Asaadkaadan/MOWE/Documentation/Images/proj_speed_test_2.png

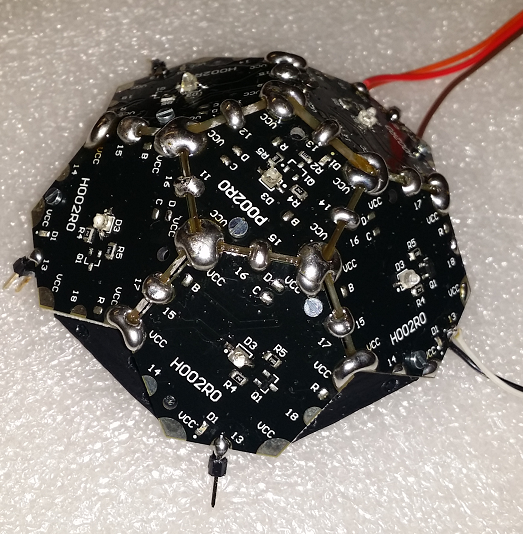
Documentation/Images/proj_speed_test_2.png
