Asaadkaadan/MOWE/Documentation/Images/proj_speed_test_1.png

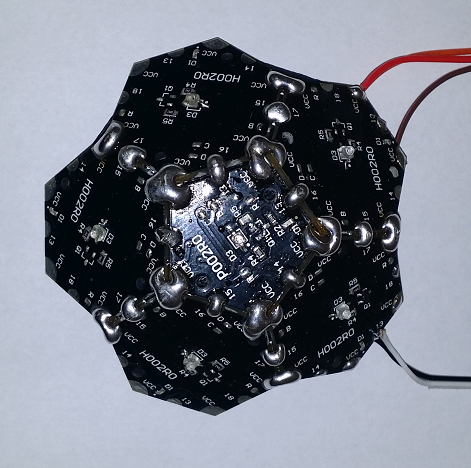
Documentation/Images/proj_speed_test_1.png
