Asaadkaadan/MOWE/Documentation/Images/bsubrun.gif

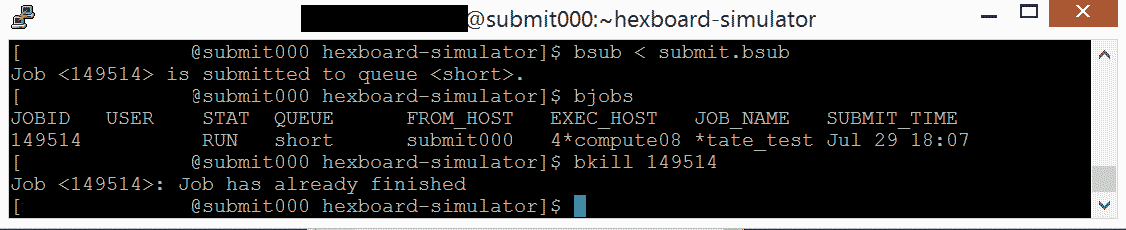
Documentation/Images/bsubrun.gif
