Asaadkaadan/MOWE/Documentation/Images/conn1.png

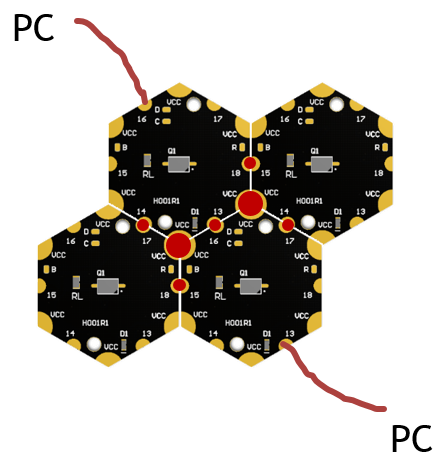
Documentation/Images/conn1.png
