Asaadkaadan/MOWE/Documentation/Images/conn2.png

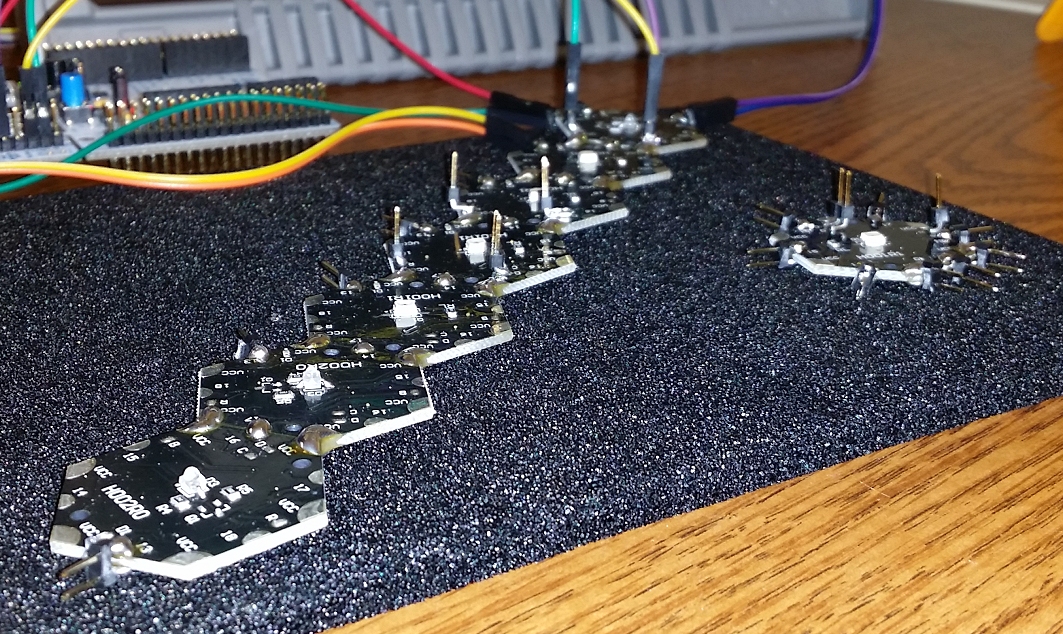
Documentation/Images/conn2.png
