Asaadkaadan/MOWE/Documentation/Images/conn3.png

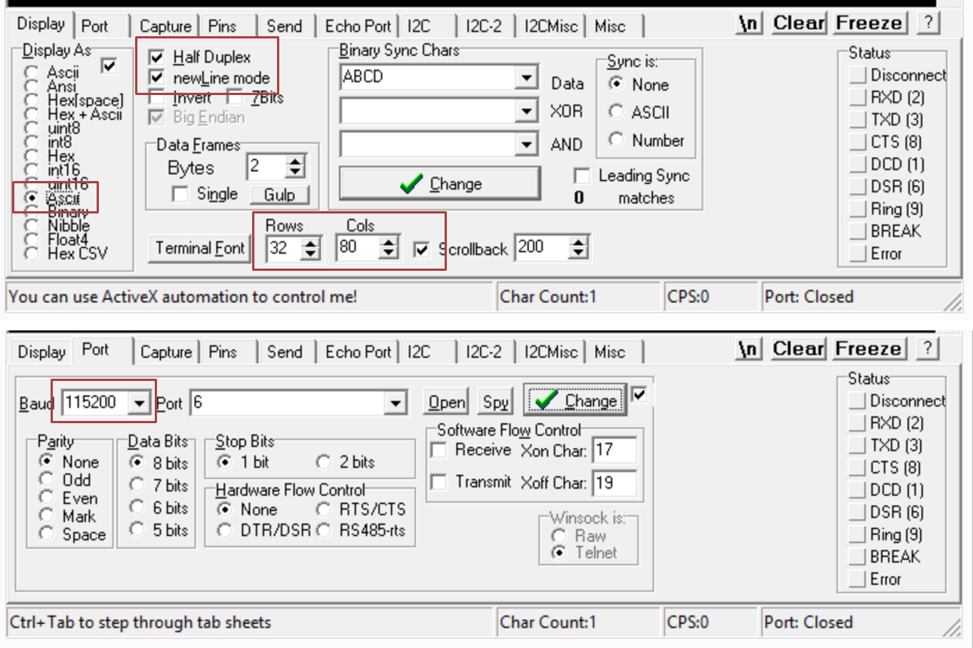
Documentation/Images/conn3.png
