Asaadkaadan/MOWE/Documentation/Images/conn4.png

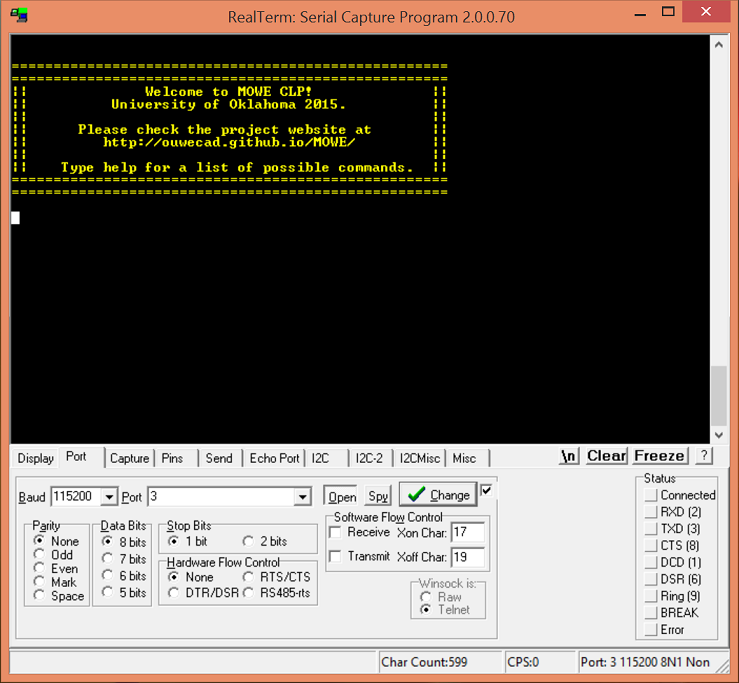
Documentation/Images/conn4.png
