Asaadkaadan/MOWE/Documentation/Images/Cygcheck.gif

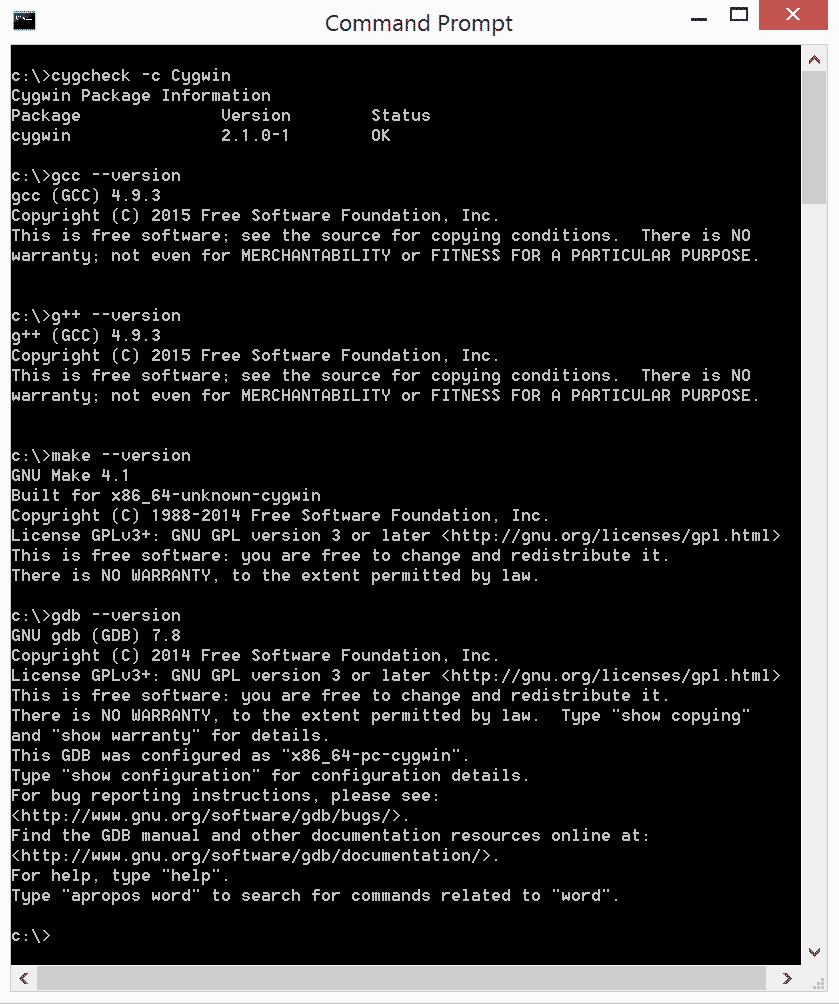
Documentation/Images/Cygcheck.gif
