Asaadkaadan/MOWE/Documentation/Images/CygwinOpenMPI.gif

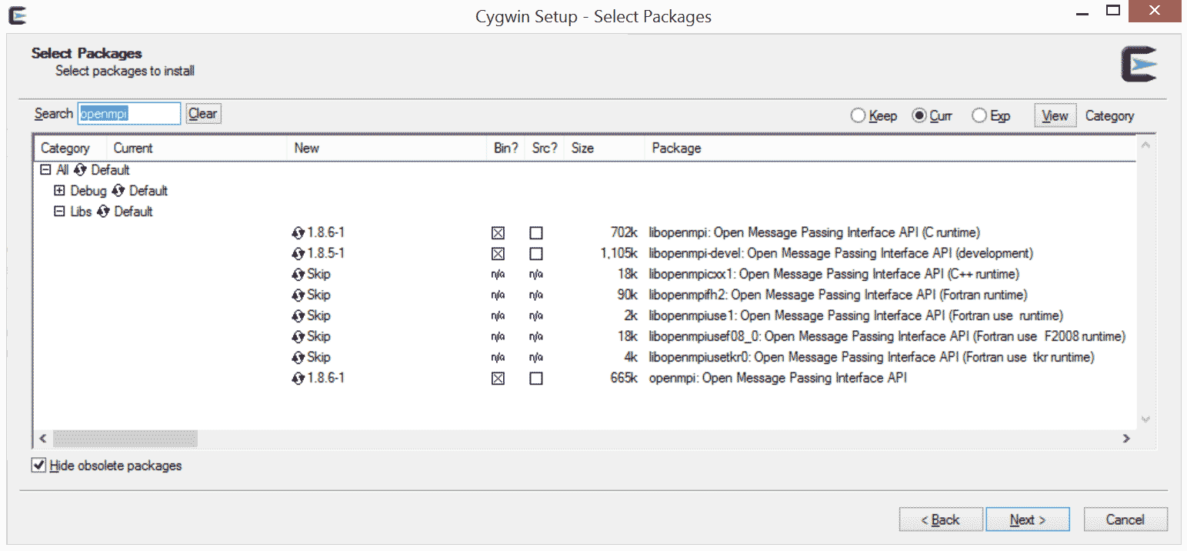
Documentation/Images/CygwinOpenMPI.gif
