Asaadkaadan/MOWE/Documentation/Images/Distance-VEMT3700-620Ohm-D25.png

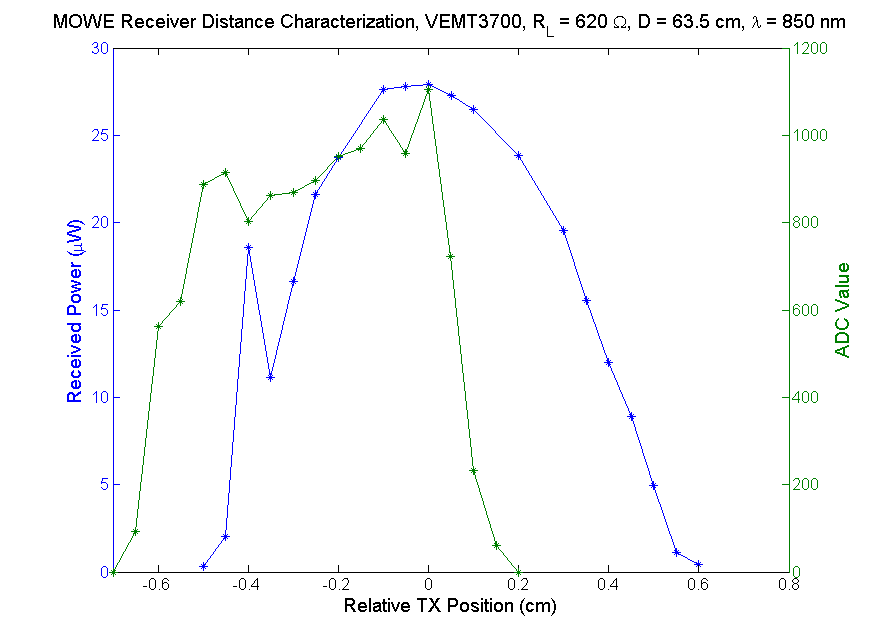
Documentation/Images/Distance-VEMT3700-620Ohm-D25.png
