Asaadkaadan/MOWE/Documentation/Images/Distance-VEMT3700-620Ohm-D43.png

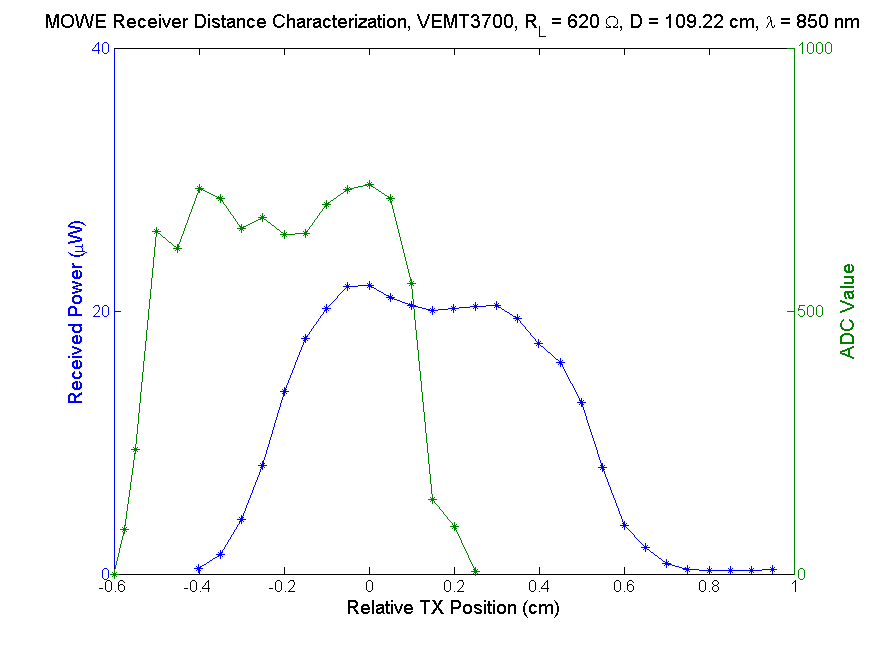
Documentation/Images/Distance-VEMT3700-620Ohm-D43.png
