Asaadkaadan/MOWE/Documentation/Images/Distance-VEMT3700-620Ohm-D64.png

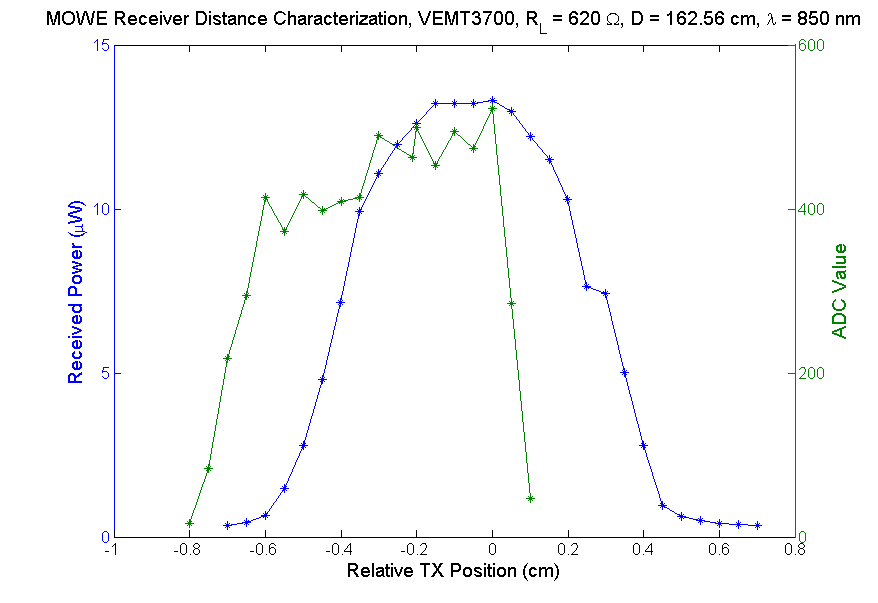
Documentation/Images/Distance-VEMT3700-620Ohm-D64.png
