Asaadkaadan/MOWE/Documentation/Images/Distance-VEMT3700F-620Ohm-D7.5.png

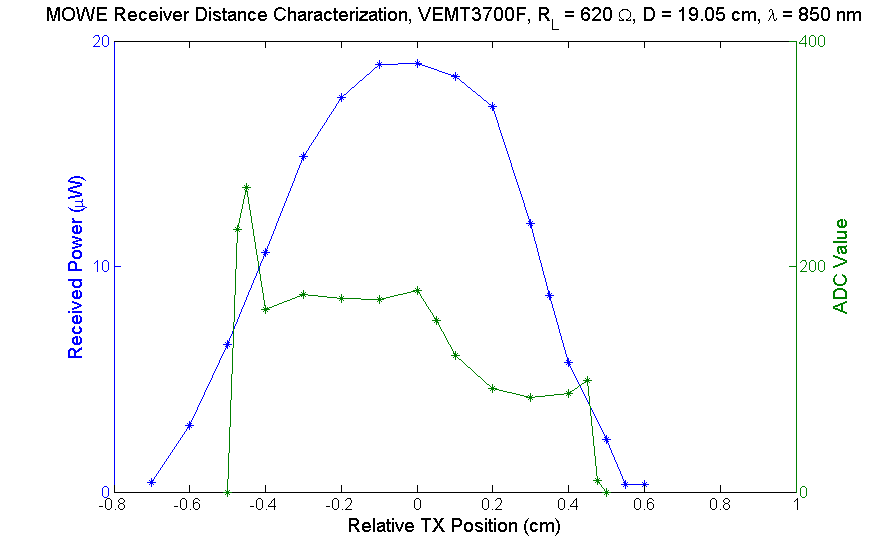
Documentation/Images/Distance-VEMT3700F-620Ohm-D7.5.png
