Asaadkaadan/MOWE/Documentation/Images/Distance-VEMT3700F-620Ohm-D64.png

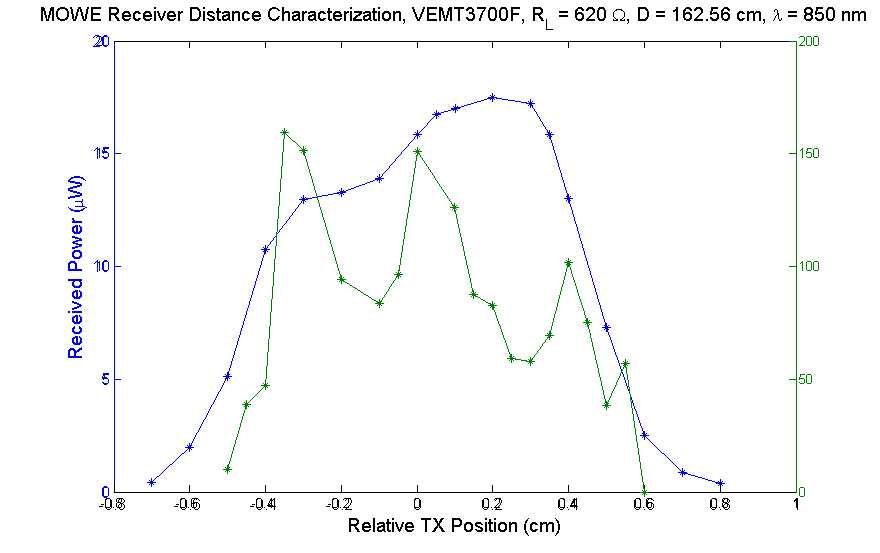
Documentation/Images/Distance-VEMT3700F-620Ohm-D64.png
