Asaadkaadan/MOWE/Documentation/Images/firm_boot.png

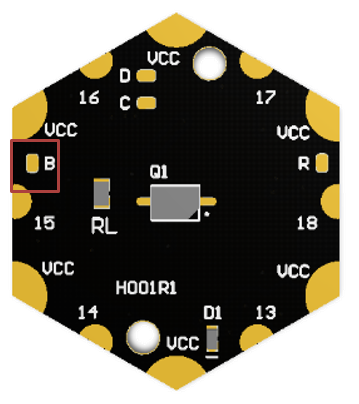
Documentation/Images/firm_boot.png
