Asaadkaadan/MOWE/Documentation/Images/Forge.gif

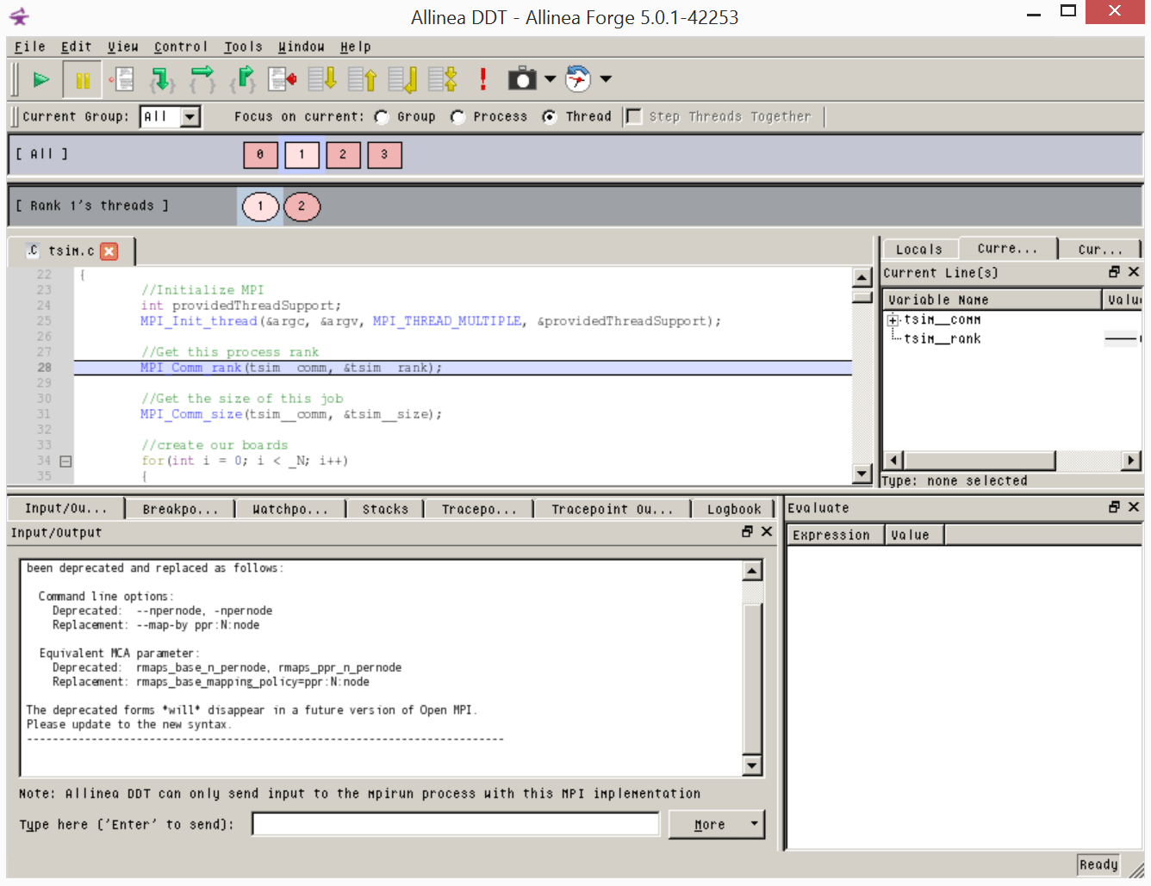
Documentation/Images/Forge.gif
