Asaadkaadan/MOWE/Documentation/Images/localrun1.gif

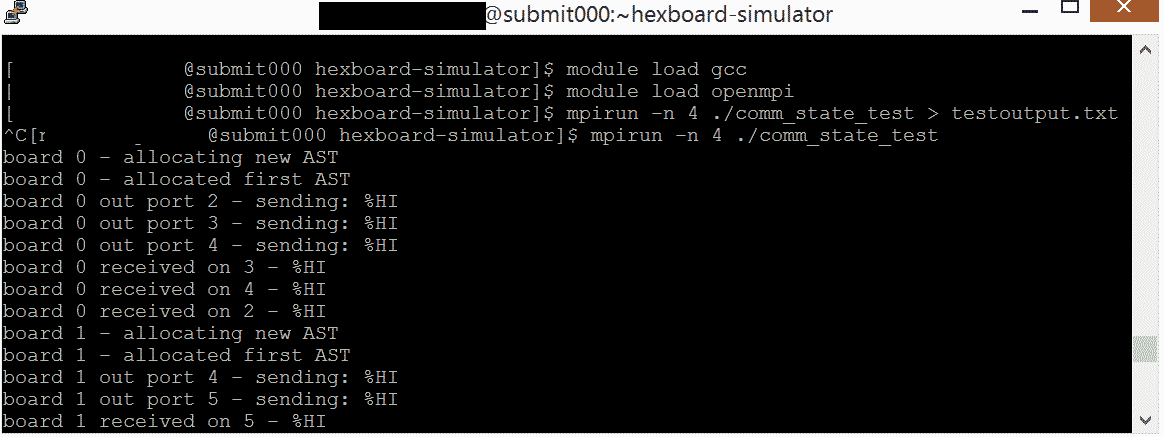
Documentation/Images/localrun1.gif
