Asaadkaadan/MOWE/Documentation/Images/localrun2.gif

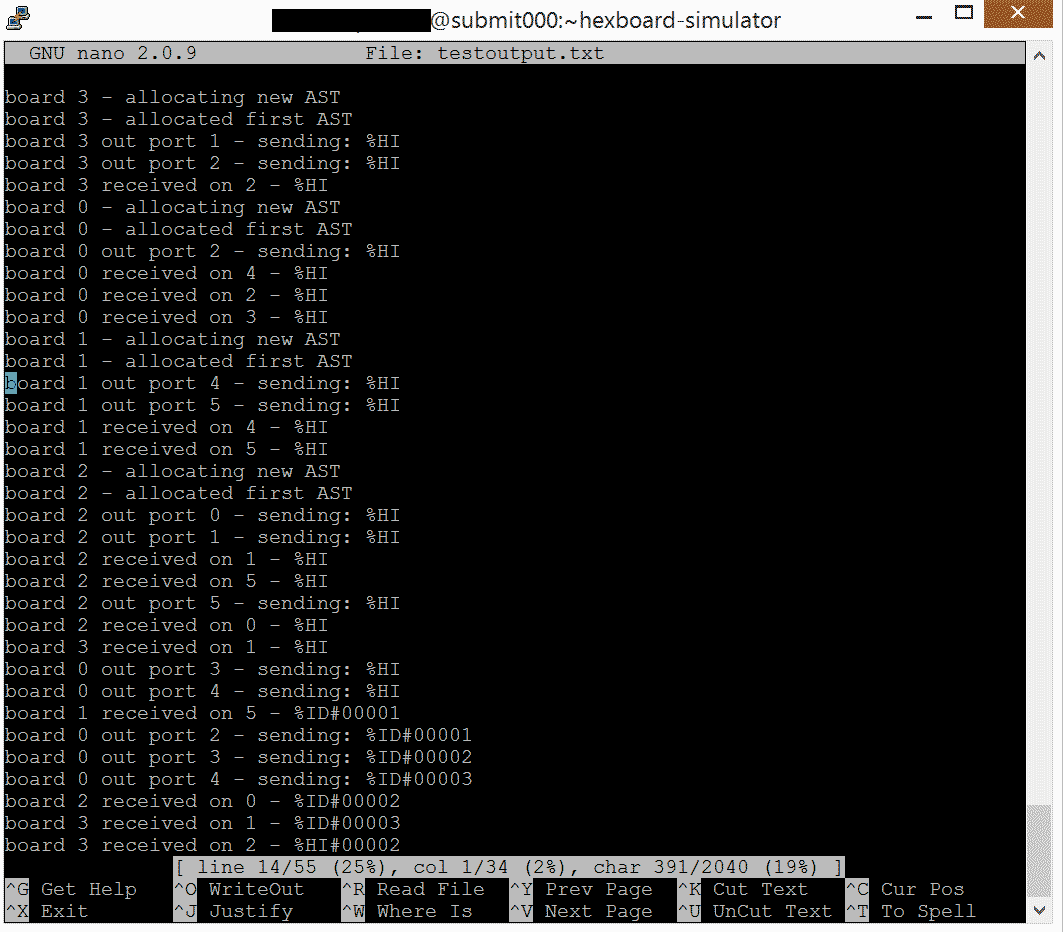
Documentation/Images/localrun2.gif
