Asaadkaadan/MOWE/Documentation/Images/Netbeans1.gif

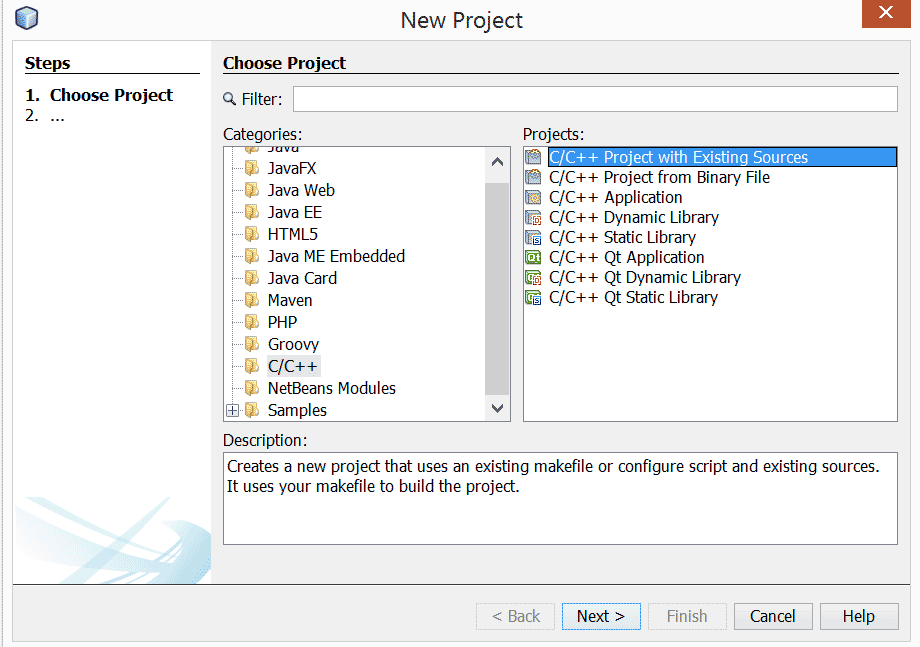
Documentation/Images/Netbeans1.gif
