Asaadkaadan/MOWE/Documentation/Images/Netbeans2.gif

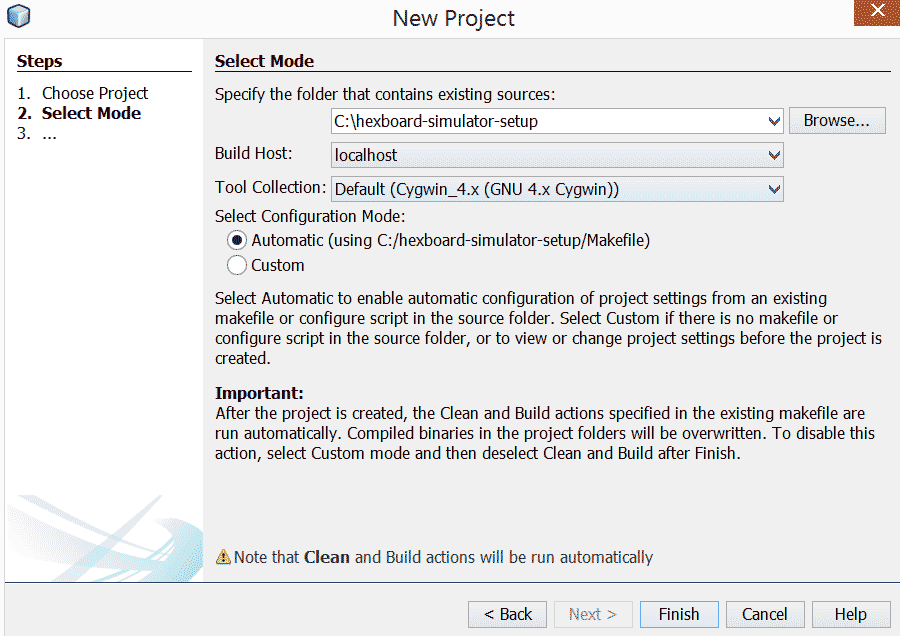
Documentation/Images/Netbeans2.gif
