Asaadkaadan/MOWE/Documentation/Images/Netbeans3.gif

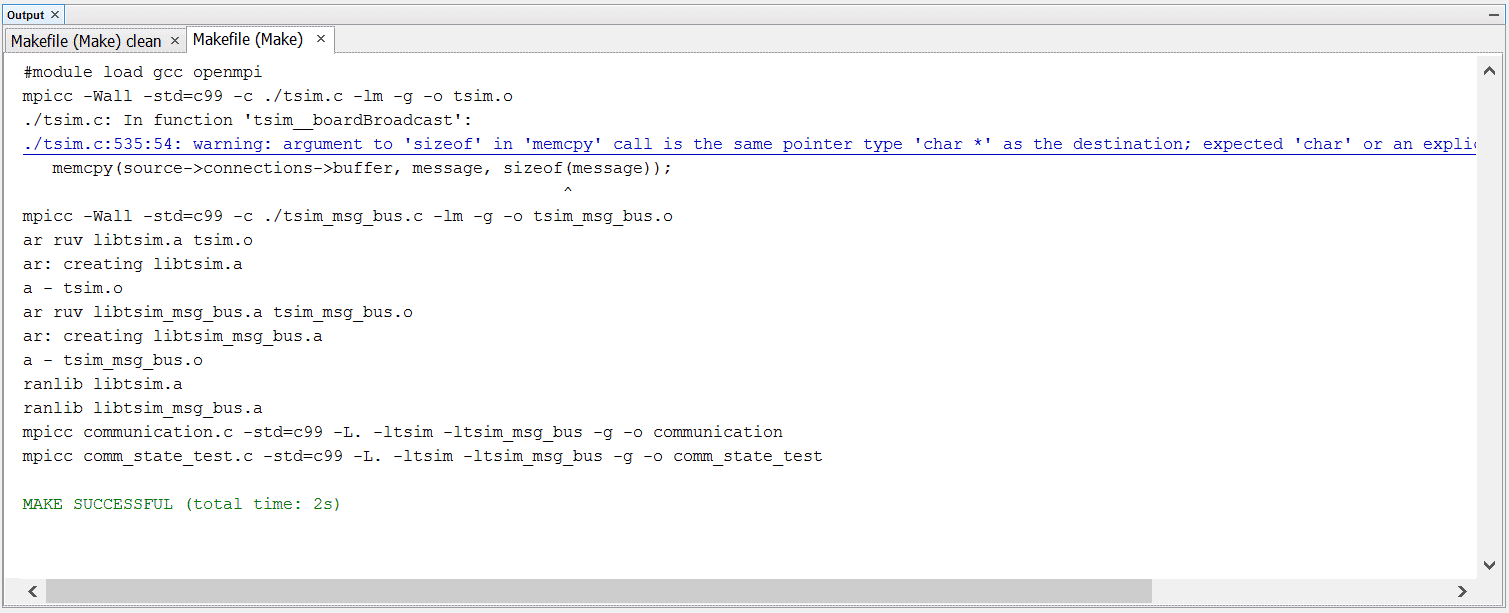
Documentation/Images/Netbeans3.gif
