Asaadkaadan/MOWE/Documentation/Images/NetbeansInterface.gif

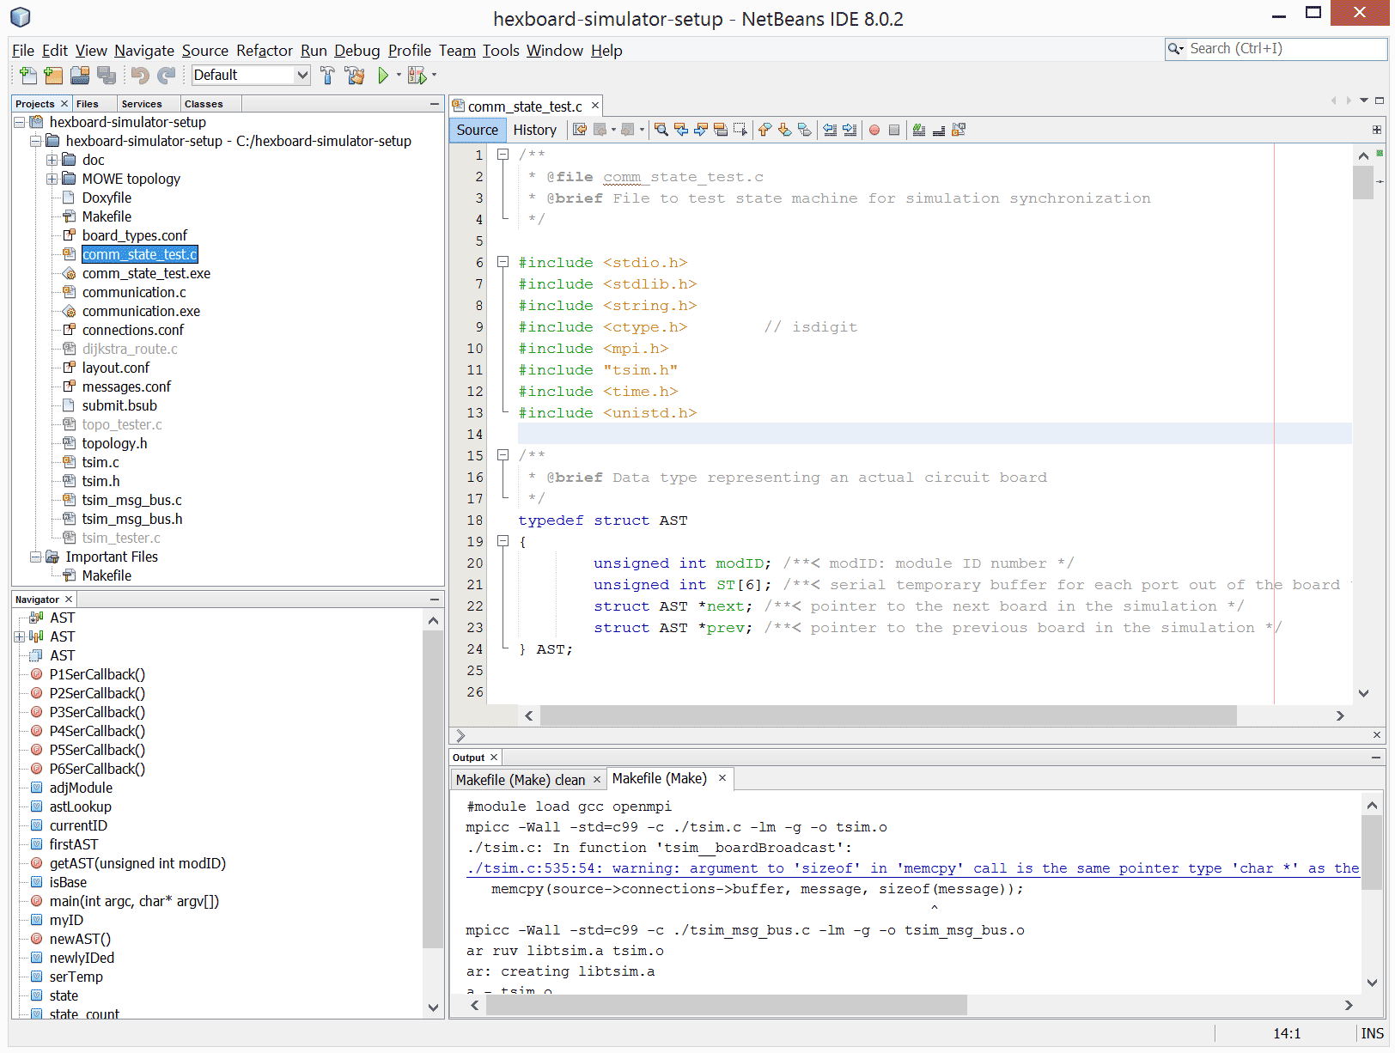
Documentation/Images/NetbeansInterface.gif
