Asaadkaadan/MOWE/Documentation/Images/overview.png

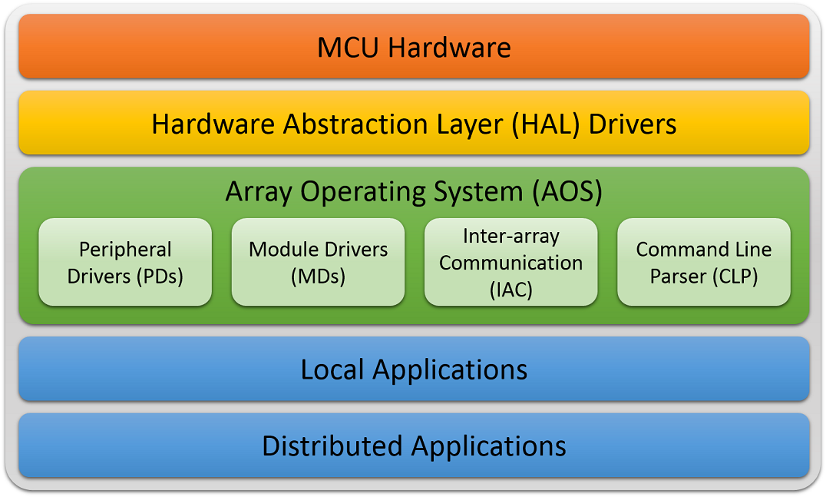
Documentation/Images/overview.png
