Asaadkaadan/MOWE/Documentation/Images/Path.gif

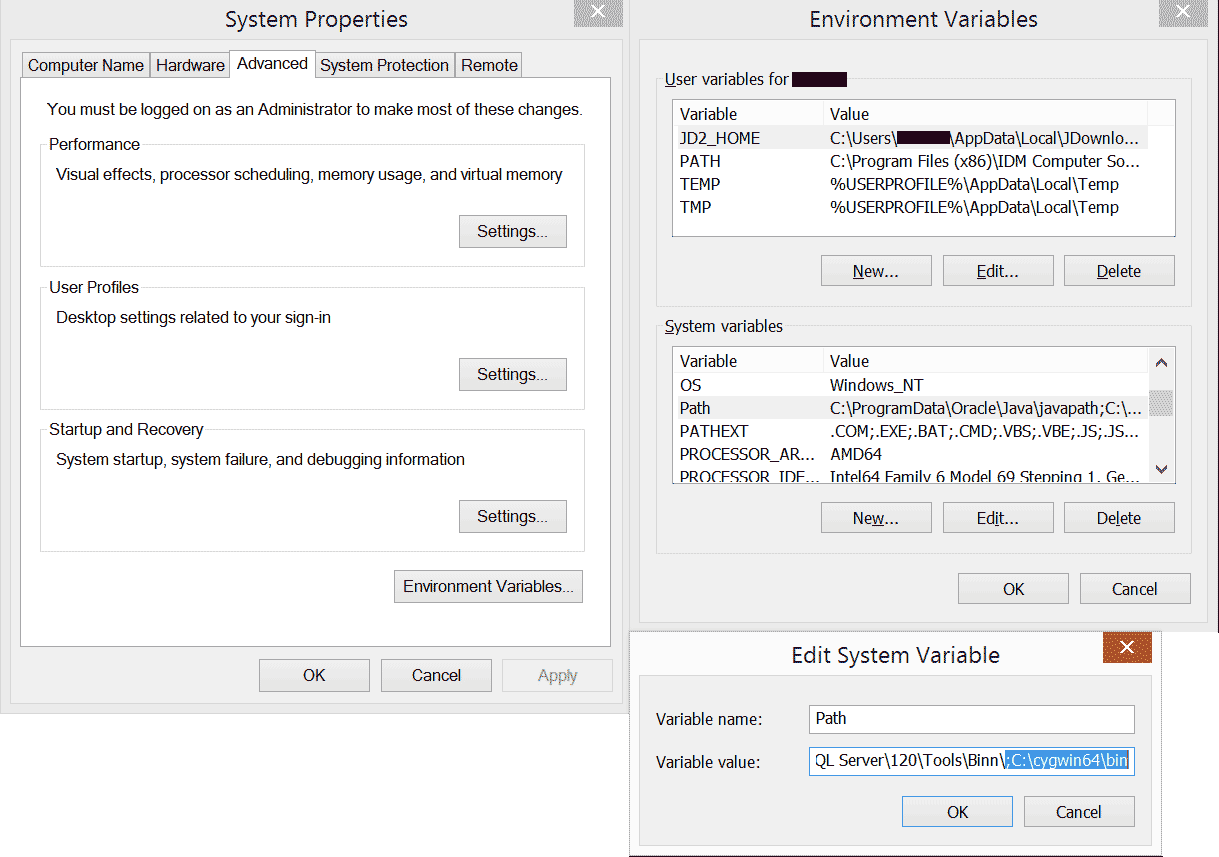
Documentation/Images/Path.gif
