Asaadkaadan/MOWE/Documentation/Images/Putty1.gif

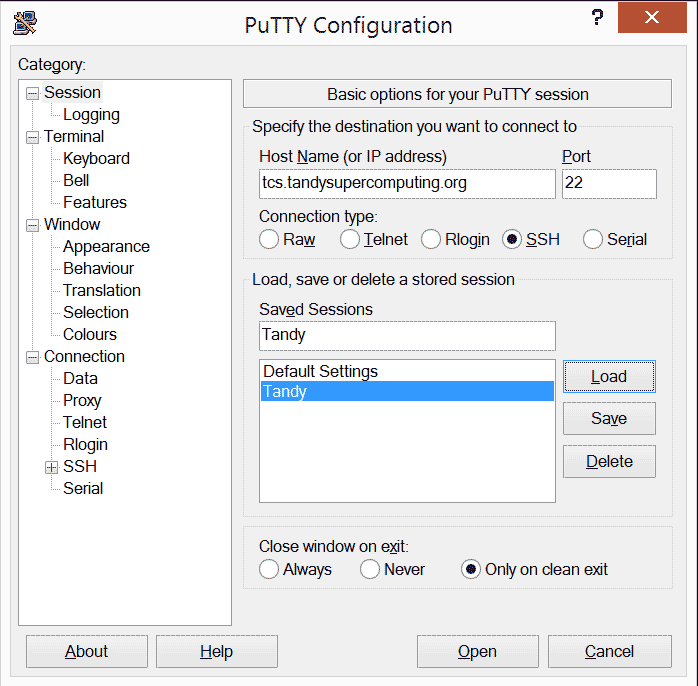
Documentation/Images/Putty1.gif
