Asaadkaadan/MOWE/Documentation/Images/Putty2.gif

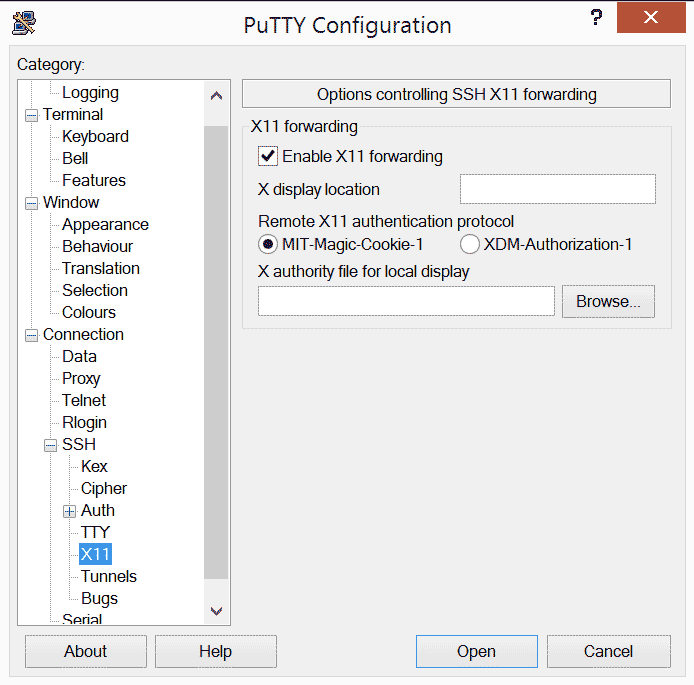
Documentation/Images/Putty2.gif
