Asaadkaadan/MOWE/Documentation/Images/Putty3.gif

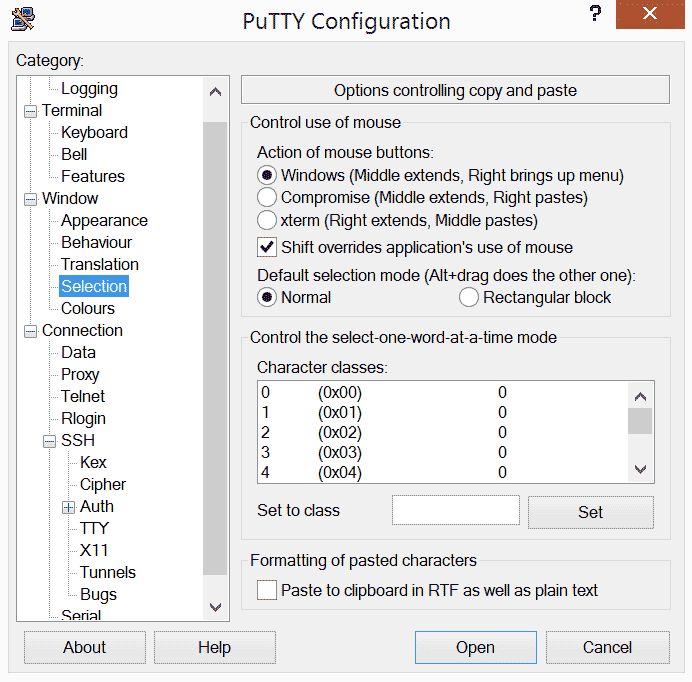
Documentation/Images/Putty3.gif
