Asaadkaadan/MOWE/Documentation/Images/submit.bsub.gif

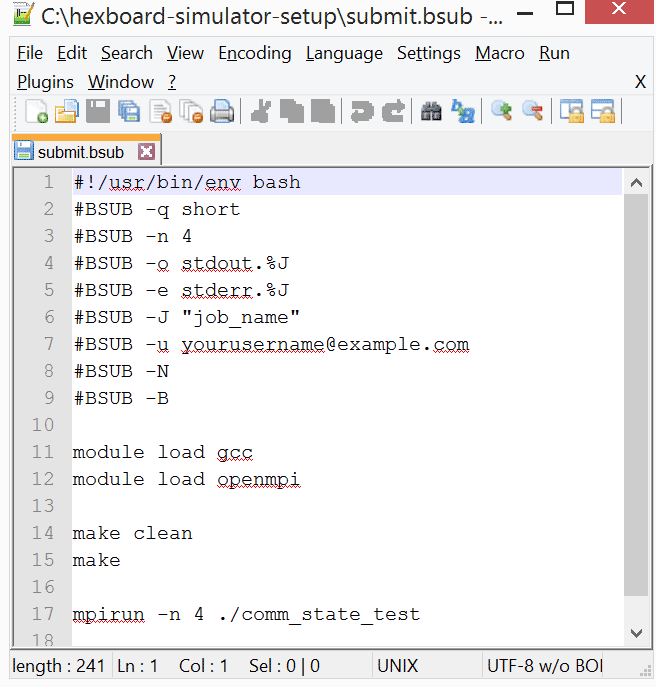
Documentation/Images/submit.bsub.gif
