Asaadkaadan/MOWE/Documentation/Images/Valgrind.gif

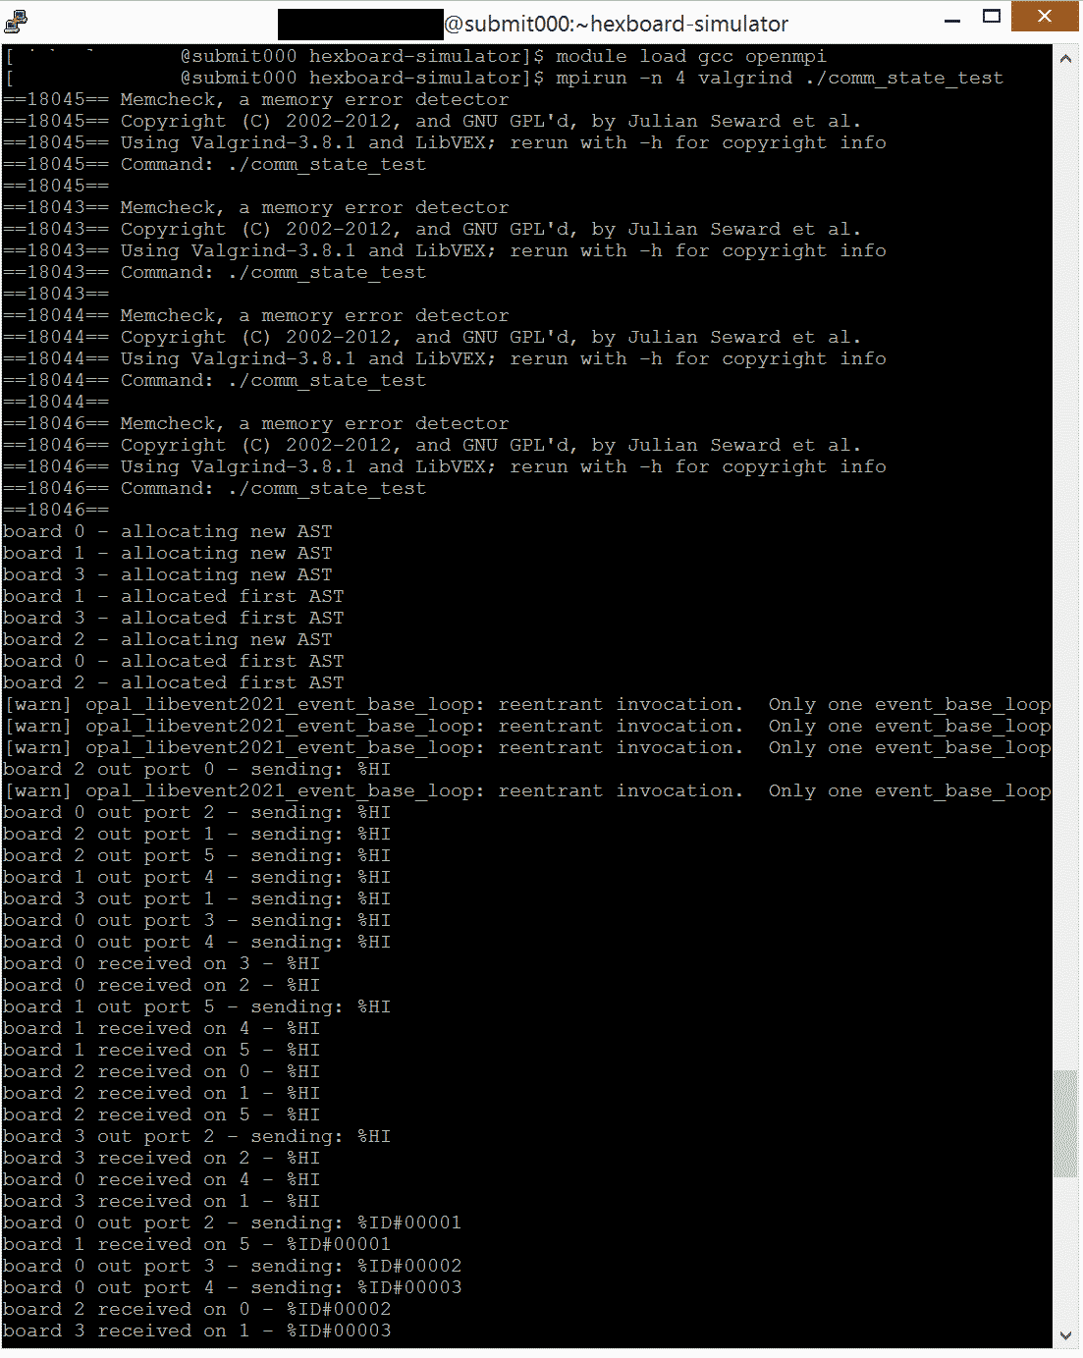
Documentation/Images/Valgrind.gif
