Asaadkaadan/MOWE/Documentation/Images/WinSCP.gif

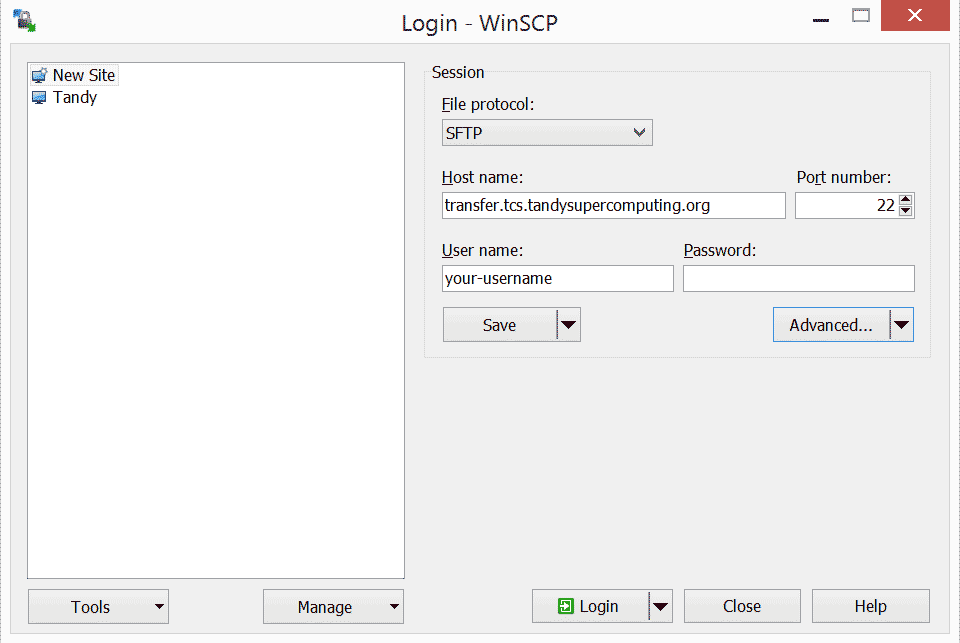
Documentation/Images/WinSCP.gif
