Asaadkaadan/MOWE/Documentation/Images/WinSCPXfer.gif

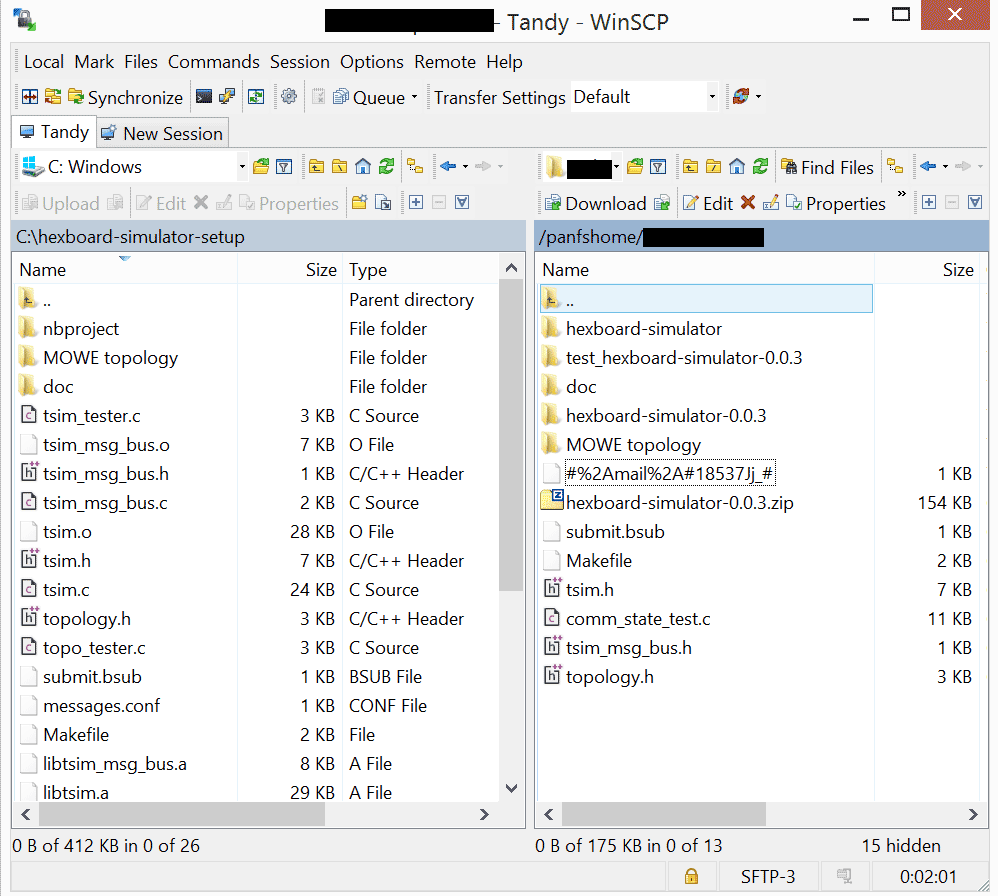
Documentation/Images/WinSCPXfer.gif
