Asaadkaadan/MOWE/Documentation/MOWE GC2015.jpg

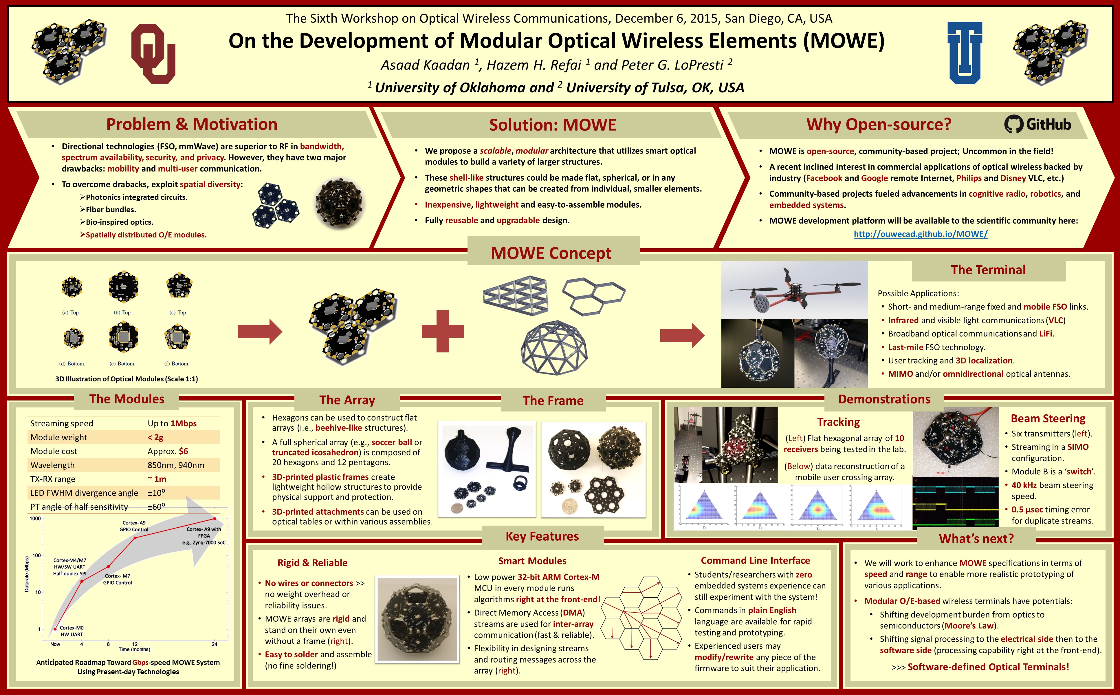
Documentation/MOWE GC2015.jpg
