Asaadkaadan/MOWE/Projects/12 Inhomogeneous Array/Pictures/1.jpg

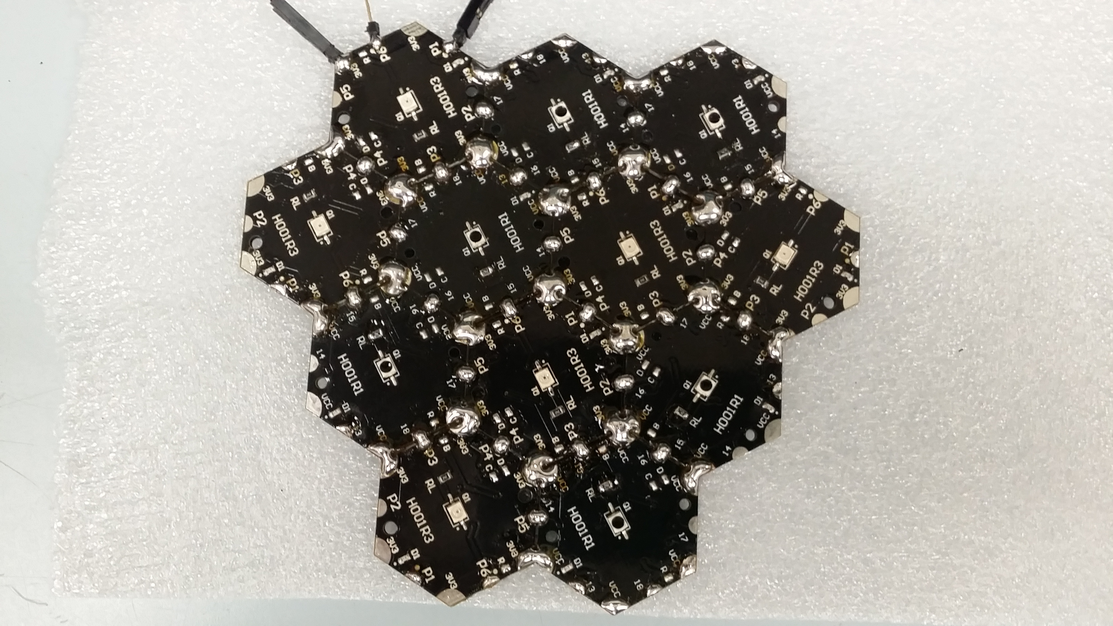
Projects/12 Inhomogeneous Array/Pictures/1.jpg
