Asaadkaadan/MOWE/Projects/12 Inhomogeneous Array/Pictures/2.jpg

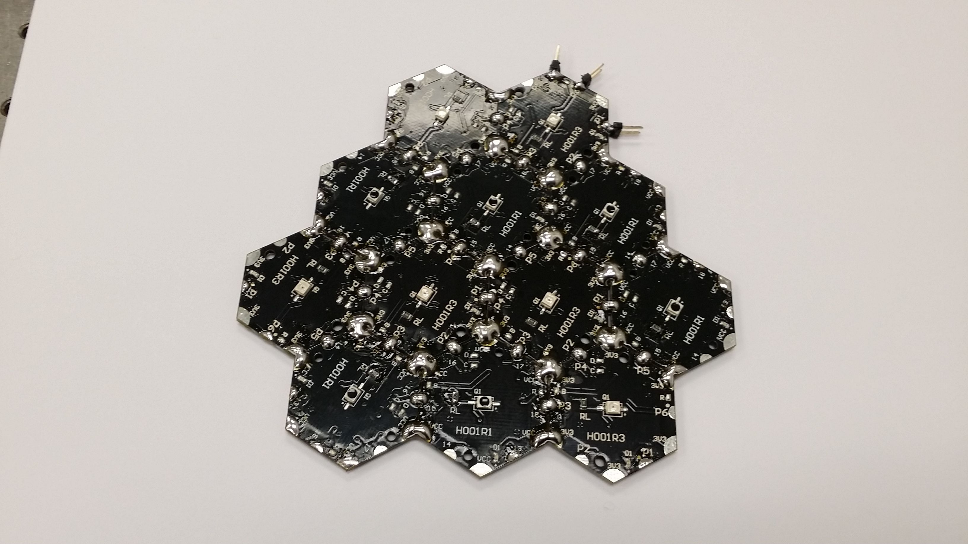
Projects/12 Inhomogeneous Array/Pictures/2.jpg
