Asaadkaadan/MOWE/Projects/12 Inhomogeneous Array/Pictures/3.jpg

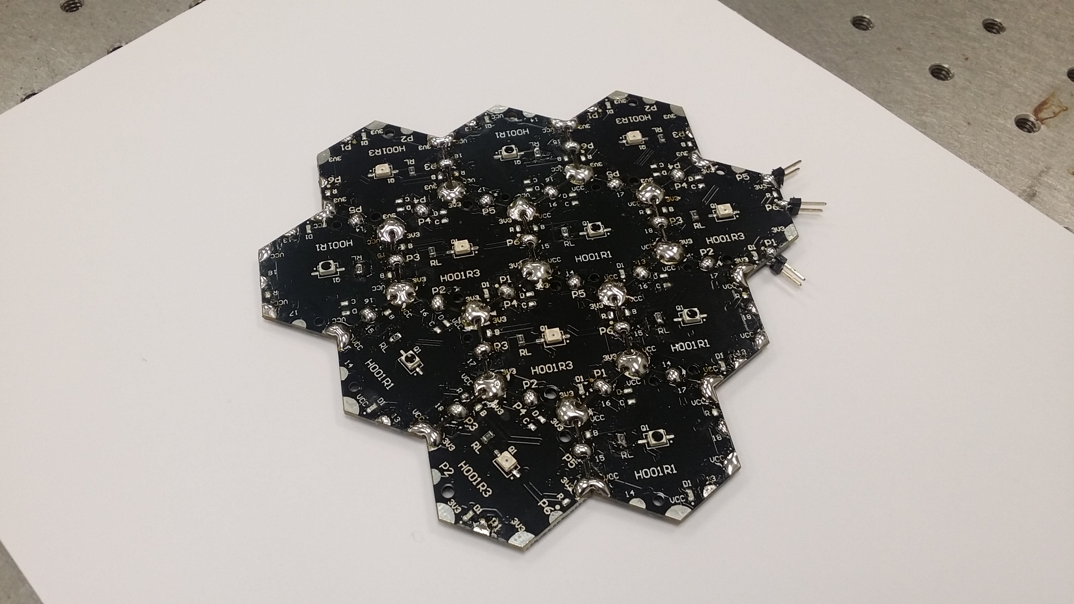
Projects/12 Inhomogeneous Array/Pictures/3.jpg
