Asaadkaadan/MOWE/Projects/12 Inhomogeneous Array/Pictures/4.png

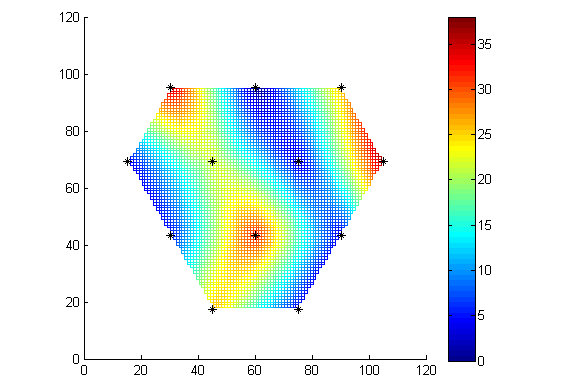
Projects/12 Inhomogeneous Array/Pictures/4.png
