Asaadkaadan/MOWE/Projects/12 Inhomogeneous Array/Pictures/5.png

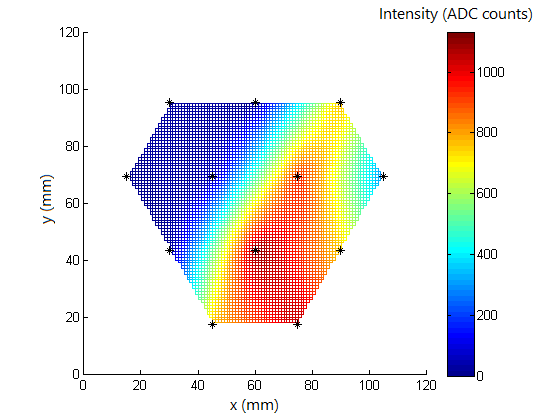
Projects/12 Inhomogeneous Array/Pictures/5.png
