Asaadkaadan/MOWE/Projects/12 Inhomogeneous Array/Pictures/6.jpg

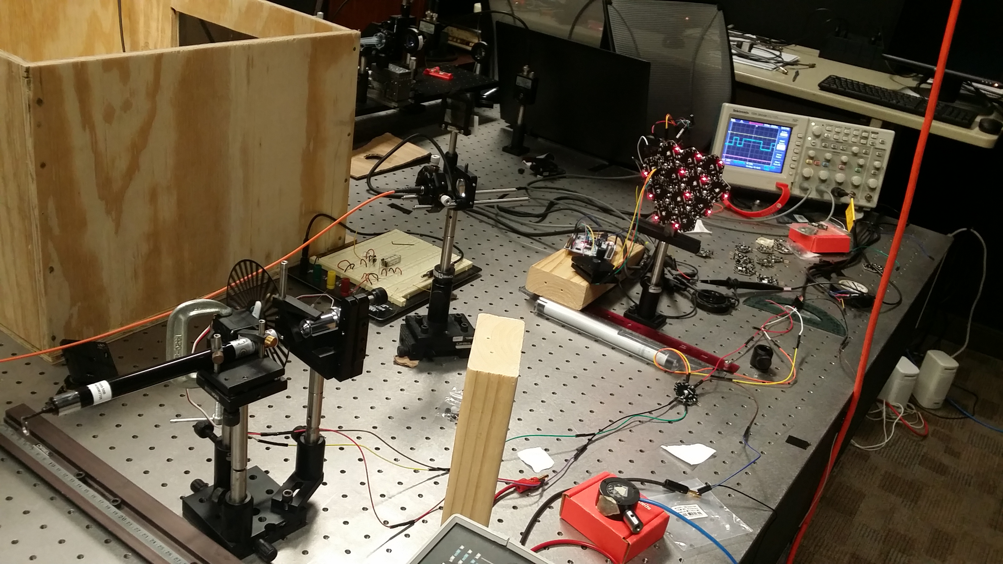
Projects/12 Inhomogeneous Array/Pictures/6.jpg
