Asaadkaadan/MOWE/Projects/12 Inhomogeneous Array/Pictures/F0000TEK.JPG

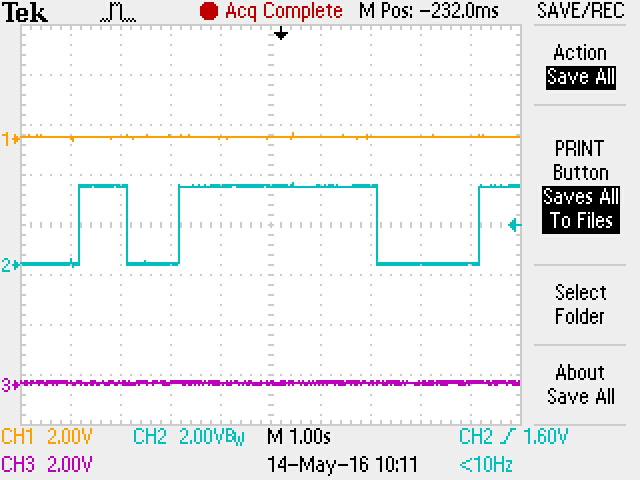
Projects/12 Inhomogeneous Array/Pictures/F0000TEK.JPG
