Asaadkaadan/MOWE/Projects/12 Inhomogeneous Array/Pictures/F0001TEK.JPG

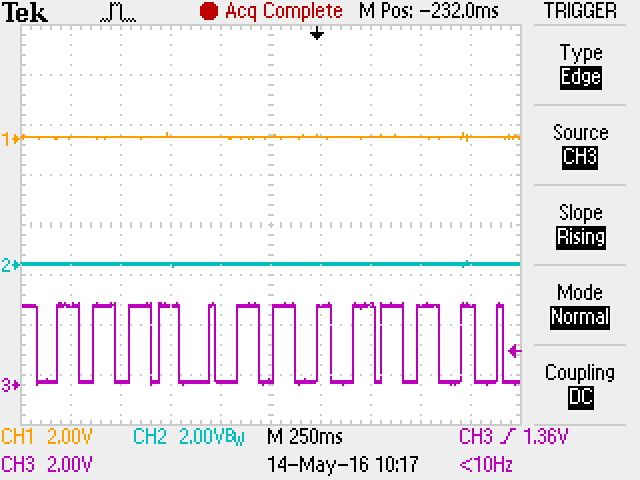
Projects/12 Inhomogeneous Array/Pictures/F0001TEK.JPG
