Asaadkaadan/MOWE/Projects/12 Inhomogeneous Array/Pictures/F0002TEK.JPG

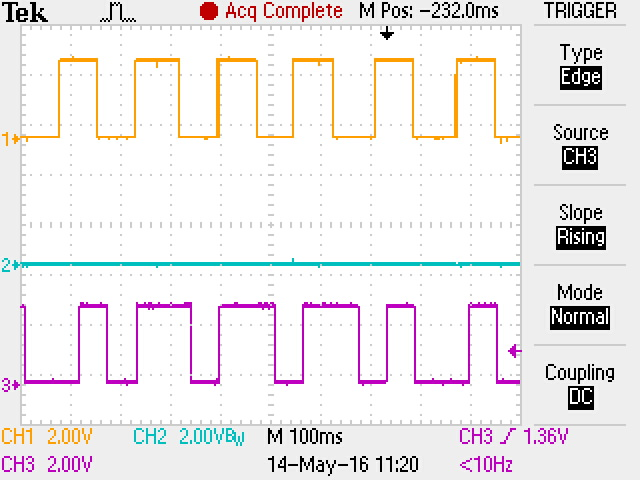
Projects/12 Inhomogeneous Array/Pictures/F0002TEK.JPG
