Asaadkaadan/MOWE/Projects/12 Inhomogeneous Array/Pictures/F0003TEK.JPG

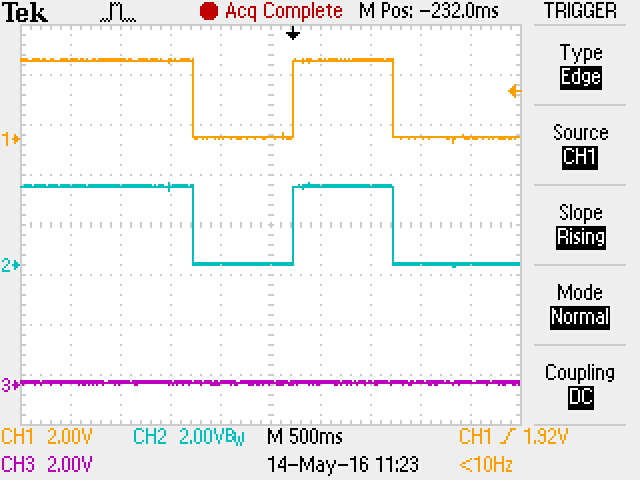
Projects/12 Inhomogeneous Array/Pictures/F0003TEK.JPG
