Asaadkaadan/MOWE/Projects/12 Inhomogeneous Array/Pictures/F0004TEK.JPG

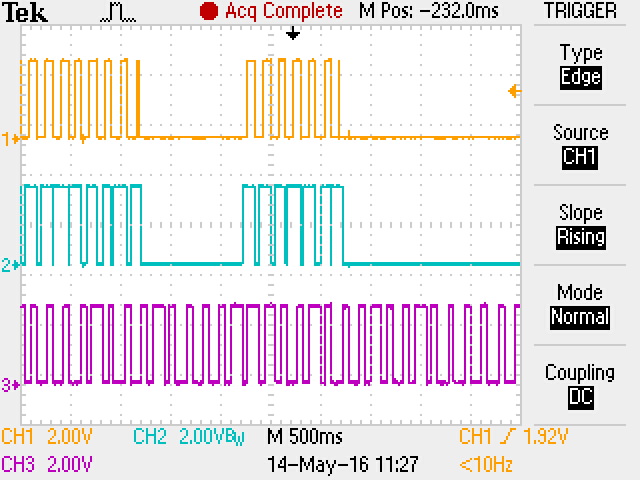
Projects/12 Inhomogeneous Array/Pictures/F0004TEK.JPG
