Asaadkaadan/MOWE/Projects/12 Inhomogeneous Array/Pictures/F0005TEK.JPG

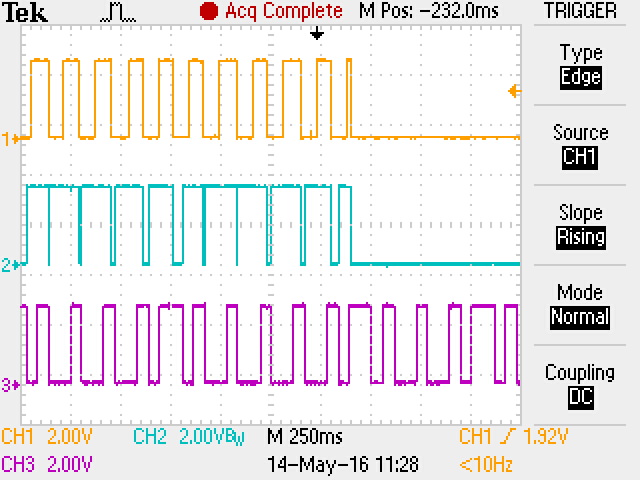
Projects/12 Inhomogeneous Array/Pictures/F0005TEK.JPG
