Asaadkaadan/MOWE/Projects/12 Inhomogeneous Array/Pictures/F0007TEK.JPG

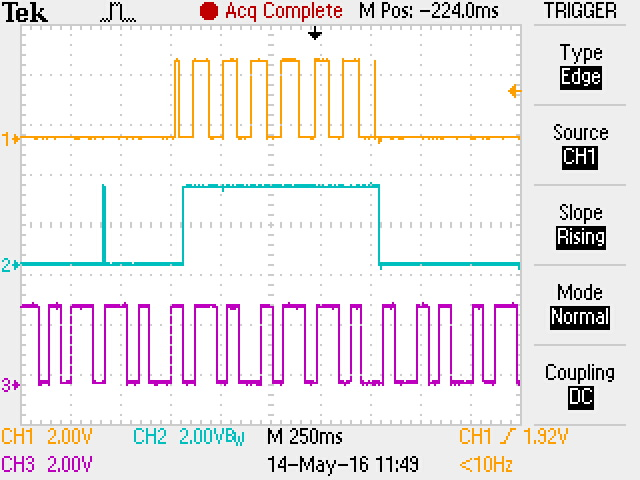
Projects/12 Inhomogeneous Array/Pictures/F0007TEK.JPG
