Asaadkaadan/MOWE/Projects/12 Inhomogeneous Array/Pictures/F0008TEK.JPG

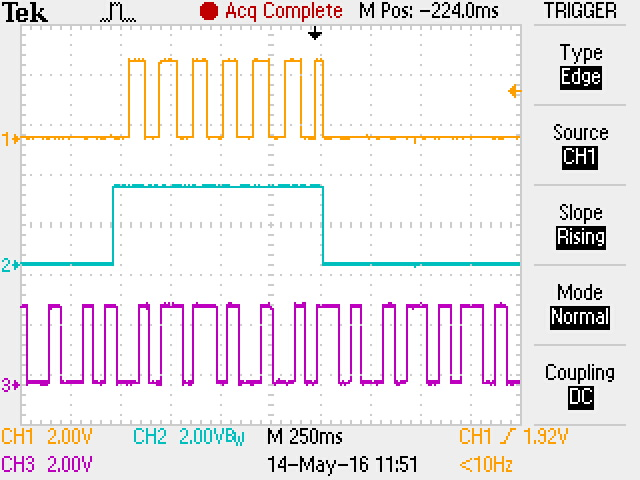
Projects/12 Inhomogeneous Array/Pictures/F0008TEK.JPG
