Asaadkaadan/MOWE/Projects/12 Inhomogeneous Array/Pictures/F0009TEK.JPG

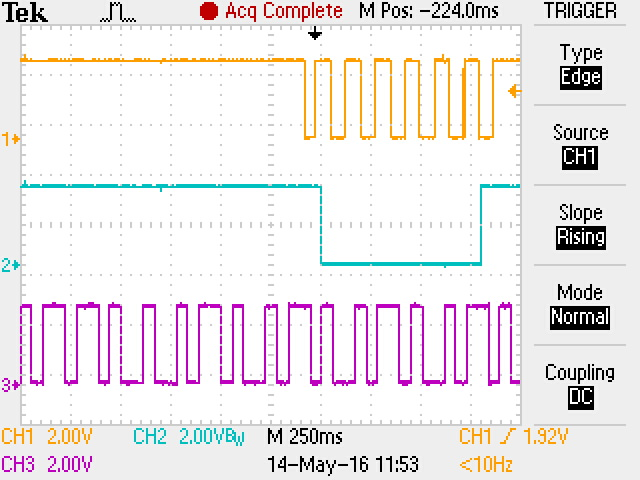
Projects/12 Inhomogeneous Array/Pictures/F0009TEK.JPG
