Asaadkaadan/MOWE/Projects/12 Inhomogeneous Array/Pictures/F0010TEK.JPG

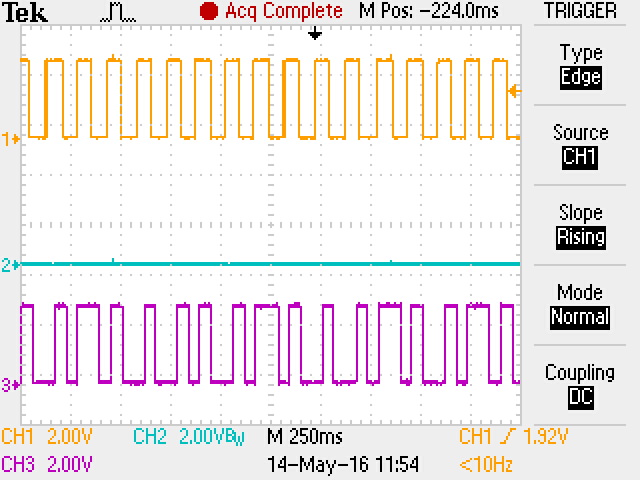
Projects/12 Inhomogeneous Array/Pictures/F0010TEK.JPG
