Asaadkaadan/MOWE/Projects/12 Inhomogeneous Array/Pictures/F0011TEK.JPG

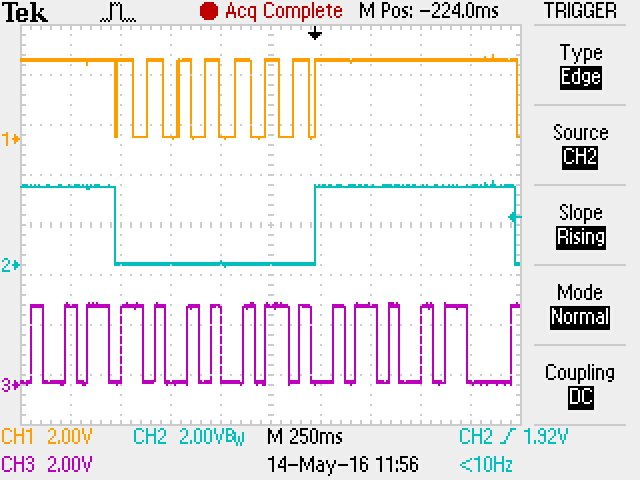
Projects/12 Inhomogeneous Array/Pictures/F0011TEK.JPG
