Asaadkaadan/MOWE/Projects/12 Inhomogeneous Array/Pictures/F0012TEK.JPG

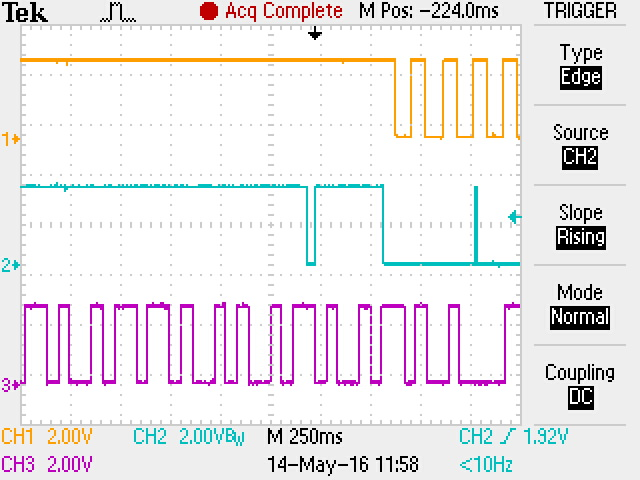
Projects/12 Inhomogeneous Array/Pictures/F0012TEK.JPG
