Asaadkaadan/MOWE/Projects/12 Inhomogeneous Array/Pictures/F0013TEK.JPG

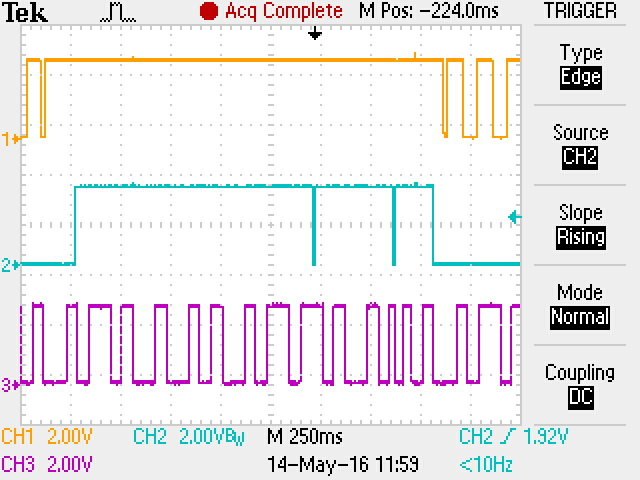
Projects/12 Inhomogeneous Array/Pictures/F0013TEK.JPG
