Asaadkaadan/MOWE/Projects/12 Inhomogeneous Array/Pictures/F0014TEK.JPG

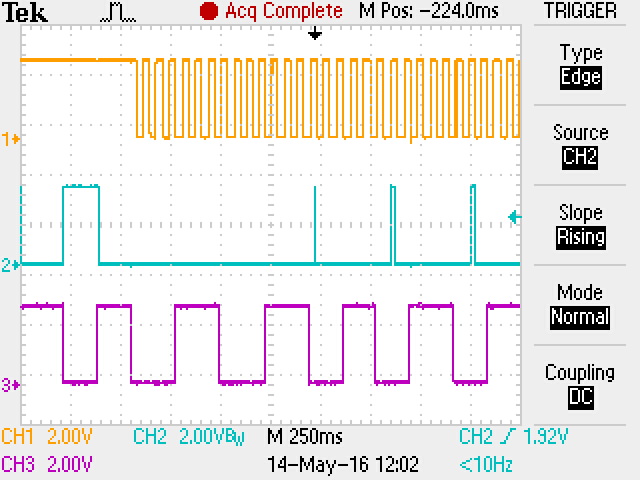
Projects/12 Inhomogeneous Array/Pictures/F0014TEK.JPG
