Asaadkaadan/MOWE/Projects/12 Inhomogeneous Array/Pictures/F0015TEK.JPG

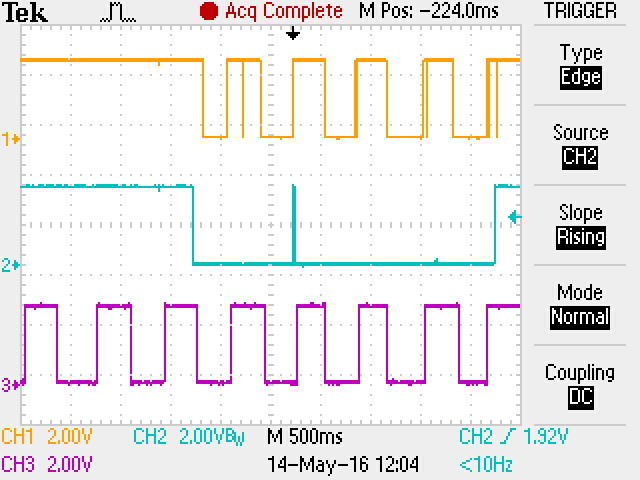
Projects/12 Inhomogeneous Array/Pictures/F0015TEK.JPG
