Asaadkaadan/MOWE/Projects/12 Inhomogeneous Array/Pictures/F0016TEK.JPG

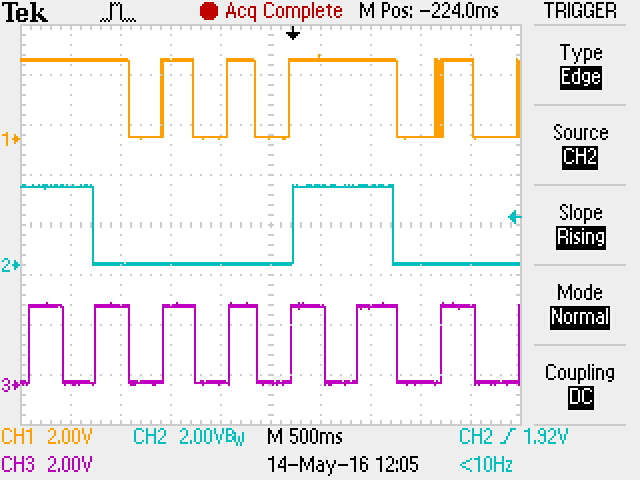
Projects/12 Inhomogeneous Array/Pictures/F0016TEK.JPG
