Asaadkaadan/MOWE/Projects/20 Spherical Detector Array/Mechanical/HO01R1.JPG

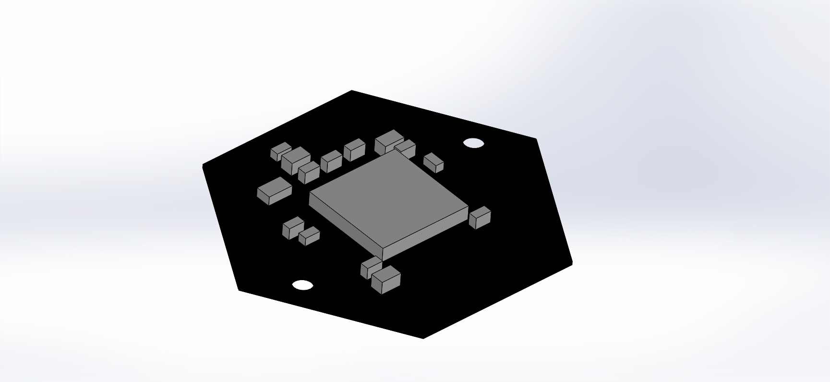
Projects/20 Spherical Detector Array/Mechanical/HO01R1.JPG
