Asaadkaadan/MOWE/Projects/20 Spherical Detector Array/Mechanical/optical_table_holder_100m.JPG

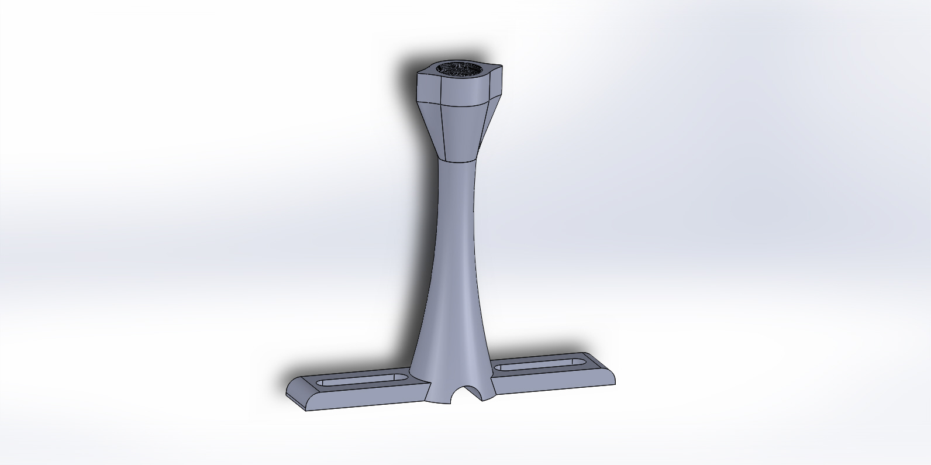
Projects/20 Spherical Detector Array/Mechanical/optical_table_holder_100m.JPG
