Asaadkaadan/MOWE/Projects/20 Spherical Detector Array/Mechanical/optical_table_holder_150m_quad.JPG

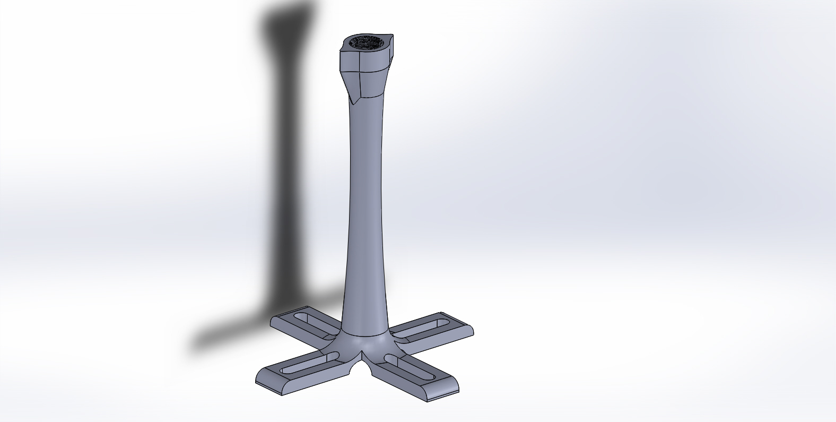
Projects/20 Spherical Detector Array/Mechanical/optical_table_holder_150m_quad.JPG
