Asaadkaadan/MOWE/Projects/20 Spherical Detector Array/Mechanical/PO02R0.JPG

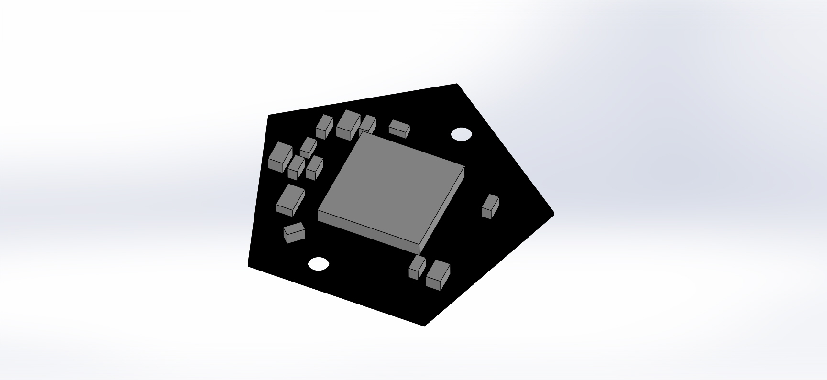
Projects/20 Spherical Detector Array/Mechanical/PO02R0.JPG
