Asaadkaadan/MOWE/Projects/20 Spherical Detector Array/Mechanical/Sphere Frame.JPG

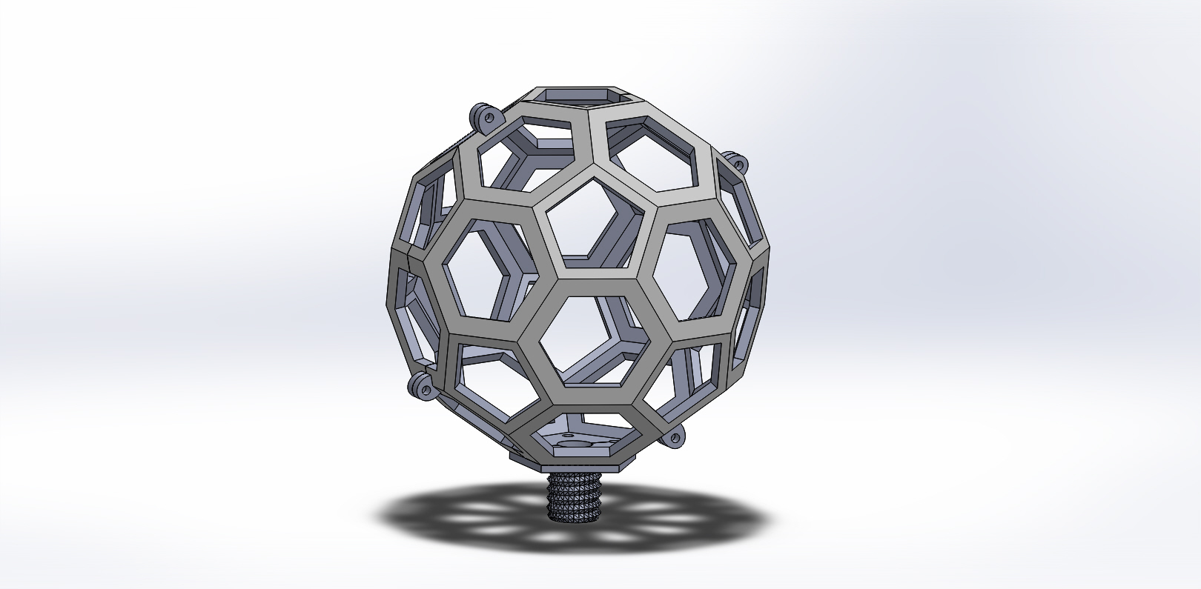
Projects/20 Spherical Detector Array/Mechanical/Sphere Frame.JPG
