Asaadkaadan/MOWE/Projects/20 Spherical Detector Array/Mechanical/sphere_30mm.JPG

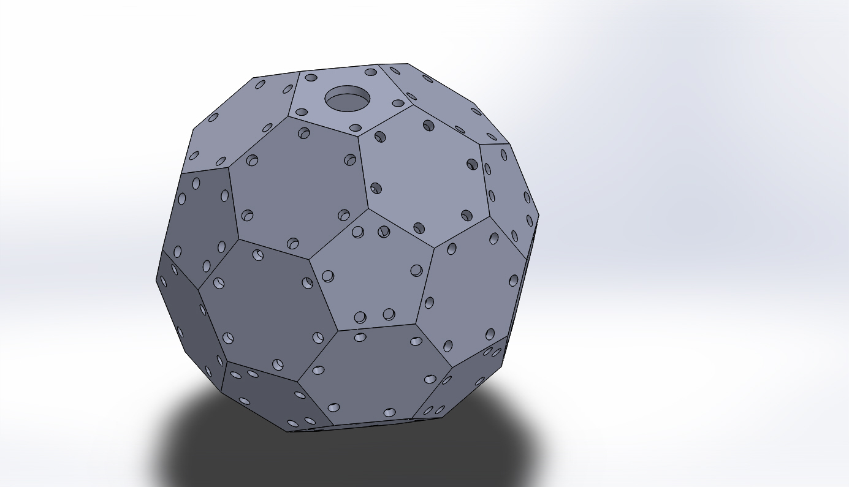
Projects/20 Spherical Detector Array/Mechanical/sphere_30mm.JPG
