Asaadkaadan/MOWE/Projects/20 Spherical Detector Array/Mechanical/Truncated icosahedron shell.JPG

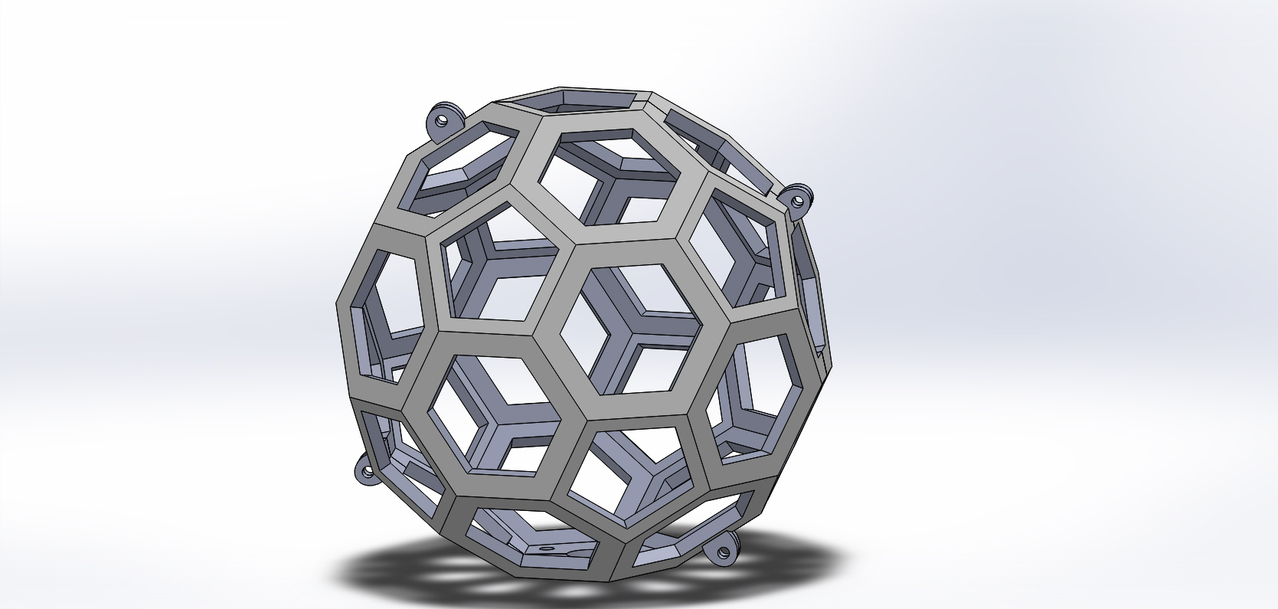
Projects/20 Spherical Detector Array/Mechanical/Truncated icosahedron shell.JPG
