Asaadkaadan/MOWE/Projects/20 Spherical Detector Array/Mechanical/Truncated icosahedron.JPG

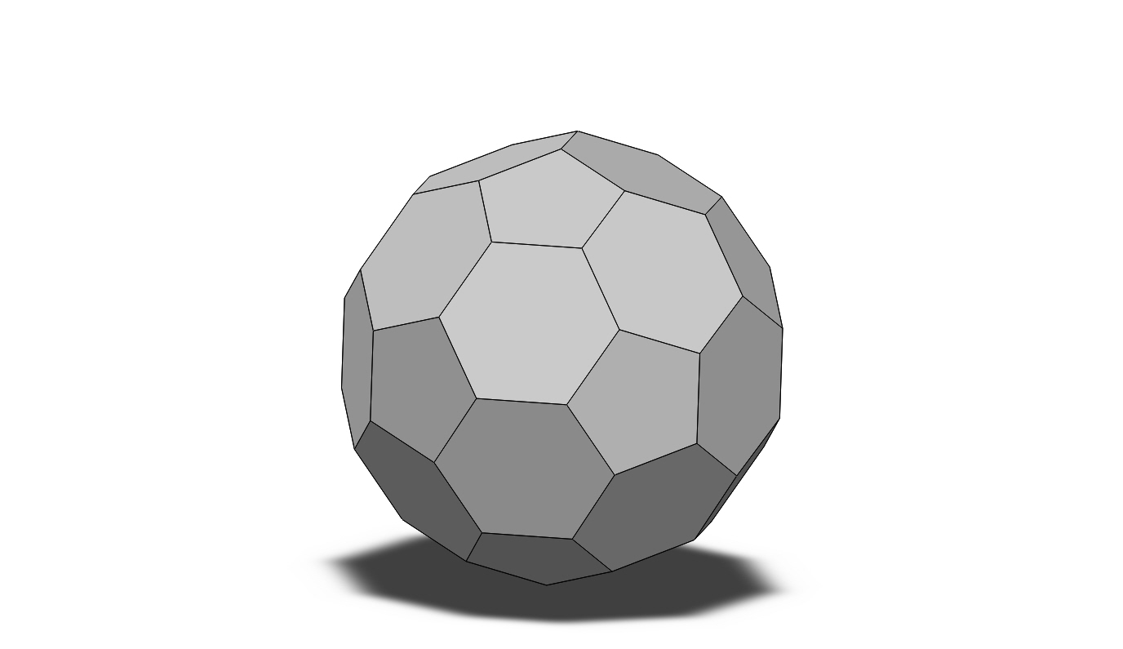
Projects/20 Spherical Detector Array/Mechanical/Truncated icosahedron.JPG
