Asaadkaadan/MOWE/Projects/20 Spherical Detector Array/Pictures/1.jpg

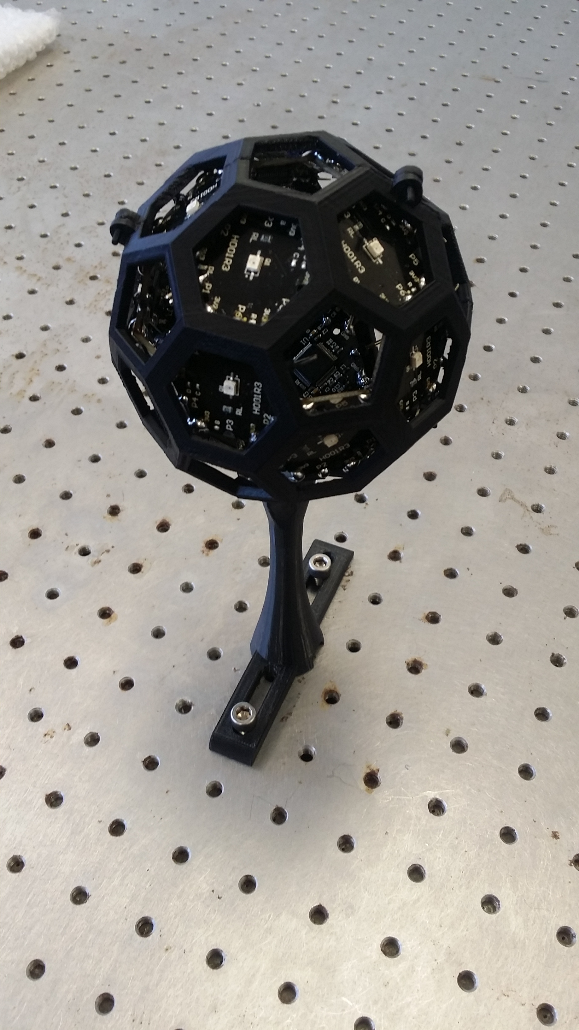
Projects/20 Spherical Detector Array/Pictures/1.jpg
