Asaadkaadan/MOWE/Projects/20 Spherical Detector Array/Pictures/2.jpg

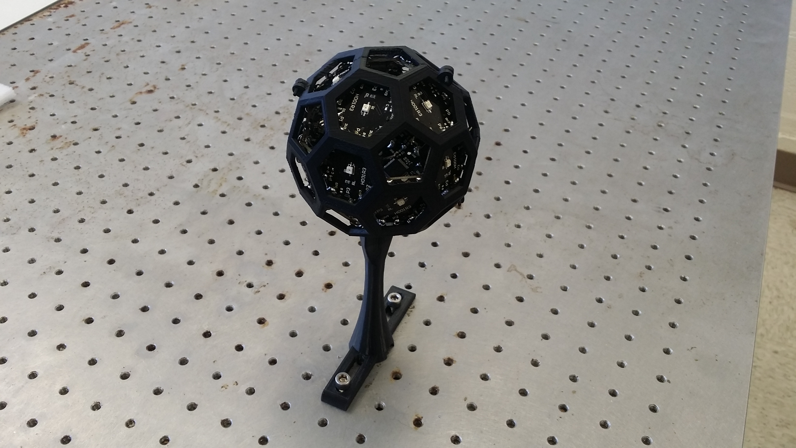
Projects/20 Spherical Detector Array/Pictures/2.jpg
