Asaadkaadan/MOWE/Projects/20 Spherical Detector Array/Pictures/3.jpg

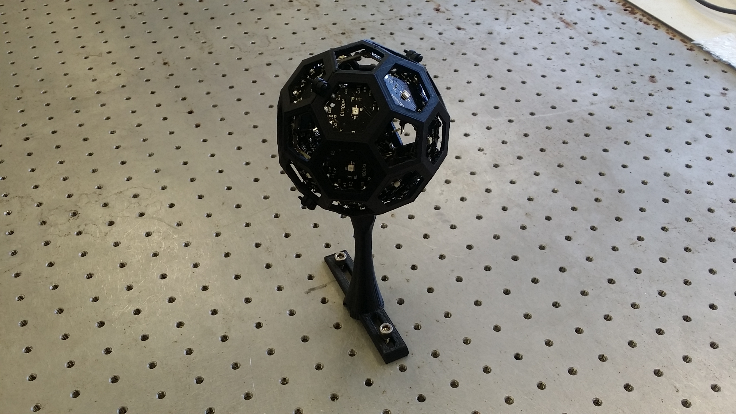
Projects/20 Spherical Detector Array/Pictures/3.jpg
