Asaadkaadan/MOWE/Projects/20 Spherical Detector Array/Pictures/4.jpg

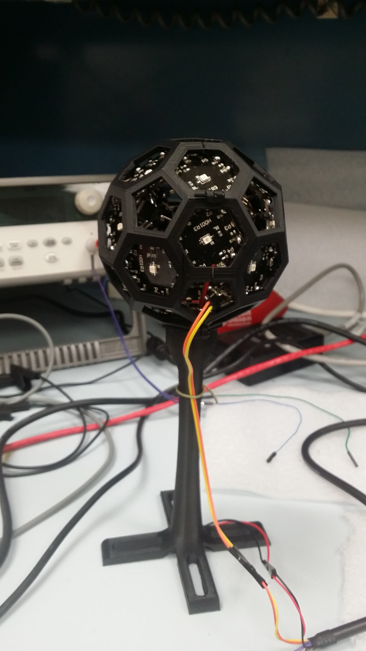
Projects/20 Spherical Detector Array/Pictures/4.jpg
