Asaadkaadan/MOWE/Projects/20 Spherical Detector Array/Pictures/5.jpg

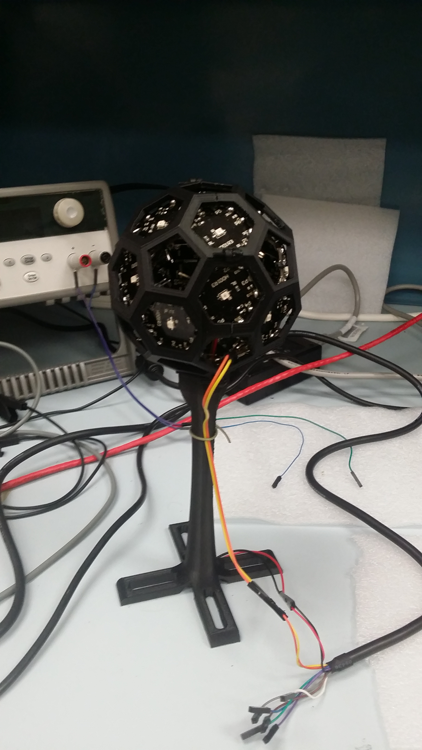
Projects/20 Spherical Detector Array/Pictures/5.jpg
