Asaadkaadan/MOWE/Projects/20 Spherical Detector Array/Pictures/6.jpg

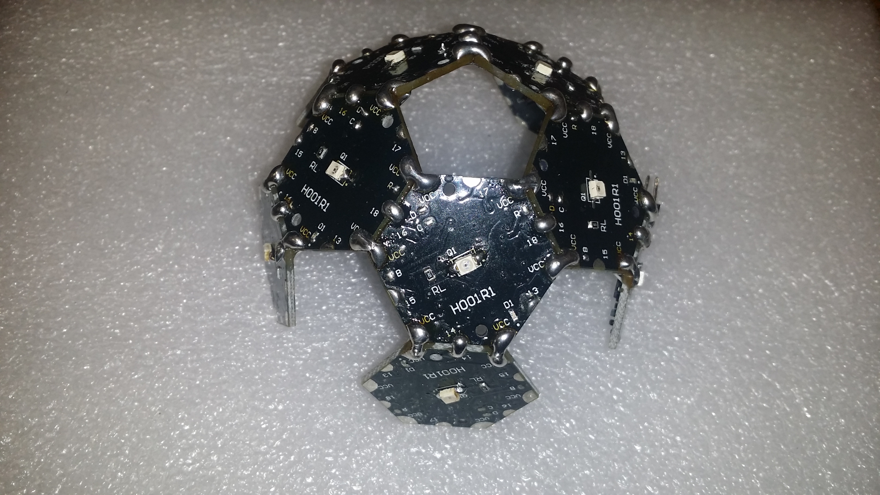
Projects/20 Spherical Detector Array/Pictures/6.jpg
