Asaadkaadan/MOWE/Projects/20 Spherical Detector Array/Pictures/7.jpg

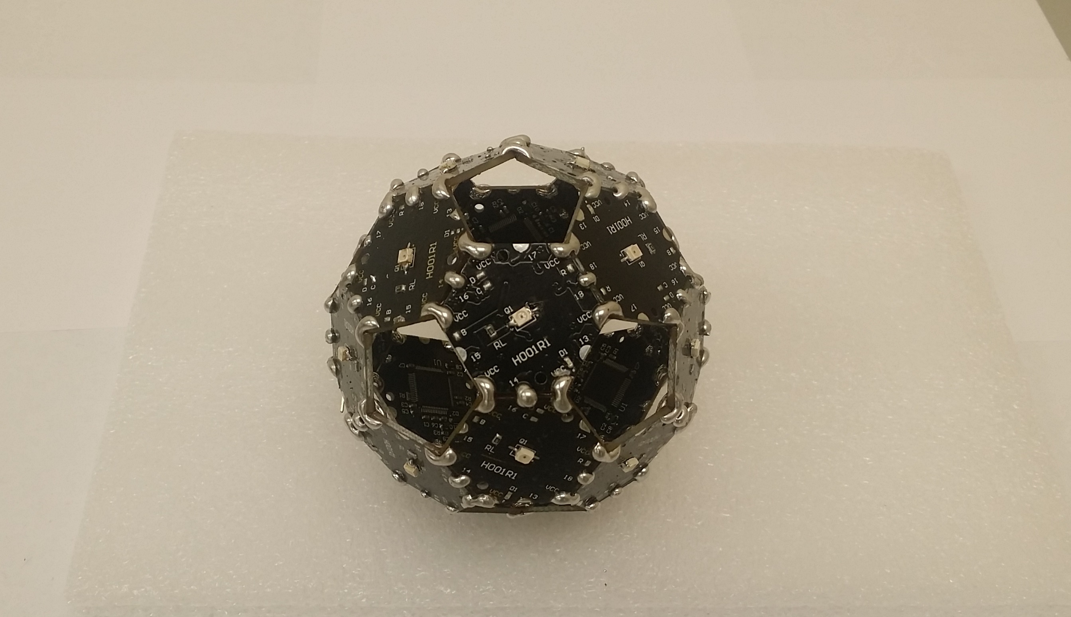
Projects/20 Spherical Detector Array/Pictures/7.jpg
