Asaadkaadan/MOWE/Projects/37 Flat Detector Array/Pictures/1.jpg

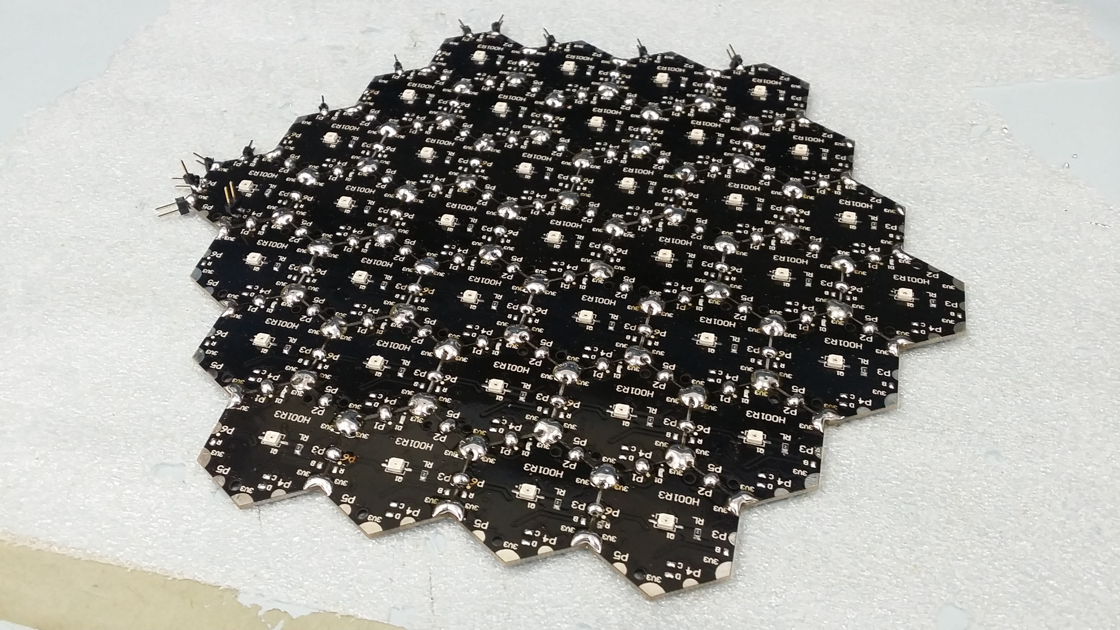
Projects/37 Flat Detector Array/Pictures/1.jpg
