Asaadkaadan/MOWE/Projects/37 Flat Detector Array/Pictures/2.jpg

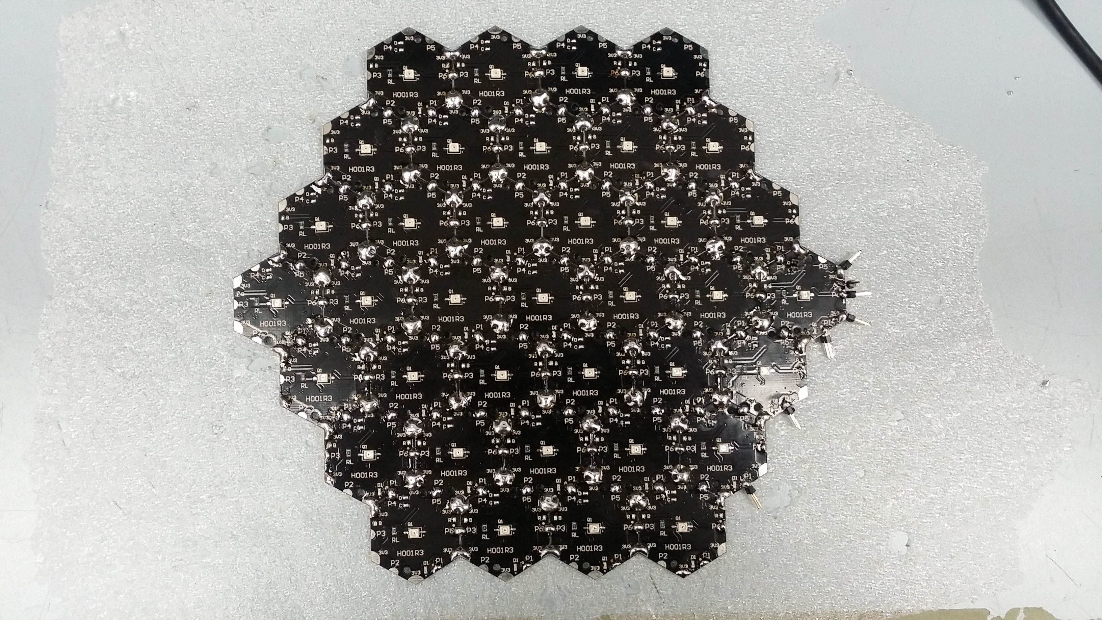
Projects/37 Flat Detector Array/Pictures/2.jpg
