Asaadkaadan/MOWE/Projects/37 Flat Detector Array/Pictures/3.jpg

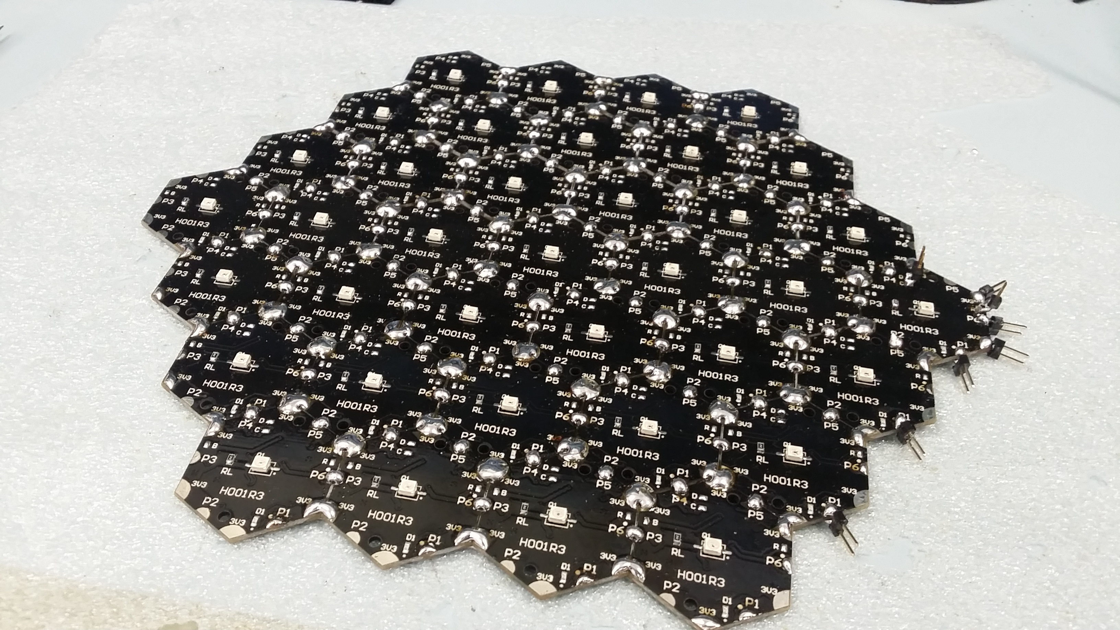
Projects/37 Flat Detector Array/Pictures/3.jpg
