Asaadkaadan/MOWE/Projects/37 Flat Detector Array/Pictures/4.jpg

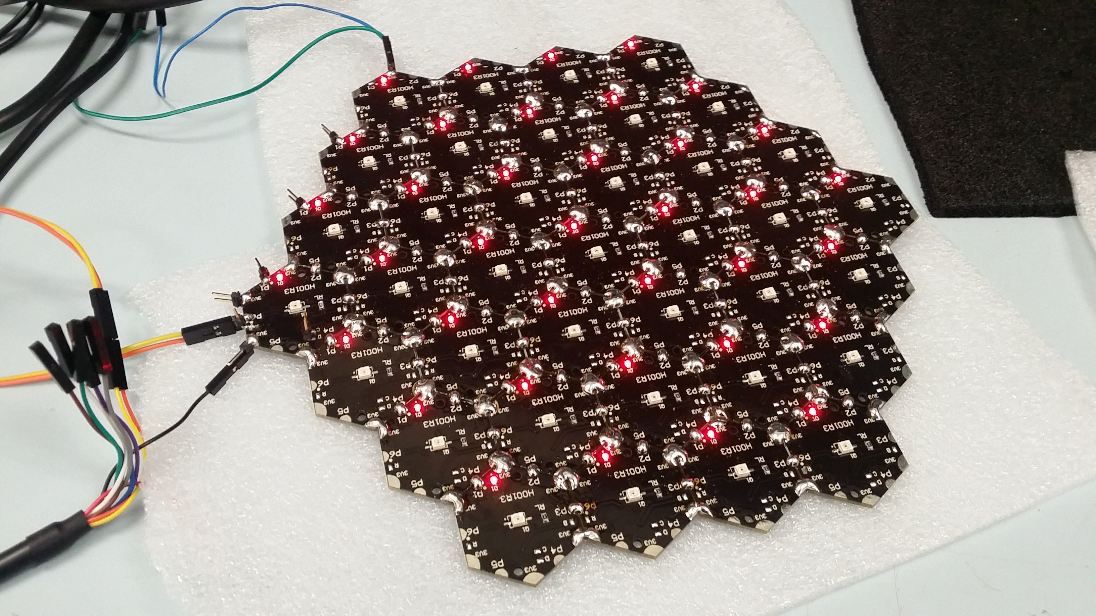
Projects/37 Flat Detector Array/Pictures/4.jpg
