Asaadkaadan/MOWE/Projects/37 Flat Detector Array/Pictures/5.jpg

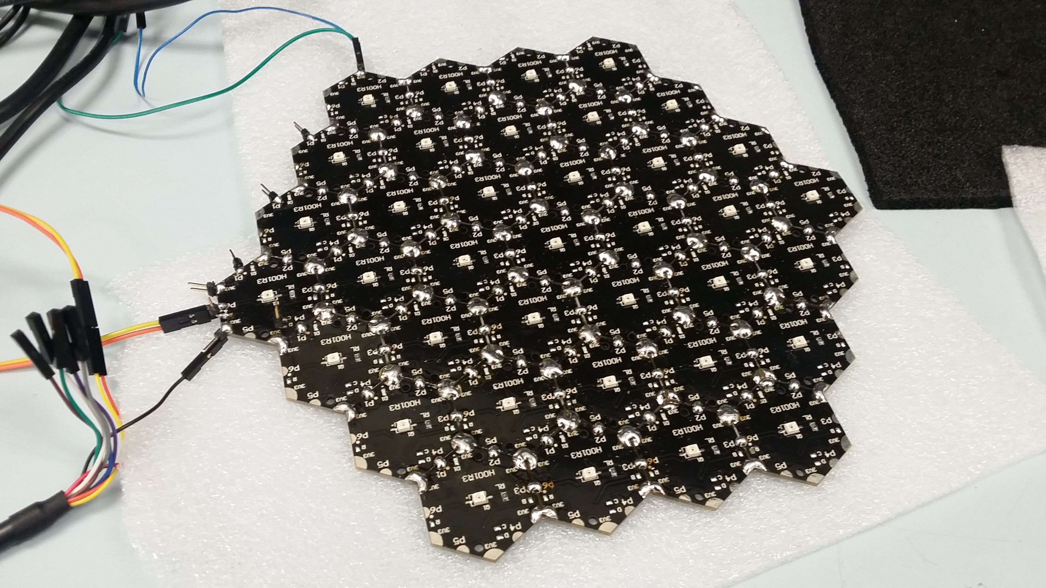
Projects/37 Flat Detector Array/Pictures/5.jpg
