Asaadkaadan/MOWE/Projects/37 Flat Detector Array/Pictures/routes_37_flat.PNG

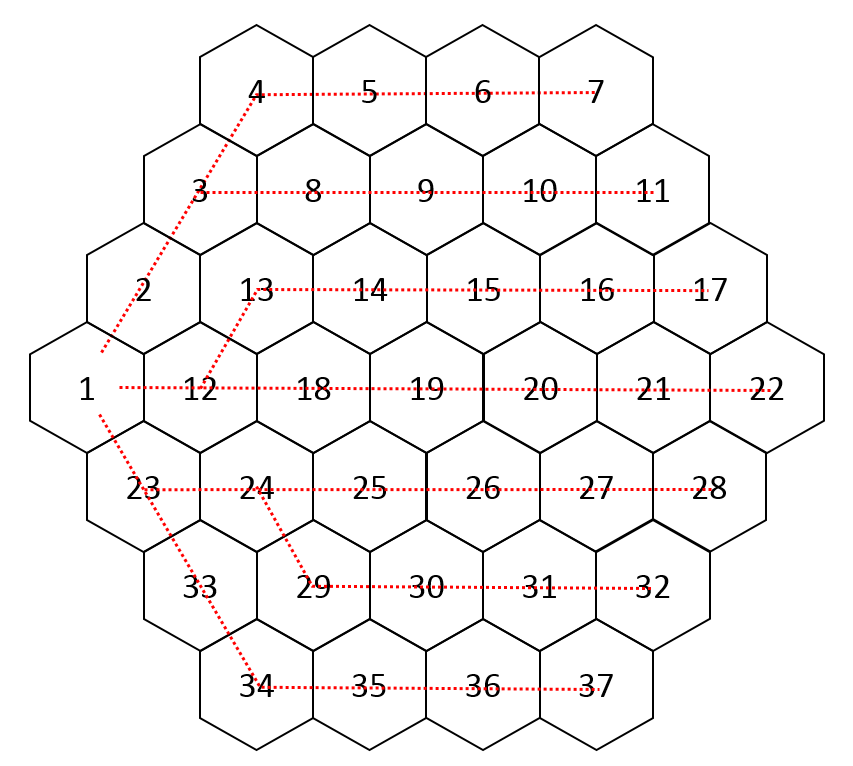
Projects/37 Flat Detector Array/Pictures/routes_37_flat.PNG
