Asaadkaadan/MOWE/Projects/All RX Terminal+Gimbal/Mechanical/optical_table_holder_100m_quad.JPG

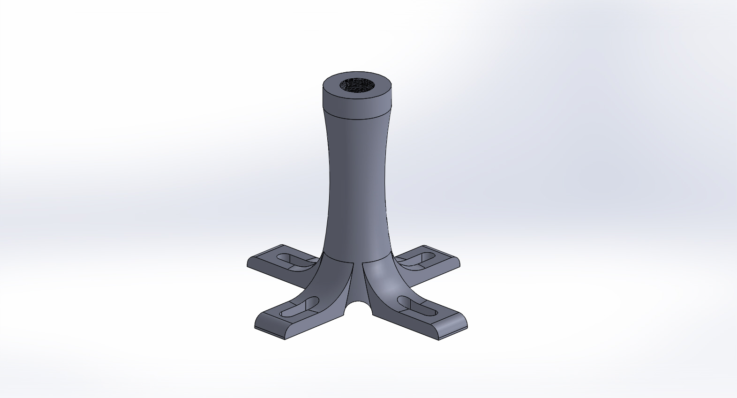
Projects/All RX Terminal+Gimbal/Mechanical/optical_table_holder_100m_quad.JPG
