Asaadkaadan/MOWE/Projects/All RX Terminal+Gimbal/Mechanical/Support Frame 2.JPG

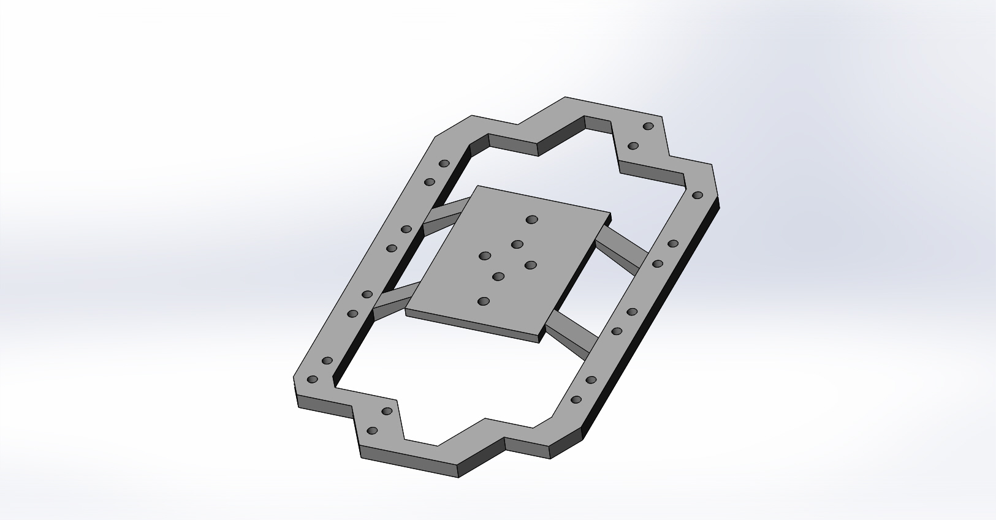
Projects/All RX Terminal+Gimbal/Mechanical/Support Frame 2.JPG
