Asaadkaadan/MOWE/Projects/All RX Terminal+Gimbal/Pictures/1.jpg

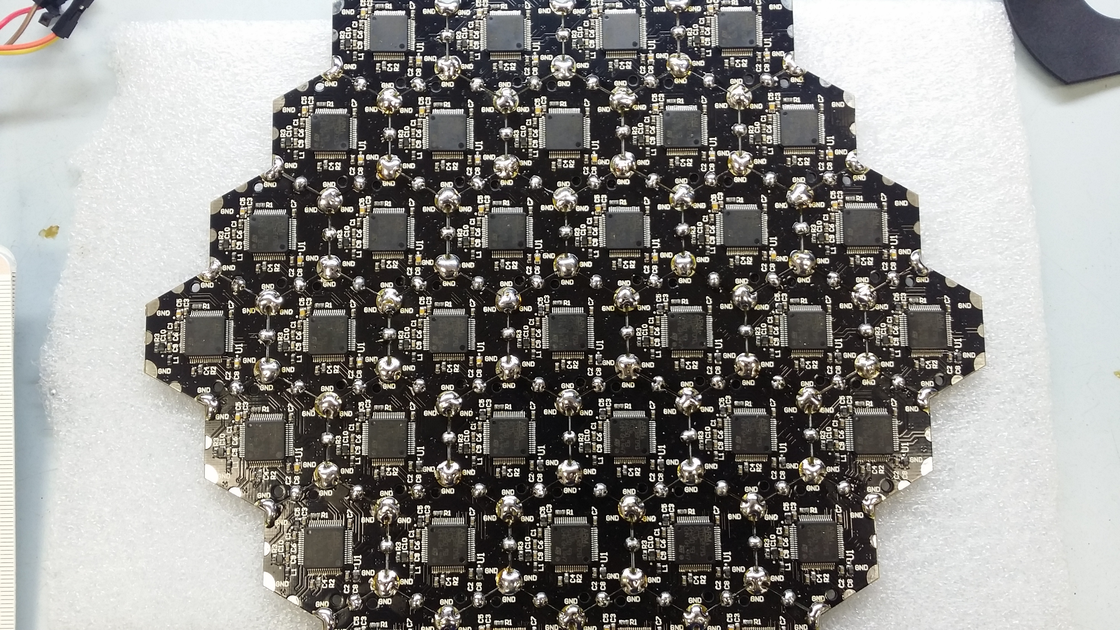
Projects/All RX Terminal+Gimbal/Pictures/1.jpg
