Asaadkaadan/MOWE/Projects/All RX Terminal+Gimbal/Pictures/2.jpg

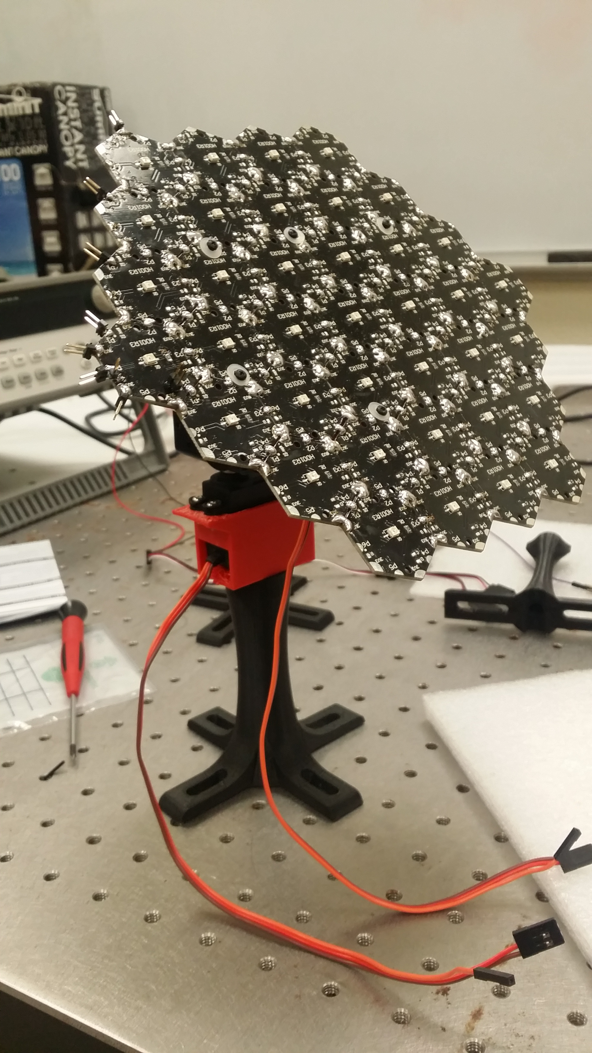
Projects/All RX Terminal+Gimbal/Pictures/2.jpg
