Asaadkaadan/MOWE/Projects/All RX Terminal+Gimbal/Pictures/3.jpg

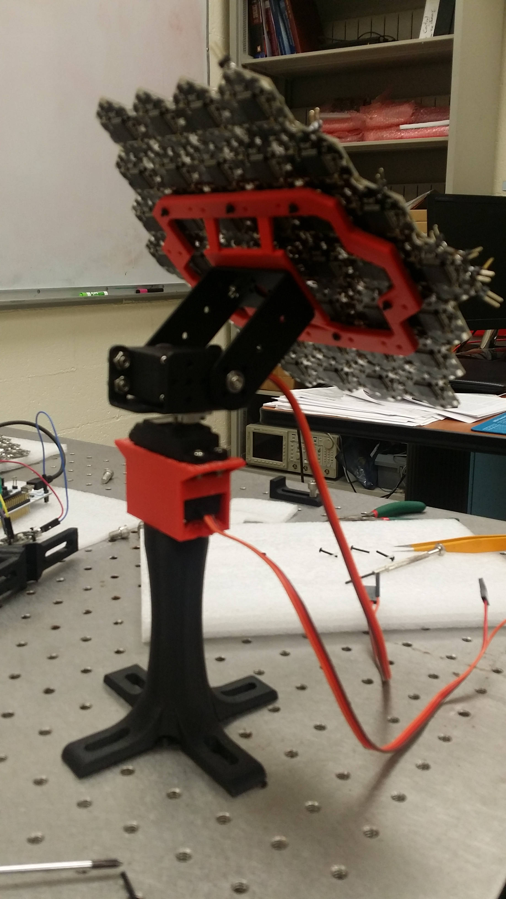
Projects/All RX Terminal+Gimbal/Pictures/3.jpg
