Asaadkaadan/MOWE/Projects/TR Terminal+Gimbal+IMU/Pictures/1.jpg

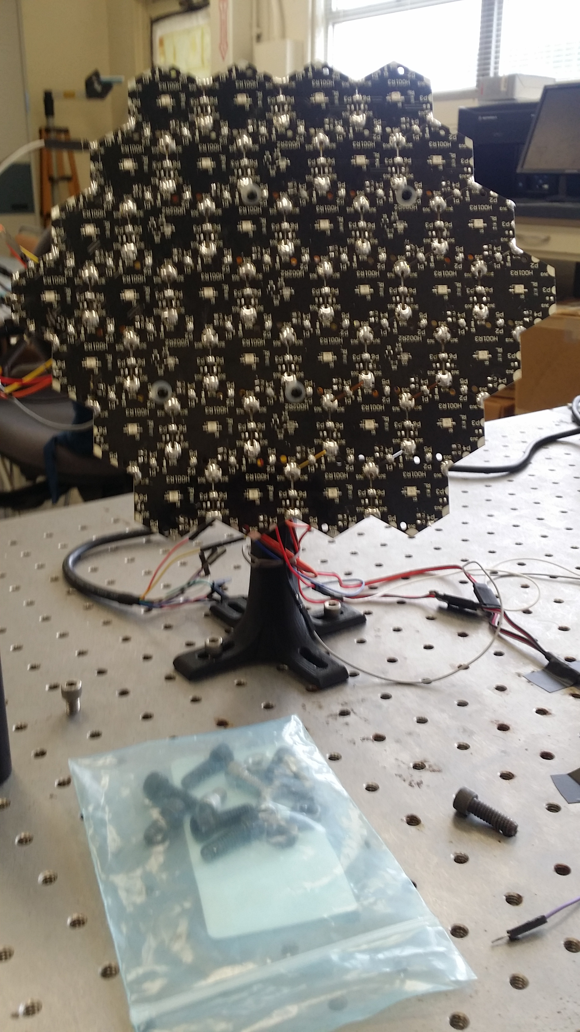
Projects/TR Terminal+Gimbal+IMU/Pictures/1.jpg
