Asaadkaadan/MOWE/Projects/TR Terminal+Gimbal+IMU/Pictures/2.jpg

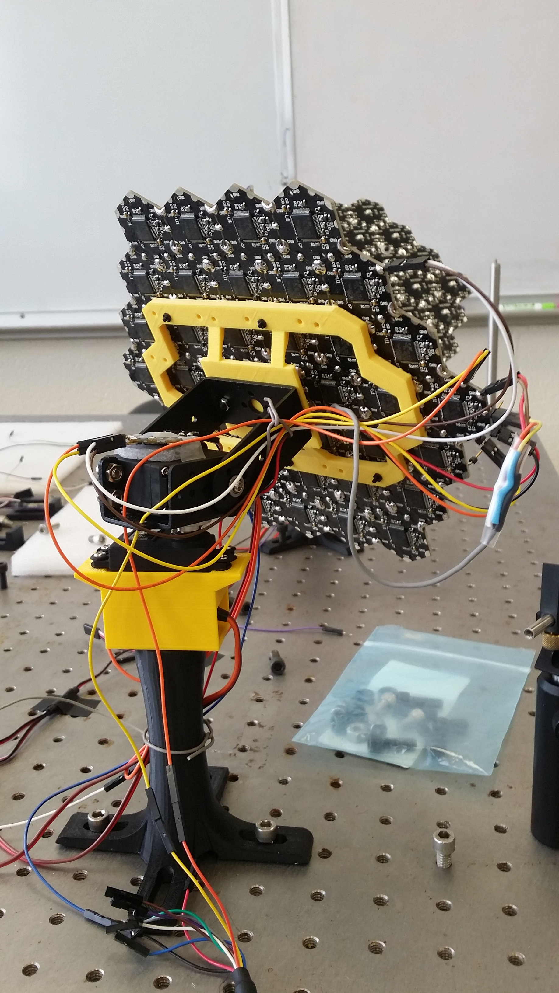
Projects/TR Terminal+Gimbal+IMU/Pictures/2.jpg
