Asaadkaadan/MOWE/Projects/TR Terminal+Gimbal+IMU/Pictures/3.jpg

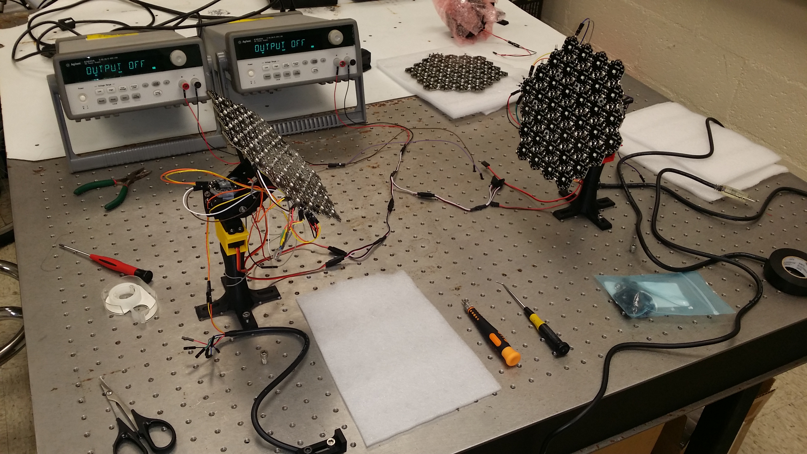
Projects/TR Terminal+Gimbal+IMU/Pictures/3.jpg
