Asaadkaadan/MOWE/Projects/TR Terminal+Gimbal+IMU/Pictures/4.jpg

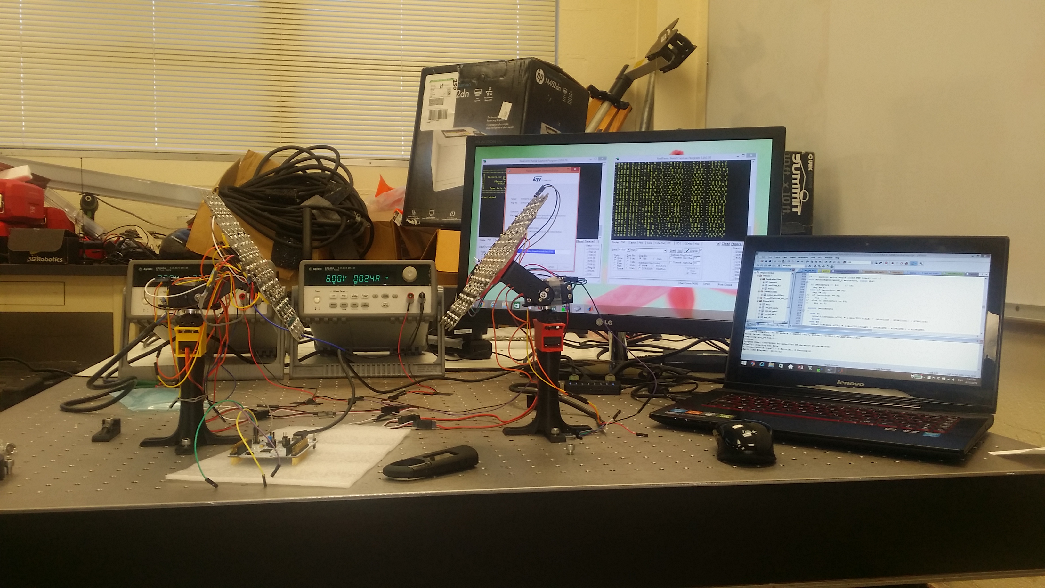
Projects/TR Terminal+Gimbal+IMU/Pictures/4.jpg
