Asaadkaadan/MOWE/Projects/TU Relay Spring 2016/Pictures/topology.png

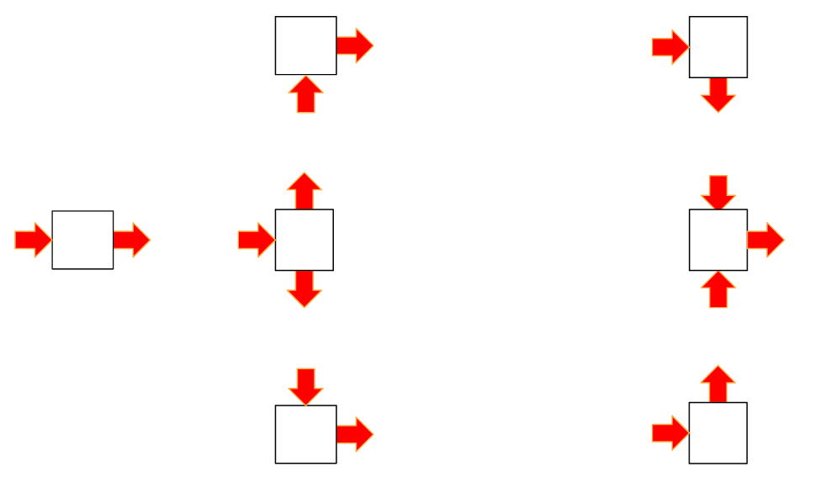
Projects/TU Relay Spring 2016/Pictures/topology.png
