Asaadkaadan/MOWE/Projects/Tube Detector Array-3 rings/Pictures/1.jpg

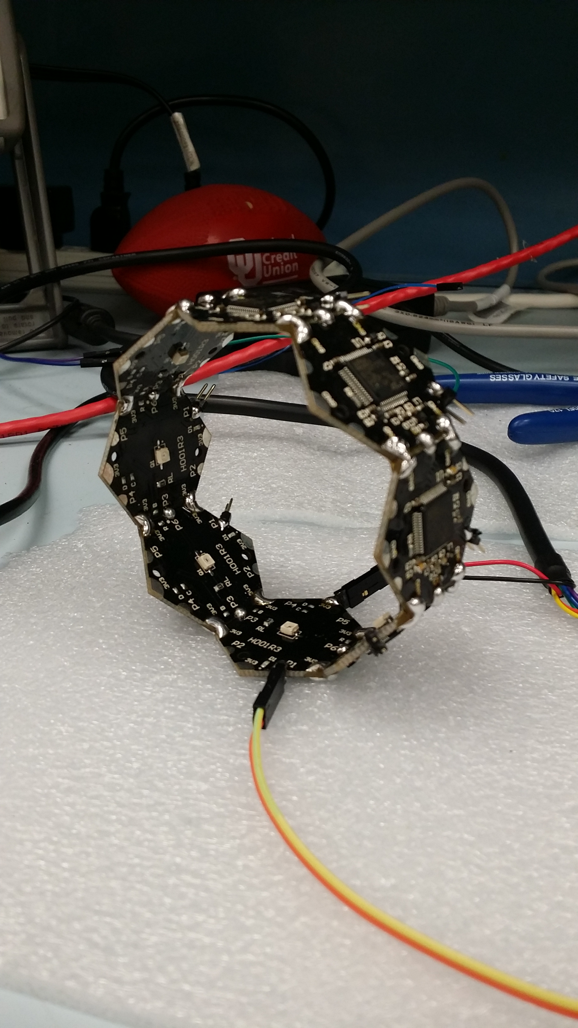
Projects/Tube Detector Array-3 rings/Pictures/1.jpg
