Asaadkaadan/MOWE/Projects/Tube Detector Array-3 rings/Pictures/2.jpg

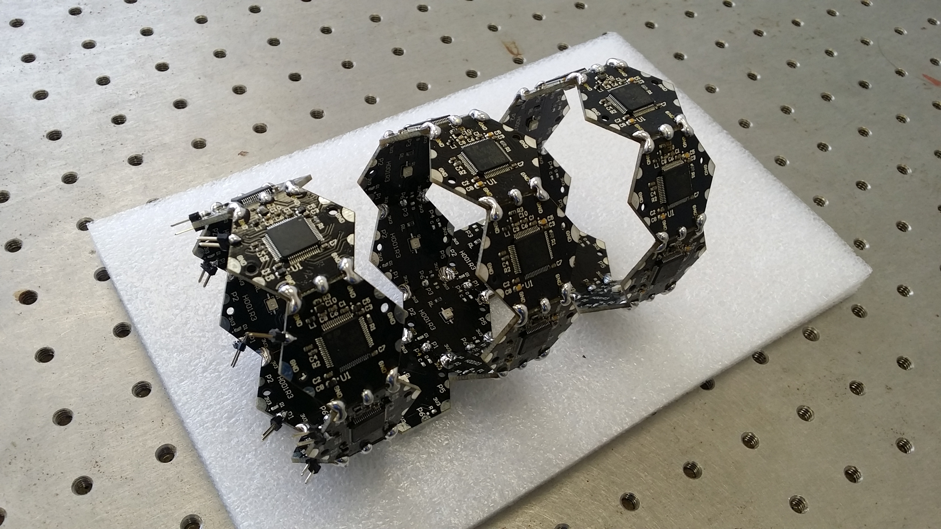
Projects/Tube Detector Array-3 rings/Pictures/2.jpg
