Asaadkaadan/MOWE/Projects/Tube Detector Array-3 rings/Pictures/3.jpg

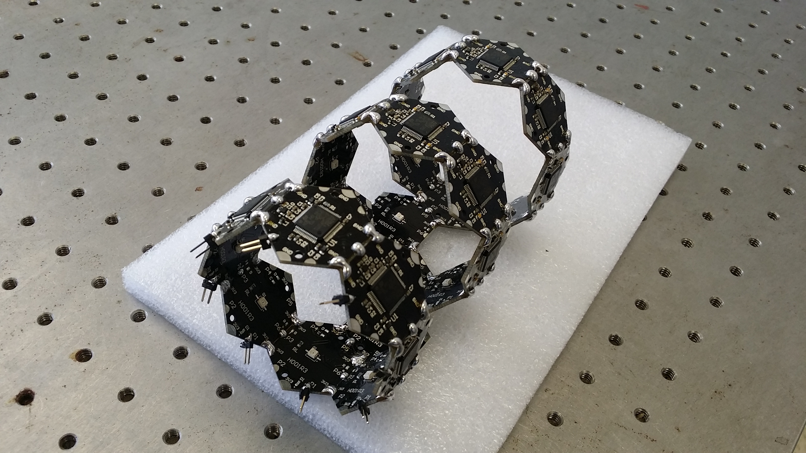
Projects/Tube Detector Array-3 rings/Pictures/3.jpg
