Asaadkaadan/MOWE/Projects/Tube Detector Array-3 rings/Pictures/4.jpg

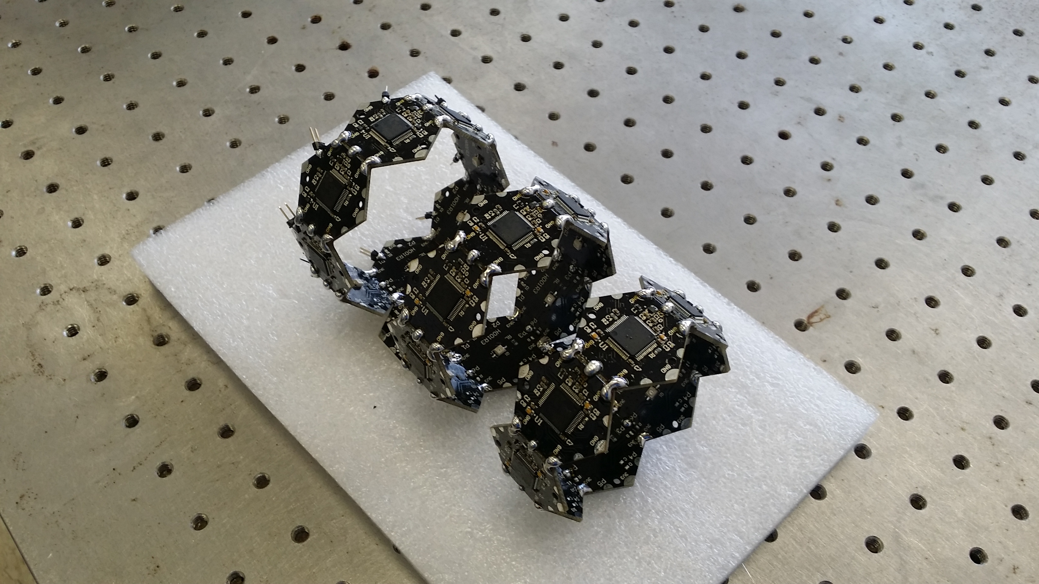
Projects/Tube Detector Array-3 rings/Pictures/4.jpg
