Asaadkaadan/MOWE/Projects/Tube Detector Array-3 rings/Pictures/5.jpg

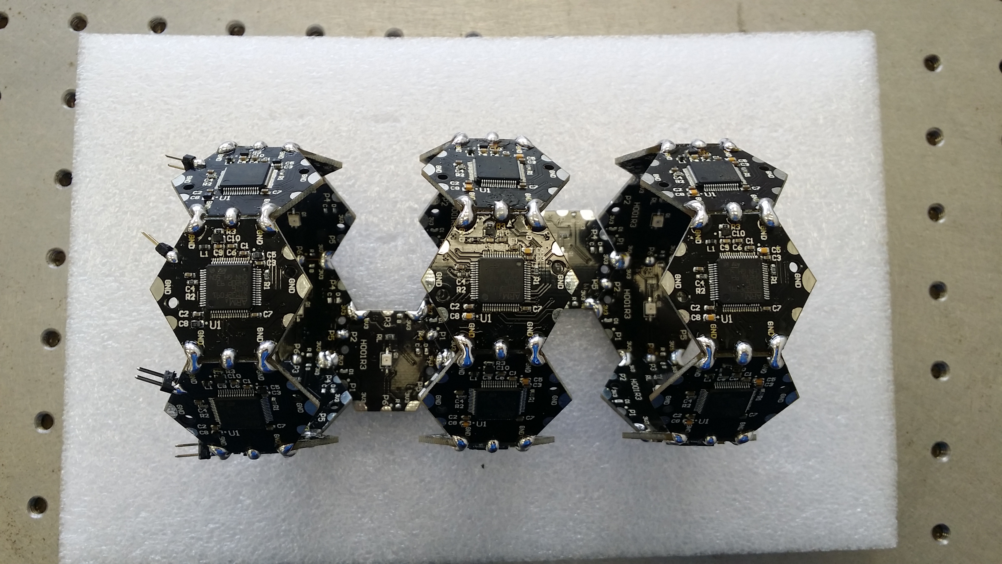
Projects/Tube Detector Array-3 rings/Pictures/5.jpg
