Asaadkaadan/MOWE/Projects/Tube Detector Array-3 rings/Pictures/6.jpg

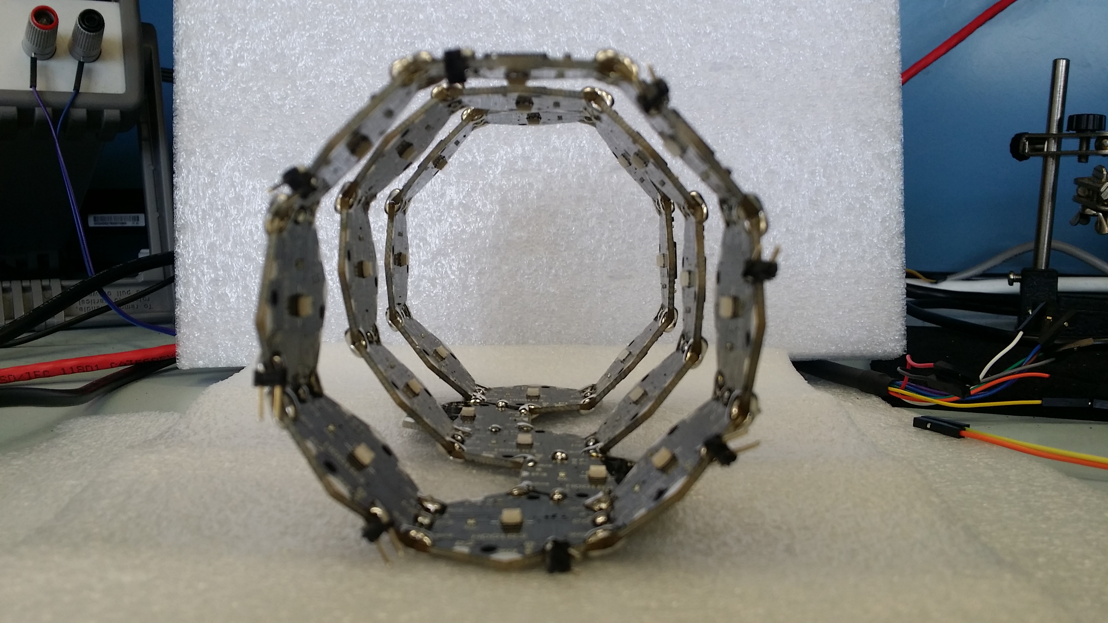
Projects/Tube Detector Array-3 rings/Pictures/6.jpg
