Asaadkaadan/MOWE/Tools/MOWE ATG/Output.png

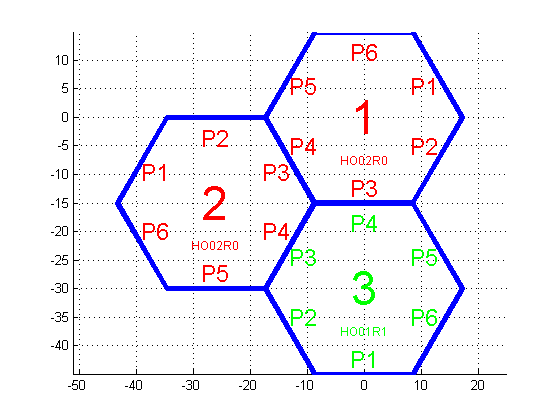
Tools/MOWE ATG/Output.png
