Asaadkaadan/MOWE/Tools/Sample Networks/Fully Connected/MOWE Firmware Topology/Large(127 nodes)/Large.jpg

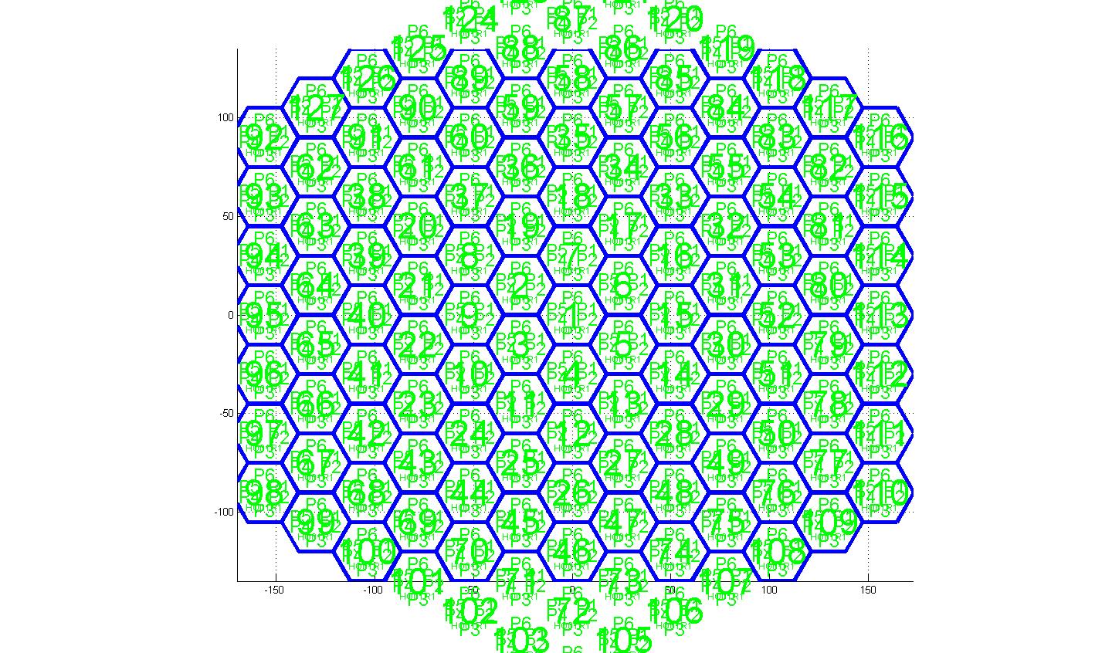
Tools/Sample Networks/Fully Connected/MOWE Firmware Topology/Large(127 nodes)/Large.jpg
