Asaadkaadan/MOWE/Tools/Sample Networks/Fully Connected/MOWE Firmware Topology/Medium(37 nodes)/Medium.jpg

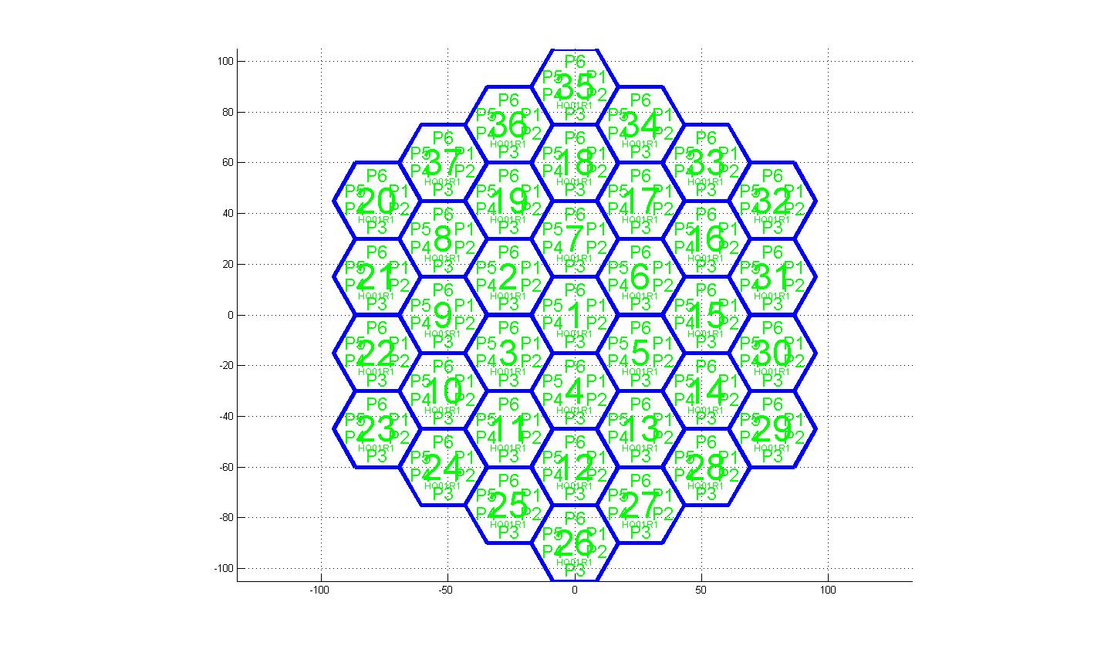
Tools/Sample Networks/Fully Connected/MOWE Firmware Topology/Medium(37 nodes)/Medium.jpg
