Asaadkaadan/MOWE/Tools/Sample Networks/Fully Connected/MOWE Firmware Topology/Small(19 nodes)/small.jpg

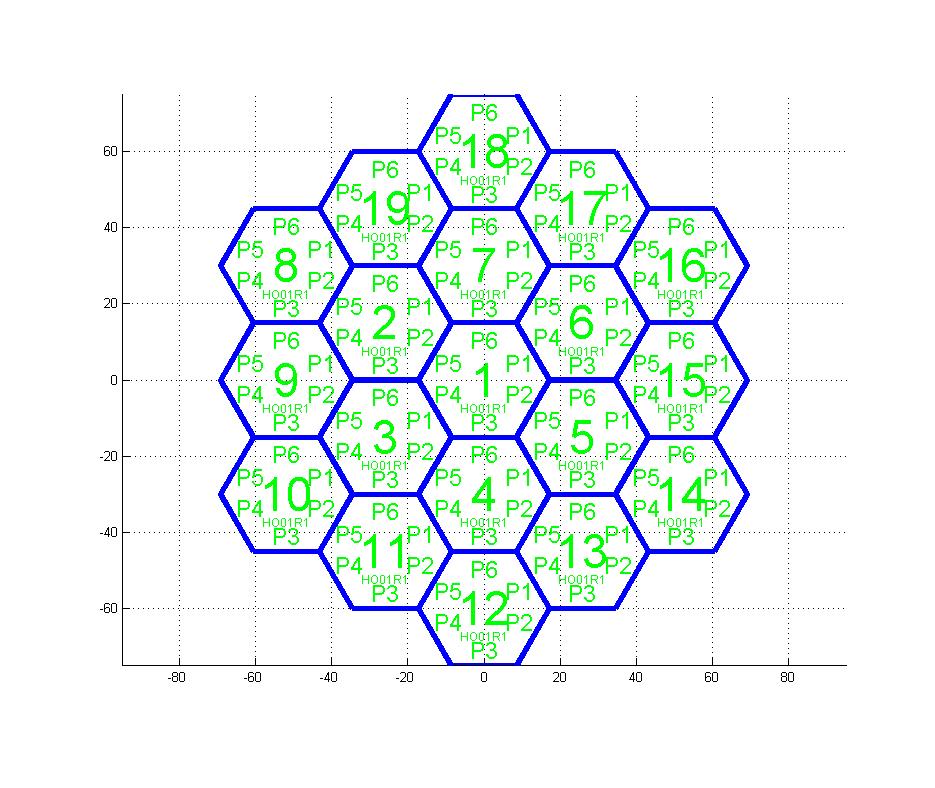
Tools/Sample Networks/Fully Connected/MOWE Firmware Topology/Small(19 nodes)/small.jpg
