Asaadkaadan/MOWE/Tools/Sample Networks/Fully Connected/MOWE Firmware Topology/Tiny(7 nodes)/tiny.jpg

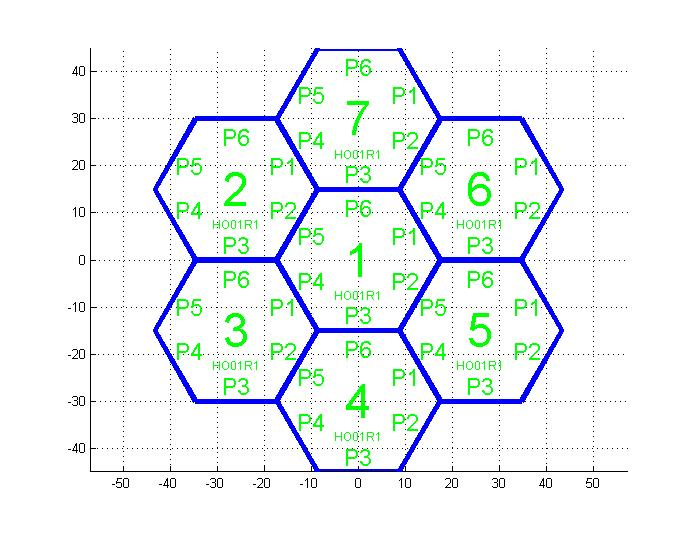
Tools/Sample Networks/Fully Connected/MOWE Firmware Topology/Tiny(7 nodes)/tiny.jpg
