Asaadkaadan/MOWE/Tools/Sample Networks/Fully Connected/MOWE Firmware Topology/Tiny(7 nodes)/tiny.tif

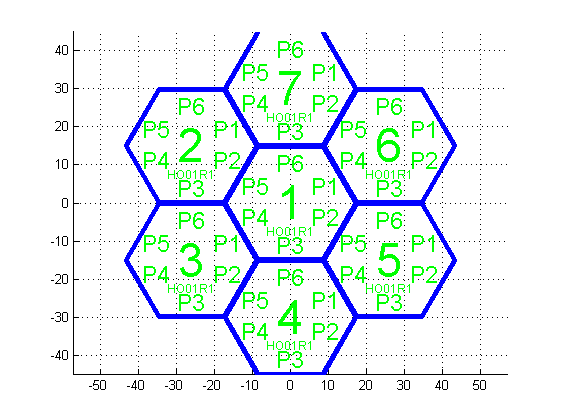
Tools/Sample Networks/Fully Connected/MOWE Firmware Topology/Tiny(7 nodes)/tiny.tif
