Asaadkaadan/MOWE/Projects/20 Spherical Detector Array/Mechanical/sphere_30mm.SLDASM

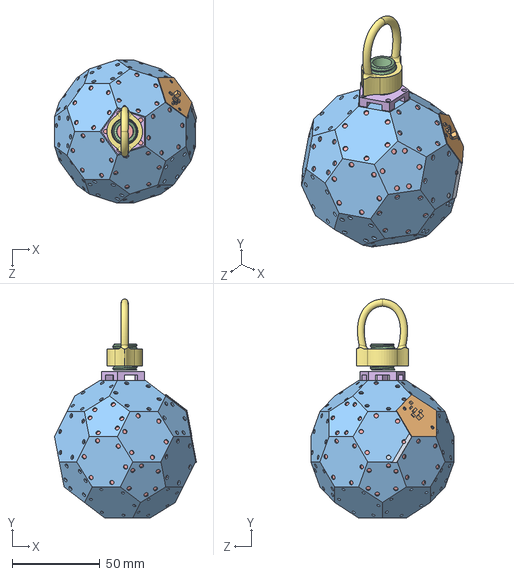
[picture p133: CAD file, 2016-04-27]
Projects/20 Spherical Detector Array/Mechanical/sphere_30mm.SLDASM
80.8 x 124.5 x 81.6 mm
