Asaadkaadan/MOWE/Projects/20 Spherical Detector Array/Mechanical/Sphere Frame.SLDASM

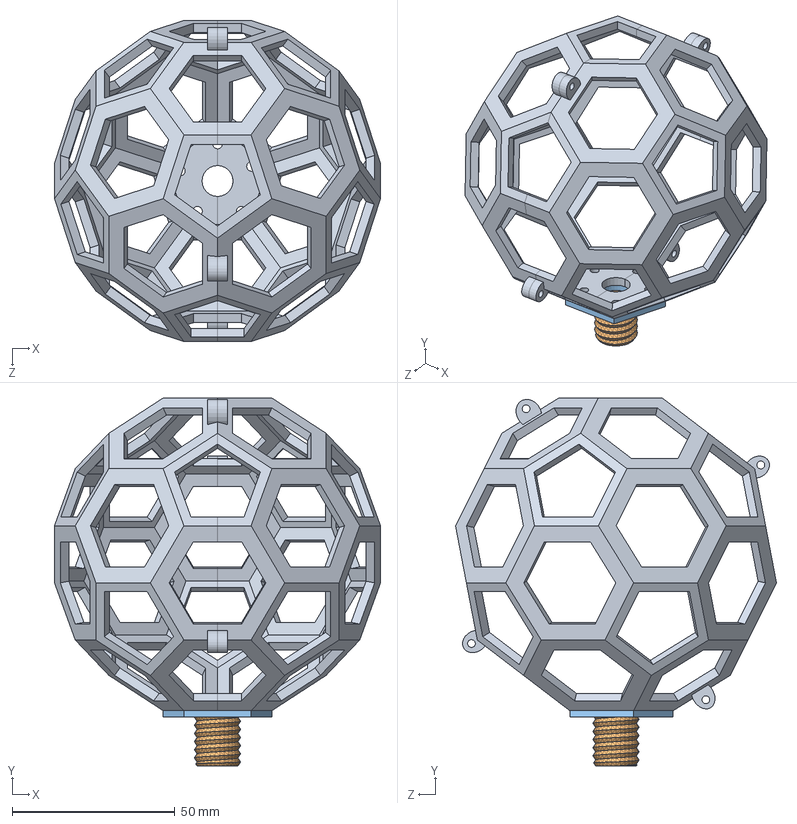
[picture p134: CAD file, 2016-04-27]
Projects/20 Spherical Detector Array/Mechanical/Sphere Frame.SLDASM
100.2 x 113.1 x 98.6 mm
Truncated icosahedron shell
Makerbolt_mod
Bolt_Base^Sphere Frame
