Asaadkaadan/MOWE/Projects/All RX Terminal+Gimbal/Mechanical/optical_table_holder_100m_quad.SLDPRT

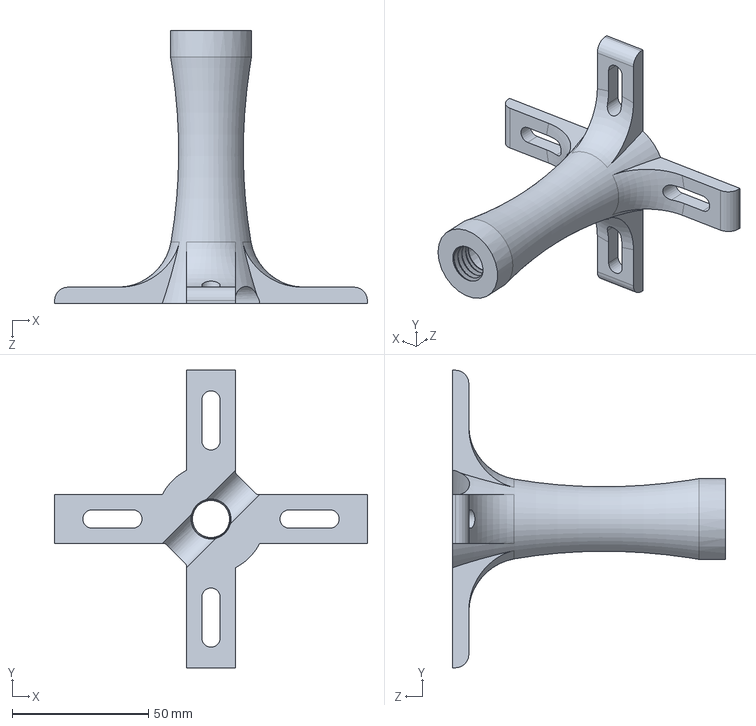
[picture p135: CAD file, 2016-05-19]
Projects/All RX Terminal+Gimbal/Mechanical/optical_table_holder_100m_quad.SLDPRT
114.7 x 109.1 x 100.0 mm
