Asaadkaadan/MOWE/Projects/20 Spherical Detector Array/Mechanical/Truncated icosahedron shell.SLDPRT

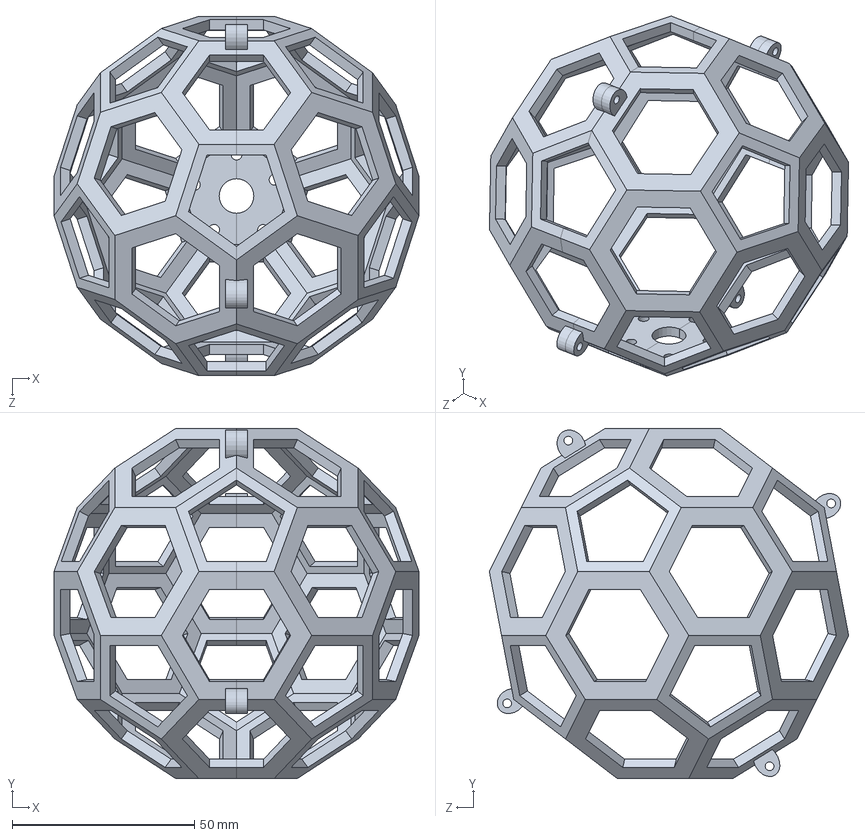
[picture p136: CAD file, 2016-04-27]
Projects/20 Spherical Detector Array/Mechanical/Truncated icosahedron shell.SLDPRT
100.2 x 96.1 x 98.6 mm
