Asaadkaadan/MOWE/Projects/20 Spherical Detector Array/Mechanical/HO01R1.SLDPRT

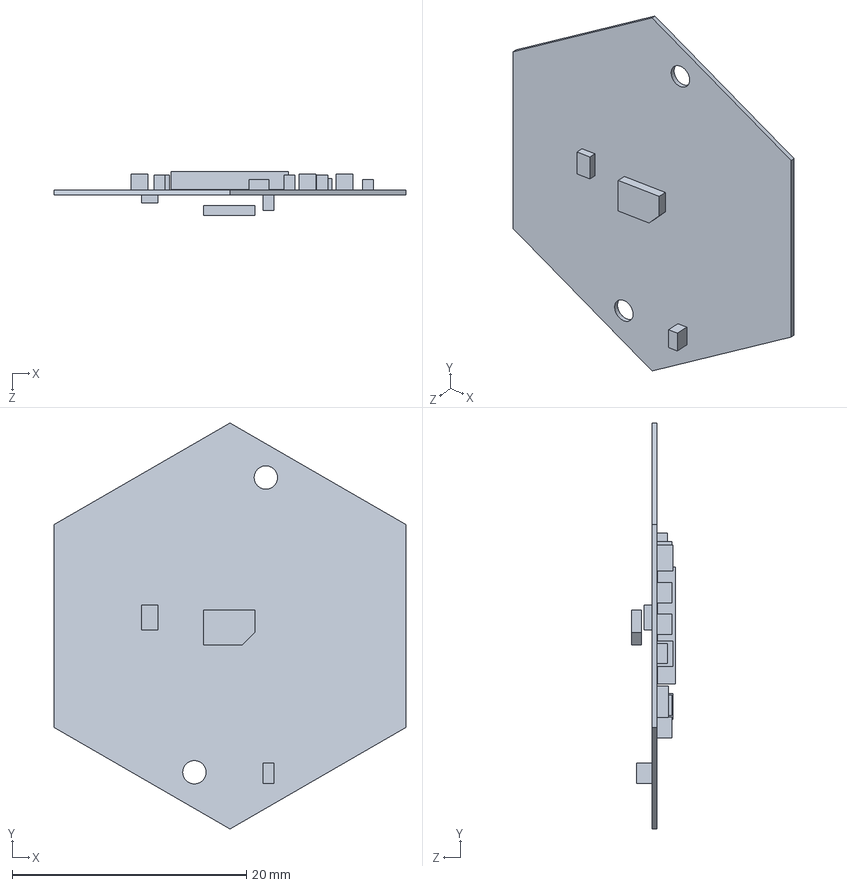
[picture p137: CAD file, 2016-04-27]
Projects/20 Spherical Detector Array/Mechanical/HO01R1.SLDPRT
30.0 x 34.6 x 3.76 mm
