Asaadkaadan/MOWE/Projects/20 Spherical Detector Array/Mechanical/Truncated icosahedron.SLDPRT

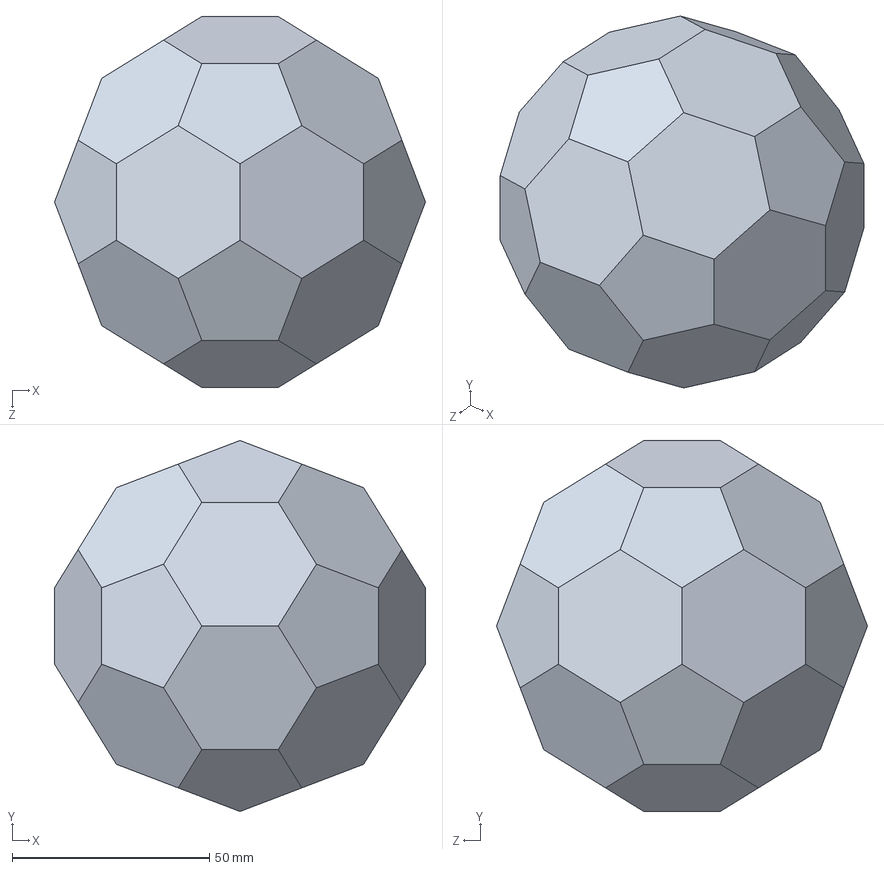
[picture p138: CAD file, 2016-04-27]
Projects/20 Spherical Detector Array/Mechanical/Truncated icosahedron.SLDPRT
94.1 x 94.1 x 94.1 mm
