Asaadkaadan/MOWE/Projects/20 Spherical Detector Array/Mechanical/PO02R0.SLDPRT

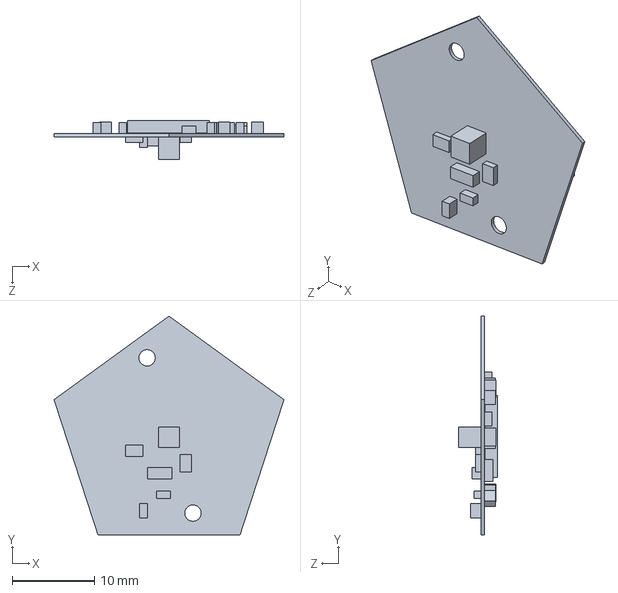
[picture p139: CAD file, 2016-04-27]
Projects/20 Spherical Detector Array/Mechanical/PO02R0.SLDPRT
28.0 x 26.7 x 4.81 mm
