Asaadkaadan/MOWE/Projects/20 Spherical Detector Array/Mechanical/Makerbolt_mod.SLDPRT

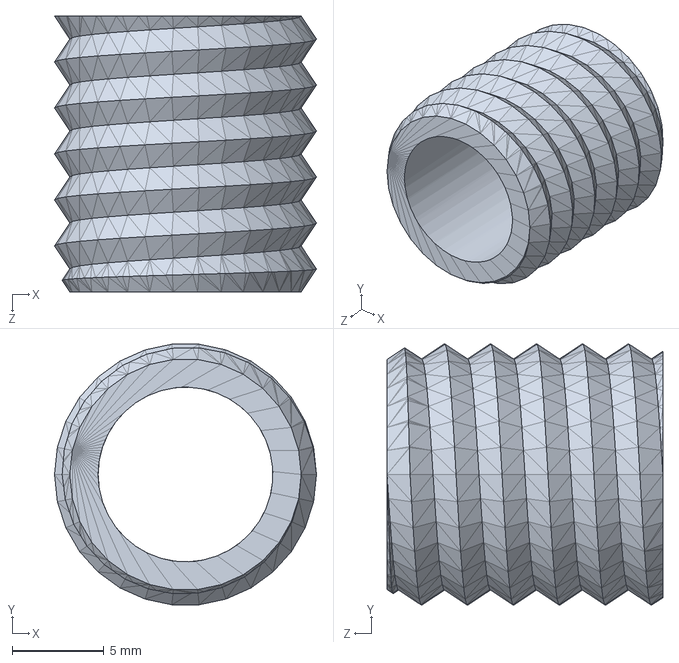
[picture p140: CAD file, 2016-04-27]
Projects/20 Spherical Detector Array/Mechanical/Makerbolt_mod.SLDPRT
14.2 x 14.2 x 15.0 mm
