Asaadkaadan/MOWE/Projects/All RX Terminal+Gimbal/Mechanical/Makerbolt_gimbal.SLDPRT

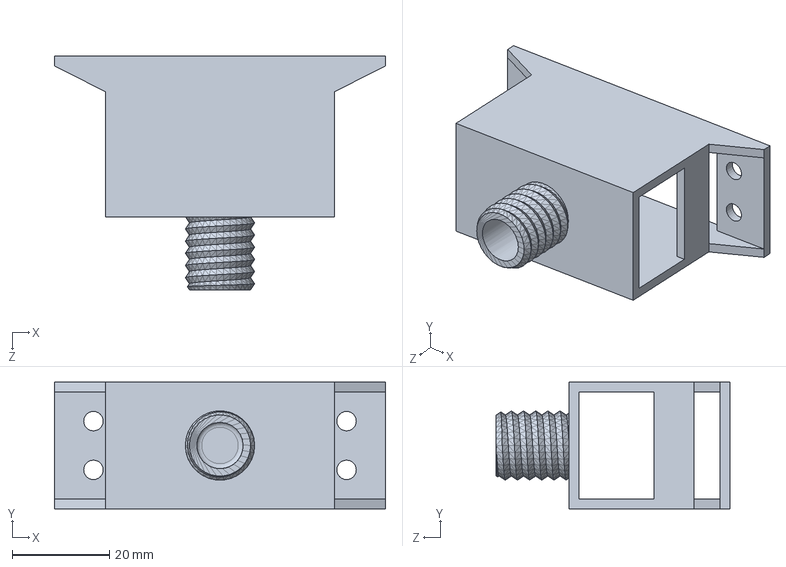
[picture p141: CAD file, 2016-05-19]
Projects/All RX Terminal+Gimbal/Mechanical/Makerbolt_gimbal.SLDPRT
68.0 x 26.0 x 48.0 mm
