Asaadkaadan/MOWE/Documentation/Images/CleanAndBuild.gif

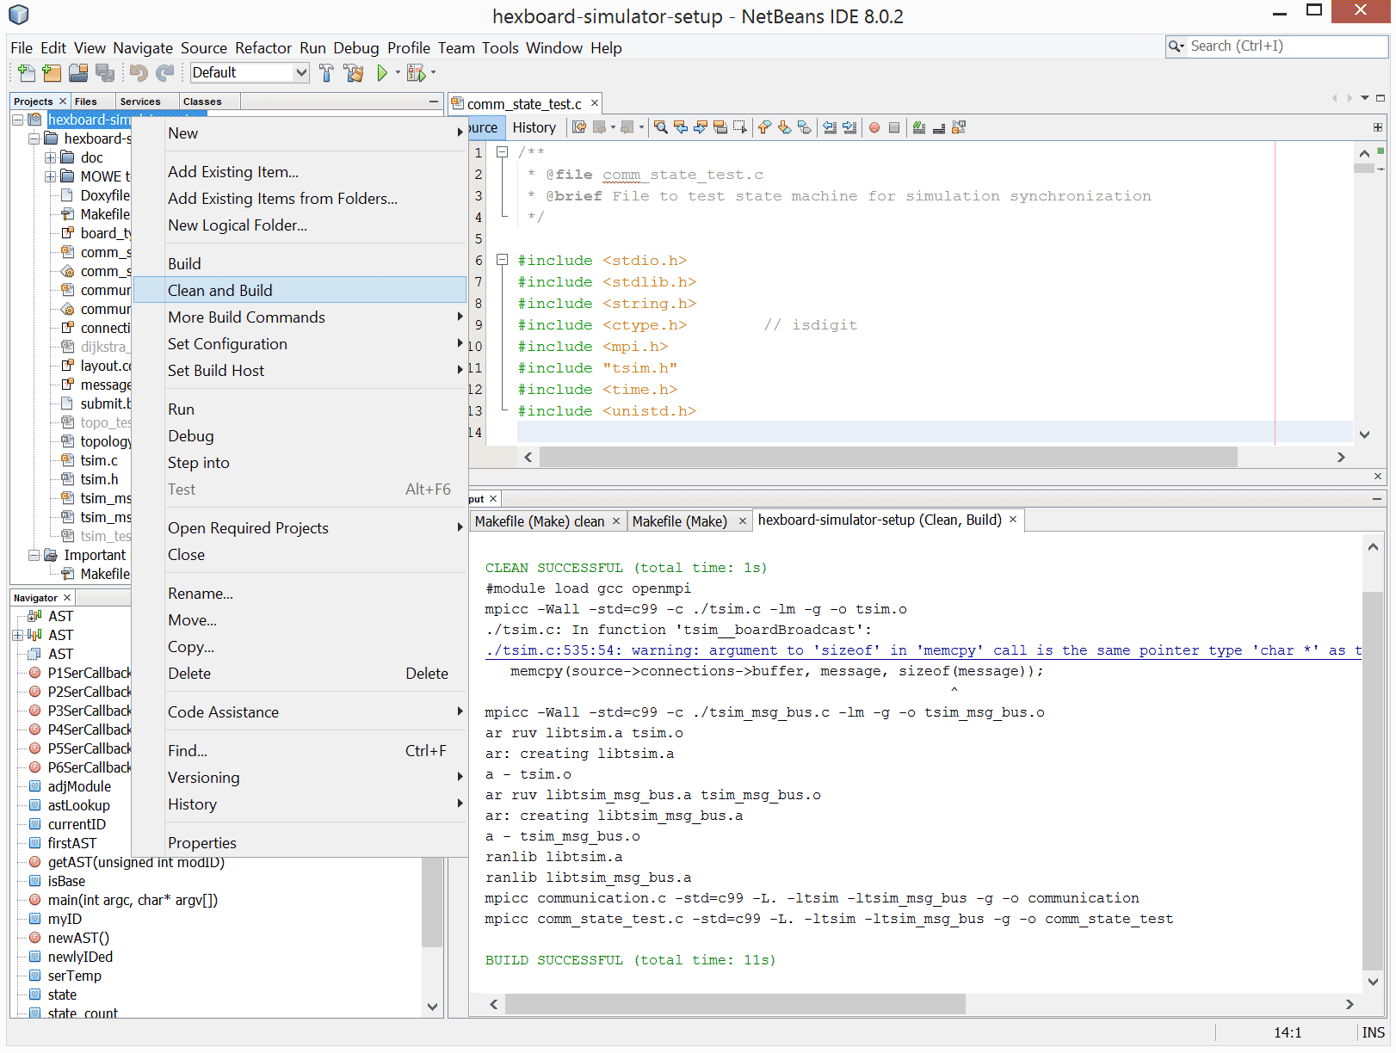
Documentation/Images/CleanAndBuild.gif
