Asaadkaadan/MOWE/Projects/20 Spherical Detector Array/Mechanical/Makerbolt_mod.JPG

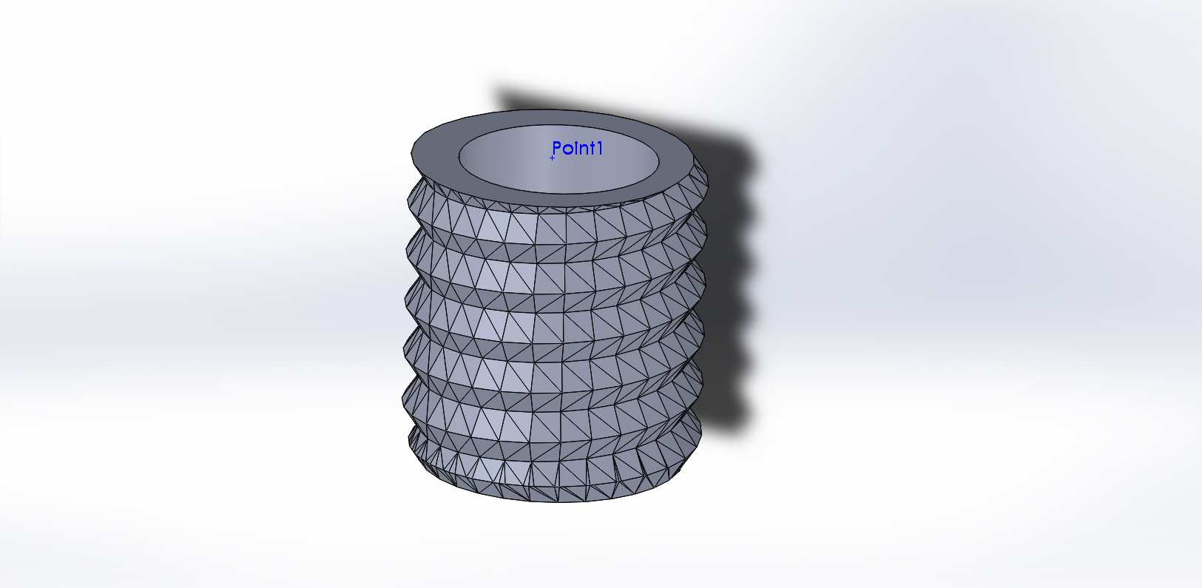
Projects/20 Spherical Detector Array/Mechanical/Makerbolt_mod.JPG
