Asaadkaadan/MOWE/Projects/All RX Terminal+Gimbal/Mechanical/Makerbolt_gimbal.JPG

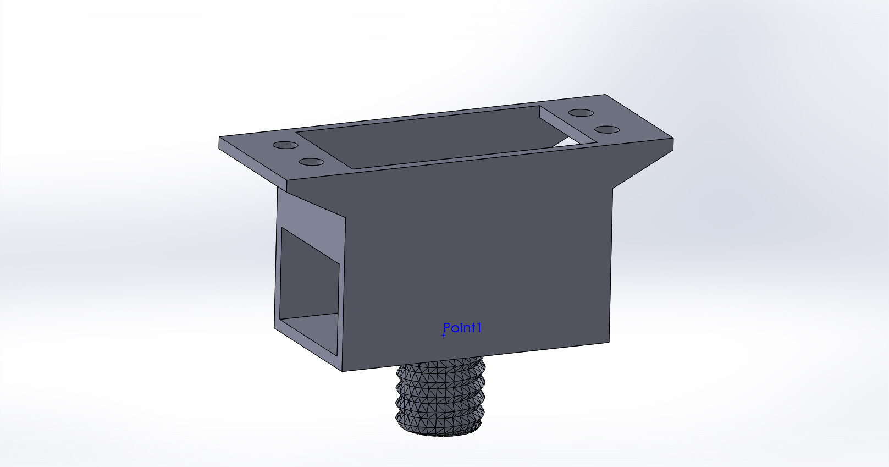
Projects/All RX Terminal+Gimbal/Mechanical/Makerbolt_gimbal.JPG
