Asaadkaadan/MOWE/Hardware/Modules/HO02R2.pdf

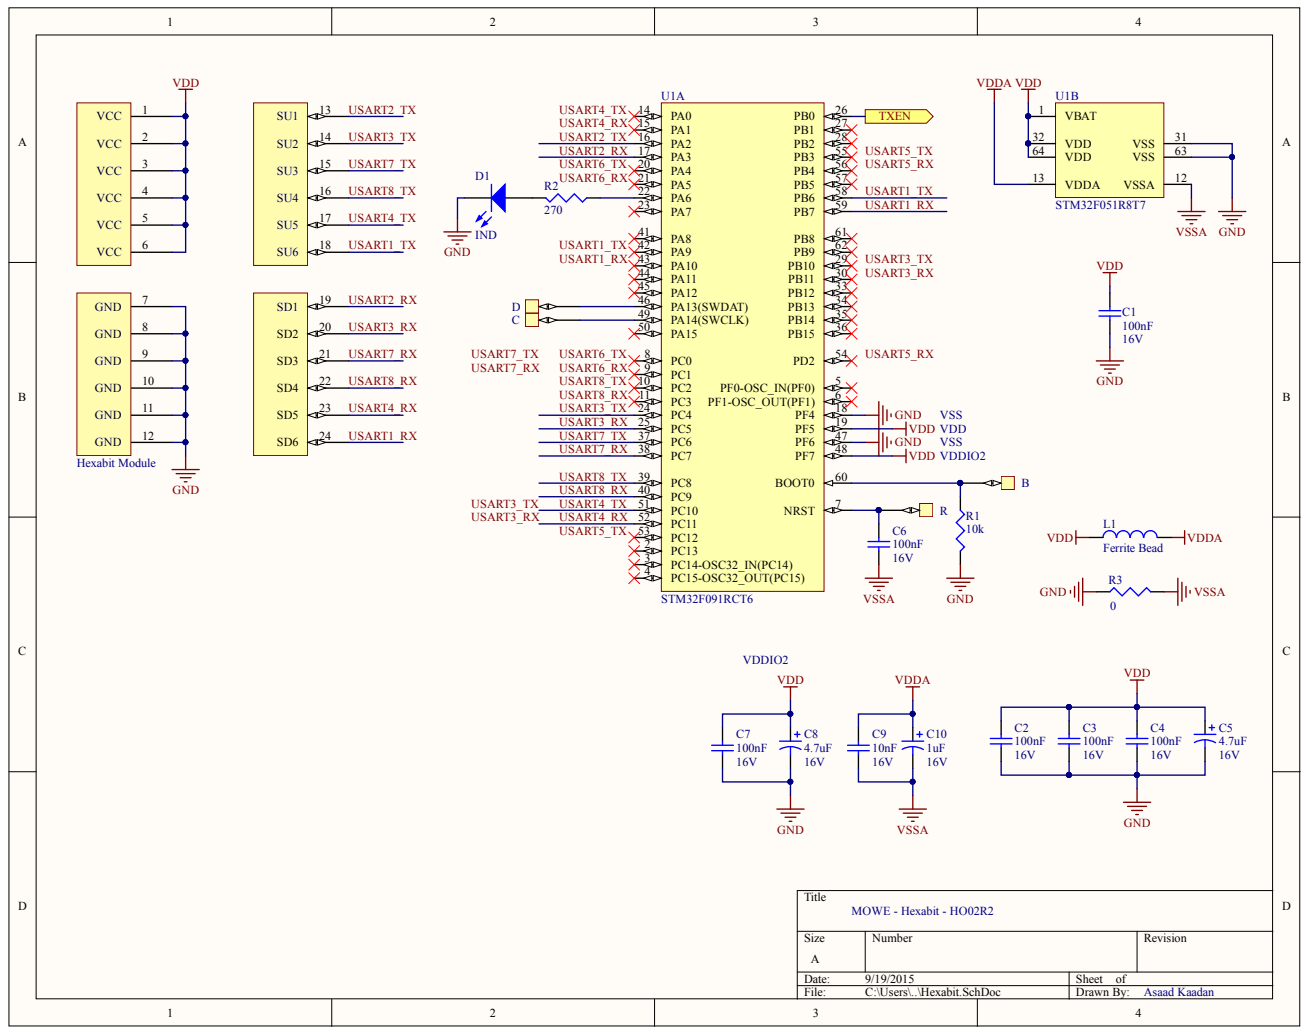
[picture p145: page 1]

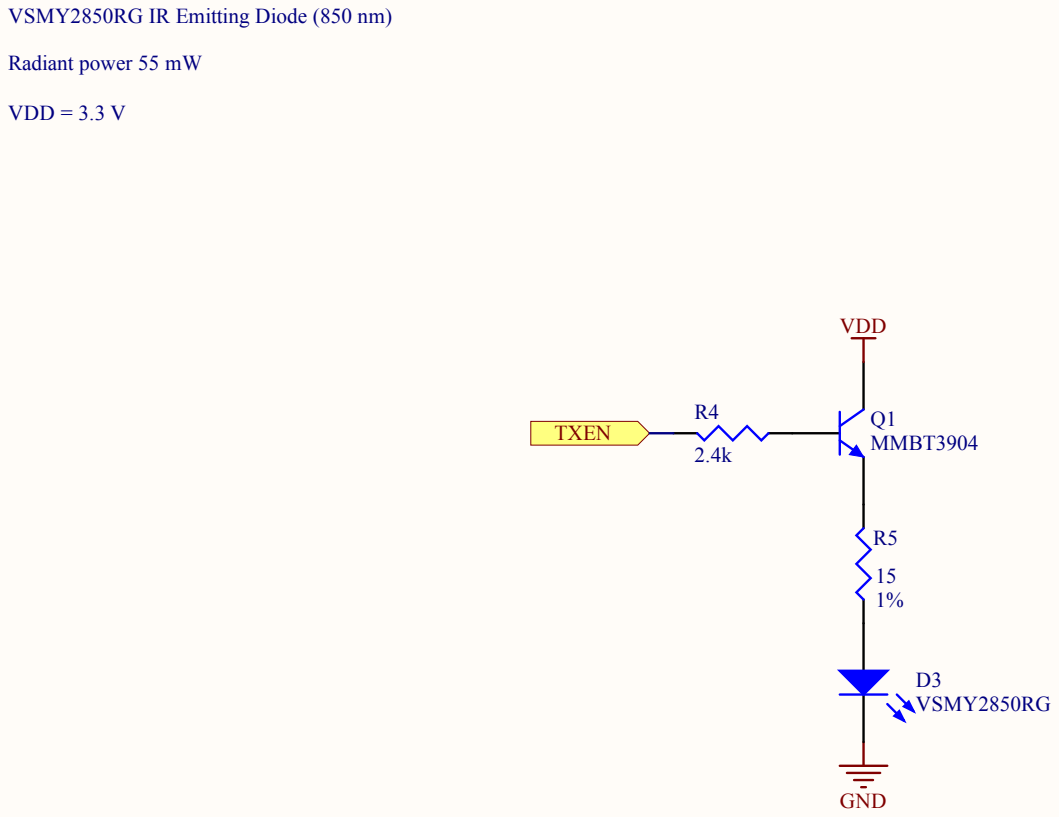
[picture p146: page 2]

VSMY2850RG IR Emitting Diode (850 nm)
