Asaadkaadan/MOWE/Hardware/Modules/HO02R0.pdf

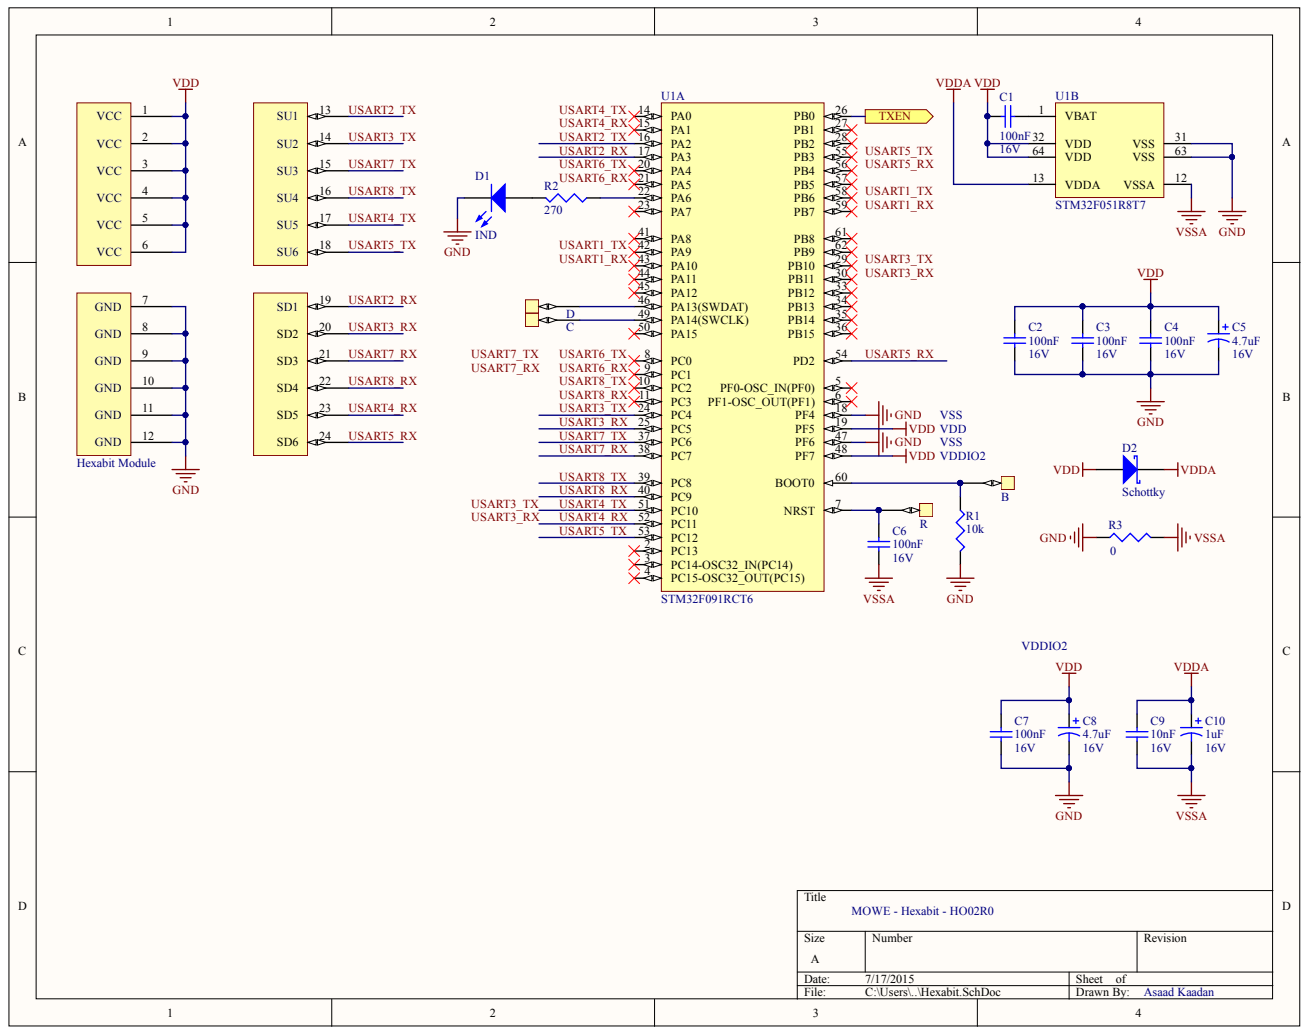
[picture p148: page 1]


VSMY2850RG IR Emitting Diode (850 nm)
