Asaadkaadan/MOWE/Hardware/Modules/HO02R1.pdf

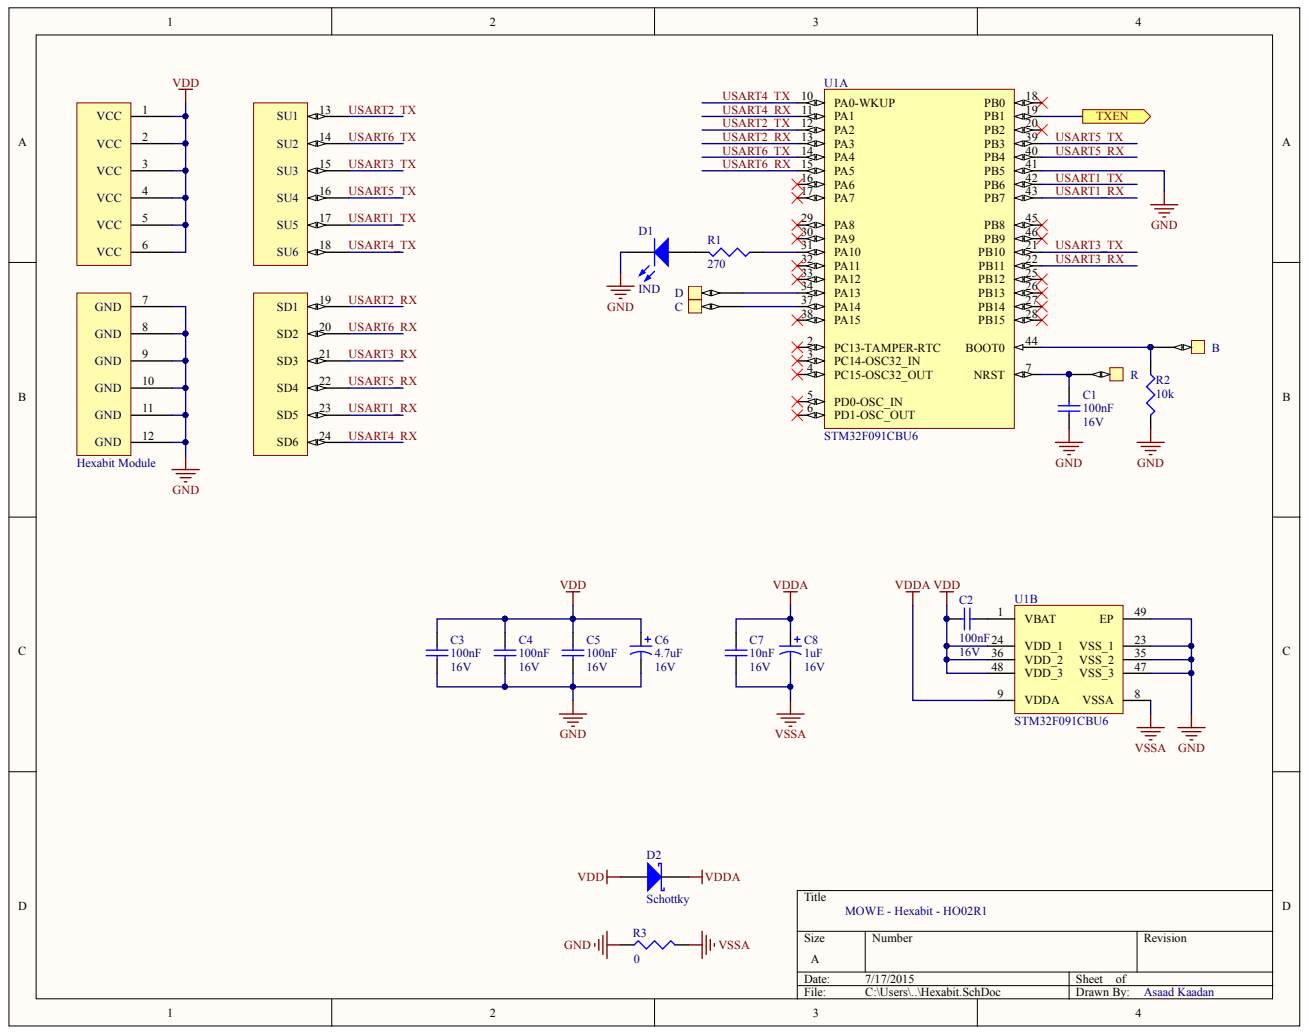
[picture p149: page 1]

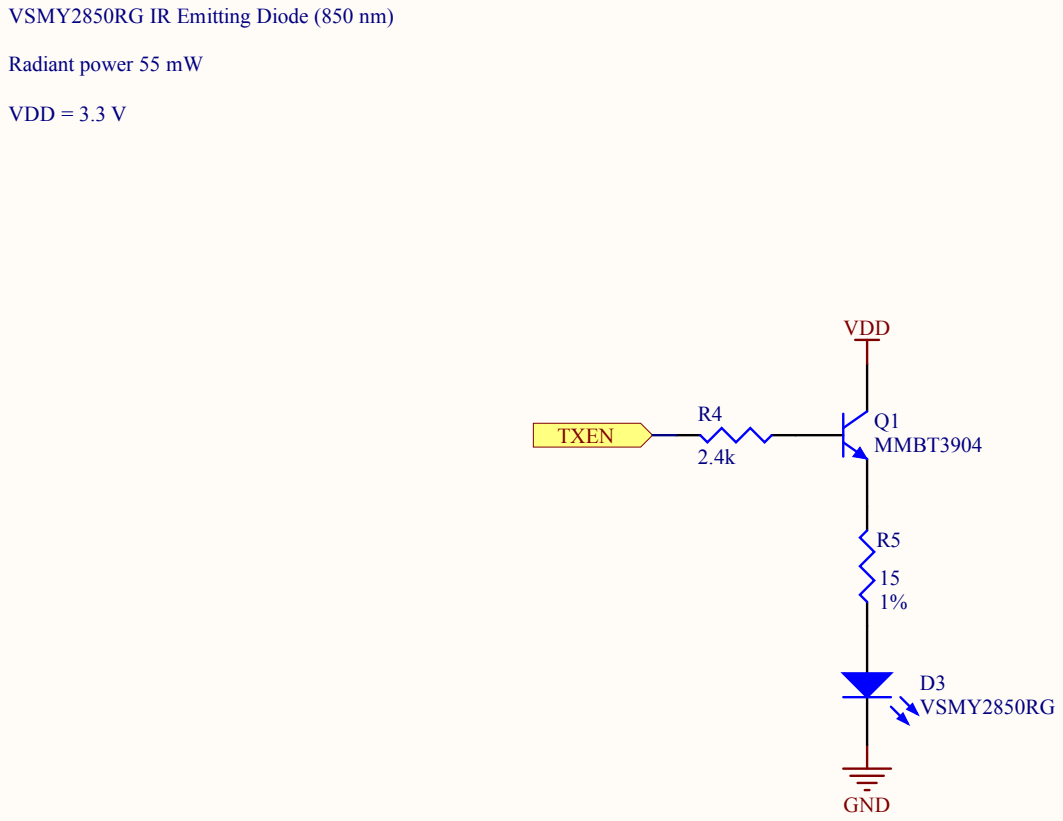
[picture p150: page 2]

VSMY2850RG IR Emitting Diode (850 nm)
