Asaadkaadan/MOWE/Hardware/Modules/PO02R0.pdf

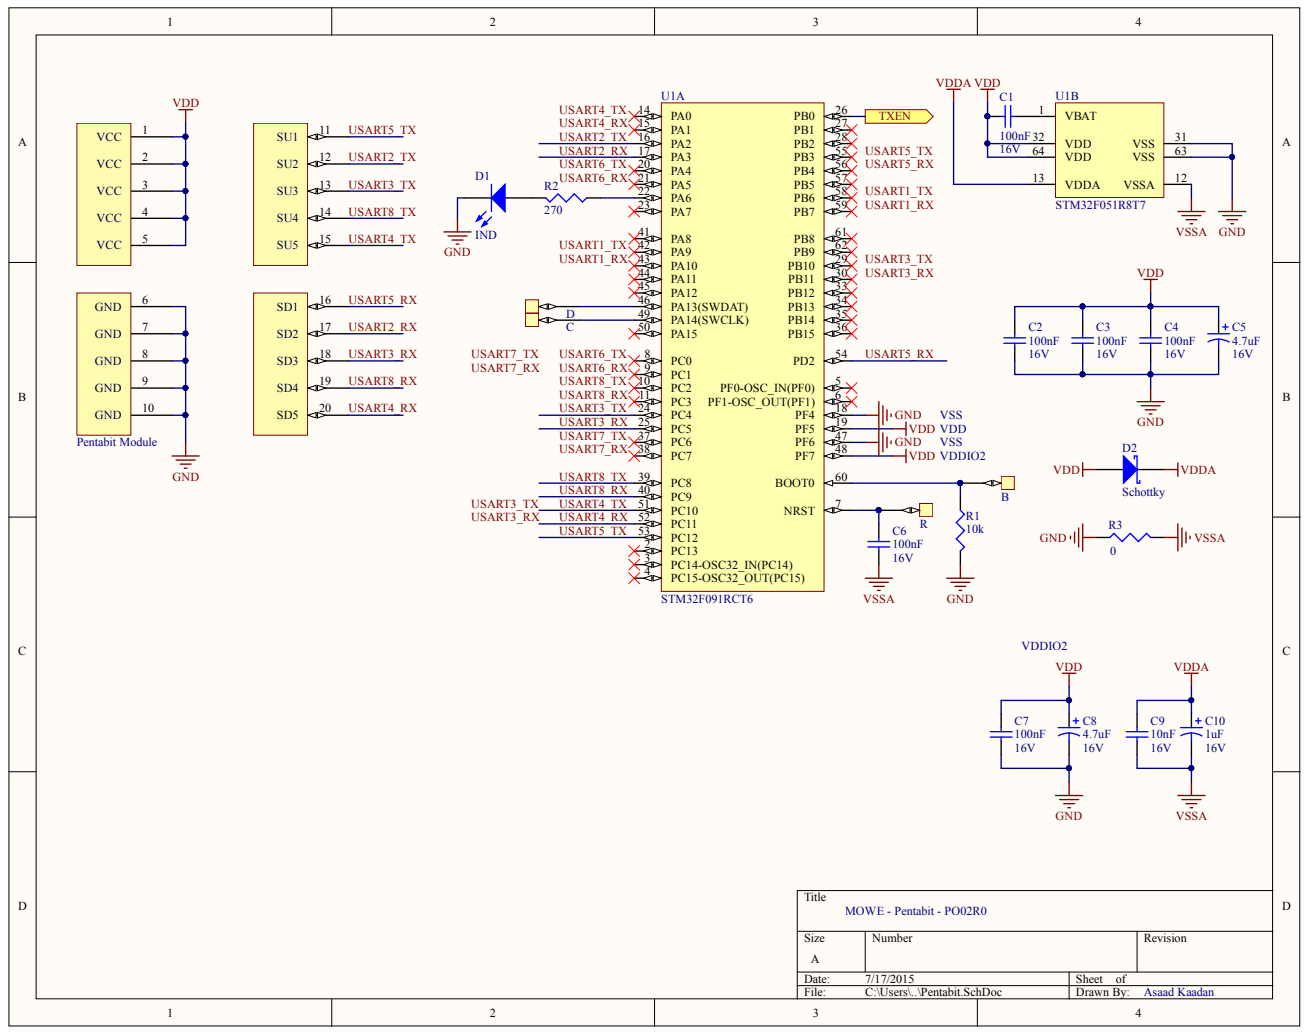
[picture p151: page 1]

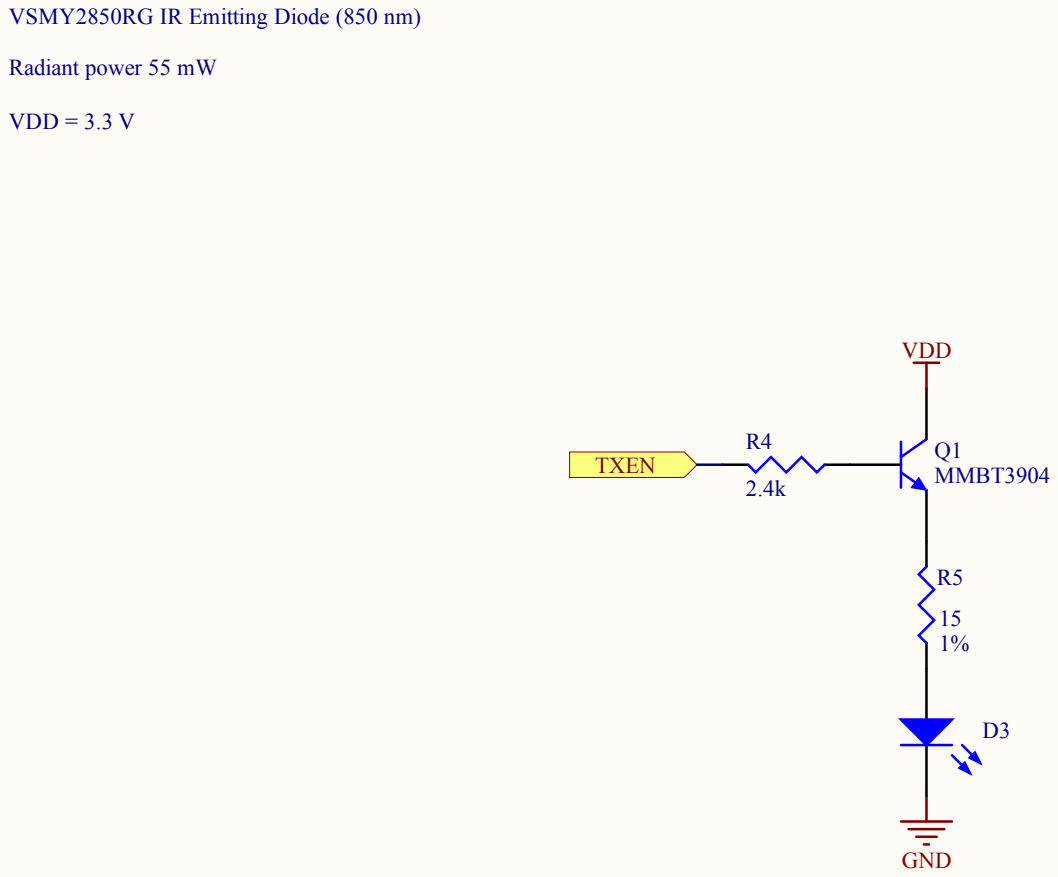
[picture p152: page 2]

VSMY2850RG IR Emitting Diode (850 nm)
