Asaadkaadan/MOWE/Hardware/Modules/HO01R3.pdf

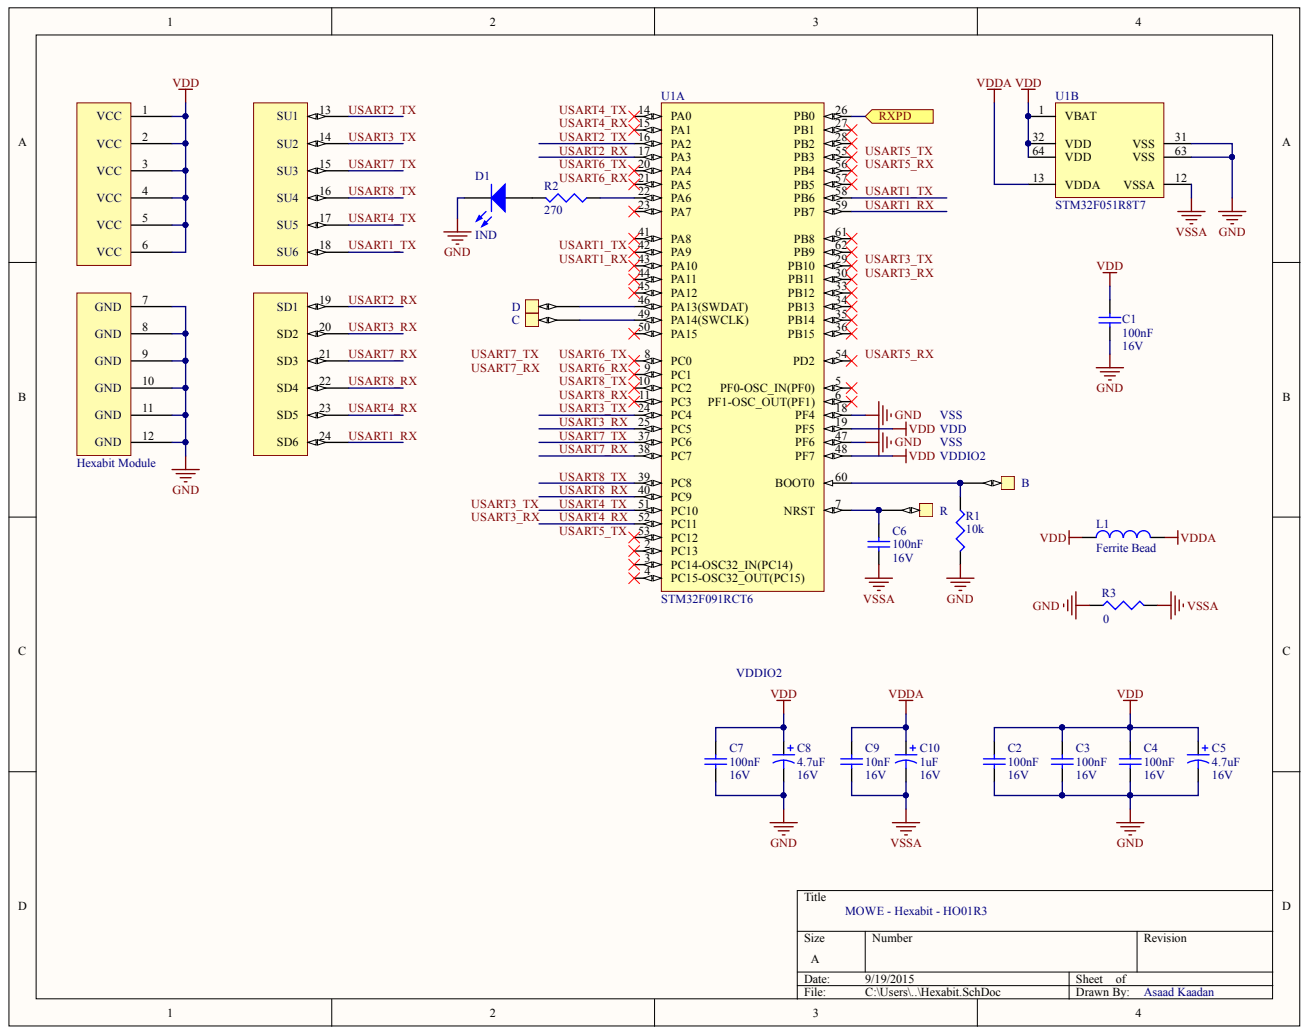
[picture p153: page 1]

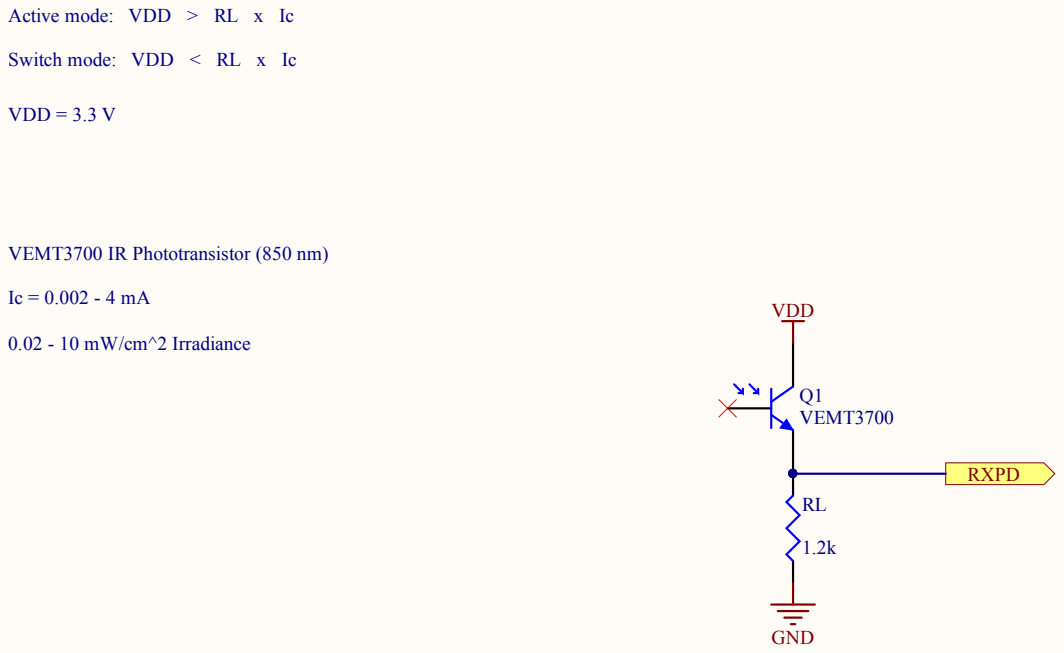
[picture p154: page 2]
