Asaadkaadan/MOWE/Hardware/Modules/HO01R1.pdf

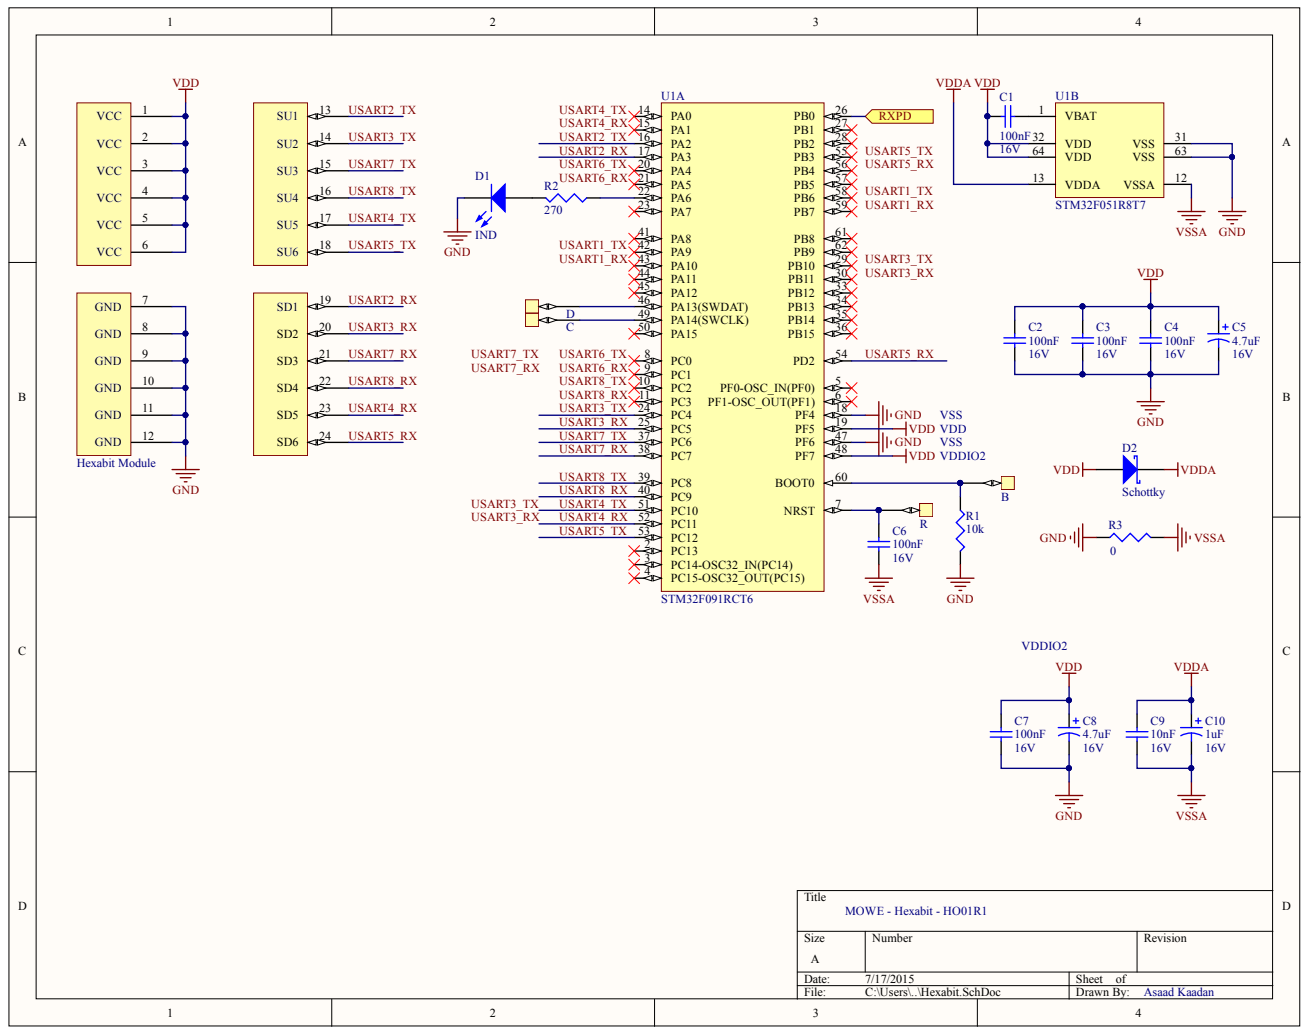
[picture p155: page 1]

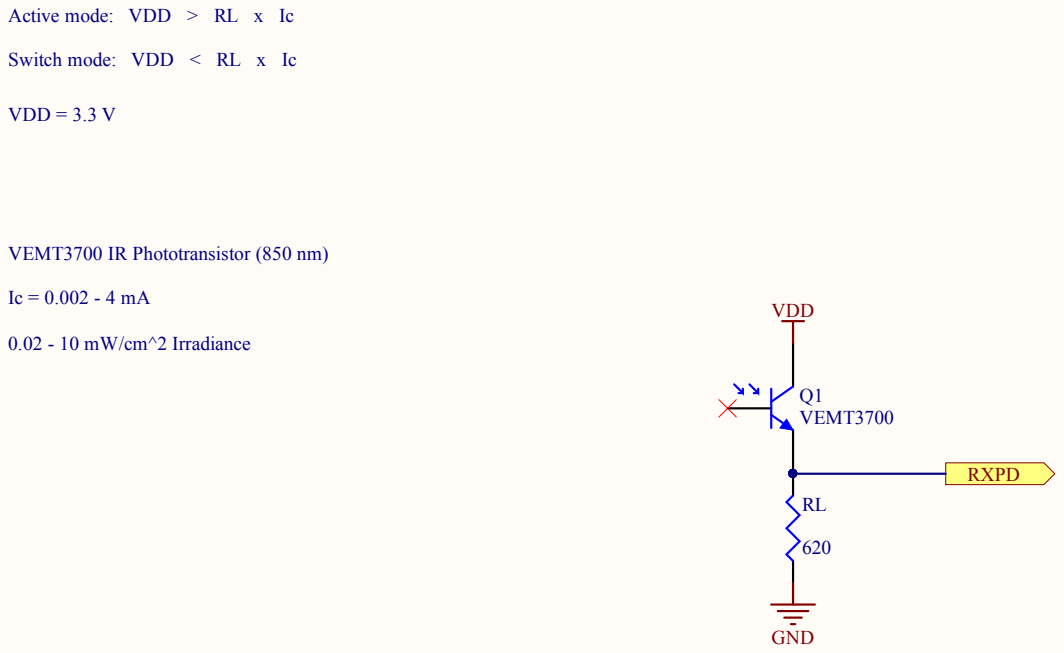
[picture p156: page 2]
