Asaadkaadan/MOWE/Hardware/Modules/HO01R2.pdf

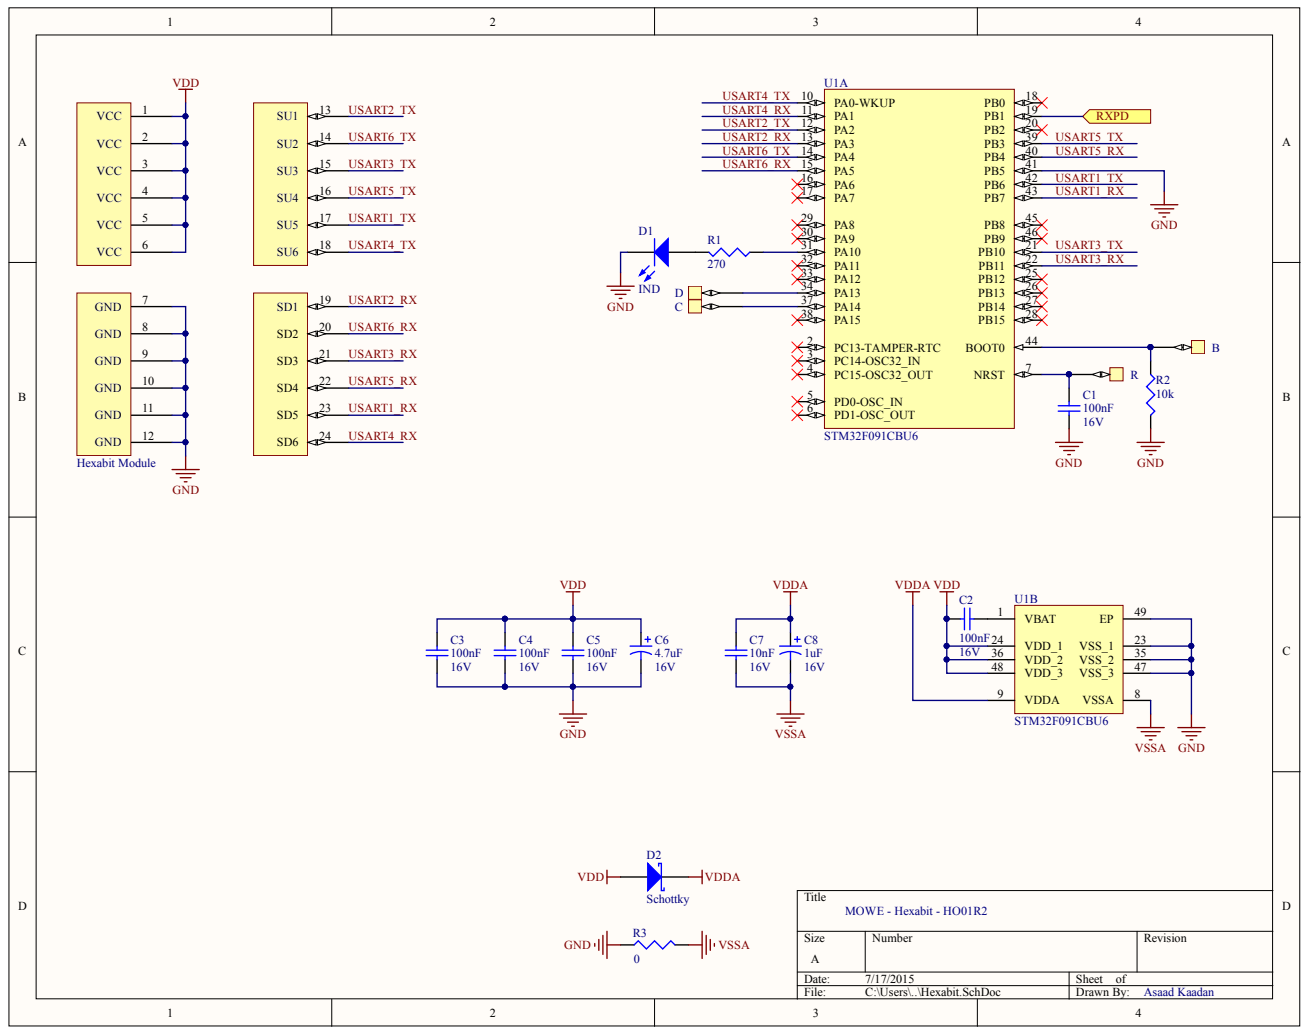
[picture p157: page 1]
