Asaadkaadan/MOWE/Hardware/Modules/PO01R0.pdf

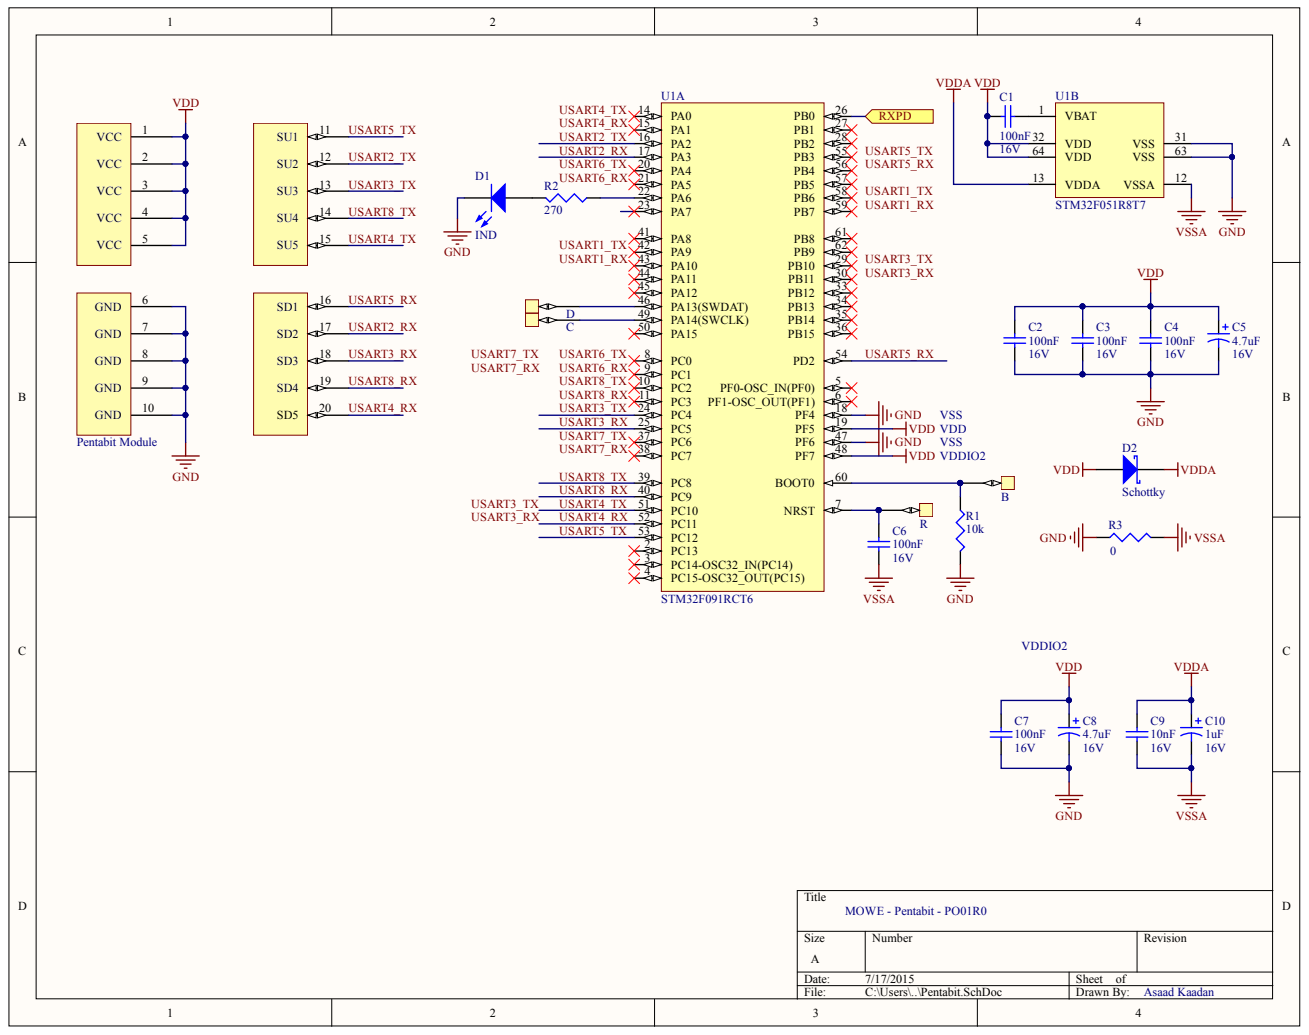
[picture p158: page 1]
