Asaadkaadan/MOWE/Projects/All RX Terminal+Gimbal/Firmware_RX/Src/main.c

/**
  ******************************************************************************
  * File Name          : main.c
  * Created            : 01/05/2016 
  * Version            : 1.0 
 	* Author             : Asaad Kaadan
  * Description        : MOWE main source file.
 	* License            : The MIT Open-source License (MIT). 
  *
  ******************************************************************************
  */
	

/* Includes ------------------------------------------------------------------*/
#include "aos.h"				// AOS

/* Private variables ---------------------------------------------------------*/

uint8_t masterOutPort = 0; float streamingRate = 0; uint8_t ledStatus = 4;
uint8_t streamTest = 0, streamLoose = 0;
uint8_t syncCodeMode0 = 250, syncCodeMode1 = 240, syncCodeMode2 = 235, syncCodeMode3 = 230, syncCodeMode4 = 220;
uint8_t testCodeMode0 = 130, testCodeMode1 = 125, testCodeMode2 = 120, testCodeMode3 = 115, testCodeMode4 = 110; 
uint8_t setInt_thres = 50, ledModeThresCounter = 40;
uint16_t adc = 0; uint16_t int_thres = 200; uint8_t demoMode = 0; float yaw = 0, pitch = 0; 
float moduleLight = 0, backgroundLightAve = 0, backgroundLightMax = 0, backgroundLightAveTotal = 0, backgroundLightMaxTotal = 0;
extern TaskHandle_t FrontEndTaskHandle; 
extern TaskHandle_t MoveGimbalTaskHandle;

#define PI 3.14159265

uint8_t dataBuffer[ArraySize*2] = {	\
0xff,0xff,0xff,0xff,0xff,0xff,0xff,0xff,0xff,0xff,0xff,0xff,0xff,0xff,			\
0xff,0xff,0xff,0xff,0xff,0xff,0xff,0xff,0xff,0xff,0xff,0xff,0xff,0xff,0xff,	\
0xff,0xff,0xff,0xff,0xff,0xff,0xff,0xff,0xff,0xff,0xff,0xff,0xff,0xff,0xff,	\
0xff,0xff,0xff,0xff,0xff,0xff,0xff,0xff,0xff,0xff,0xff,0xff,0xff,0xff,0xff,	\
0xff,0xff,0xff,0xff,0xff,0xff,0xff,0xff,0xff,0xff,0xff,0xff,0xff,0xff,0xff};

/* Module locations (mm) */
float x_module[ArraySize] = {	\
   15.0000,	30.0000,	45.0000,	60.0000,	90.0000,	120.0000,	150.0000,	75.0000,	\
  105.0000,	135.0000,	 165.0000, 45.0000,	60.0000, 90.0000, 120.0000,	150.0000,		\
  180.0000,	75.0000,	105.0000,	135.0000,	165.0000,	195.0000,	30.0000,	60.0000,	\
   90.0000,	120.0000,	150.0000,	180.0000,	75.0000,	105.0000,	135.0000,	165.0000,	\
   45.0000,	60.0000,	90.0000,	120.0000,	150.0000};	
	
float y_module[ArraySize] = {	\
   95.2628, 121.2436, 147.2243, 173.2051, 173.2051, 173.2051, 173.2051, 147.2243,	\
  147.2243, 147.2243, 147.2243, 95.2628, 121.2436, 121.2436, 121.2436, 121.2436,	\
  121.2436, 95.2628, 95.2628, 95.2628, 95.2628, 95.2628, 69.2820, 69.2820, 				\
	69.2820, 69.2820, 69.2820, 69.2820, 43.3013, 43.3013, 43.3013, 43.3013,					\
  43.3013, 17.3205, 17.3205, 17.3205, 17.3205};


/* Private function prototypes -----------------------------------------------*/
void RunDemos(void);

/* Main ----------------------------------------------------------------------*/
int main(void)
{
	/* --- AOS Initialization Section --- */	
	AOS_init();	

	/* --- User Initialization Section --- */		
	// Do something

  /* Call init function for freertos objects (in freertos.c) */
  MX_FREERTOS_Init();

  /* Start scheduler */
  osKernelStart();
			
  /* We should never get here as control is now taken by the scheduler */

  /* Infinite loop */
  while (1)
  {
  }
	
}

/*-----------------------------------------------------------*/

/* FrontEndTask function */
void FrontEndTask(void * argument)
{
	
#if (_module == _master)
	/* Wait indefinitly until the stream is activated by the master */
	ulTaskNotifyTake(pdTRUE, portMAX_DELAY);
#else
	/* Setup the slaves */
	StreamSetup(0, 0);
#endif	
			
  /* Infinite loop */
  for(;;)
  {
		
	#if (_module == _master)
		if ( (streamingRate && myTrig) || (!streamingRate) )
		{		
			if (myTrig) 	myTrig = 0;
			

			
			/* Master transmits a sync code */
			if(!streamTest) {
				if (ledStatus == 0) {
					writePx(P2, (const char *) &syncCodeMode0, 1, HAL_MAX_DELAY);		/* Route A */
					writePx(P3, (const char *) &syncCodeMode0, 1, HAL_MAX_DELAY);		/* Route B */
					writePx(P4, (const char *) &syncCodeMode0, 1, HAL_MAX_DELAY);		/* Route C */
				} else if (ledStatus == 1) {
					writePx(P2, (const char *) &syncCodeMode1, 1, HAL_MAX_DELAY);		/* Route A */
					writePx(P3, (const char *) &syncCodeMode1, 1, HAL_MAX_DELAY);		/* Route B */
					writePx(P4, (const char *) &syncCodeMode1, 1, HAL_MAX_DELAY);		/* Route C */					
				} else if (ledStatus == 2) {
					writePx(P2, (const char *) &syncCodeMode2, 1, HAL_MAX_DELAY);		/* Route A */
					writePx(P3, (const char *) &syncCodeMode2, 1, HAL_MAX_DELAY);		/* Route B */
					writePx(P4, (const char *) &syncCodeMode2, 1, HAL_MAX_DELAY);		/* Route C */		
				} else if (ledStatus == 3) {
					writePx(P2, (const char *) &syncCodeMode3, 1, HAL_MAX_DELAY);		/* Route A */
					writePx(P3, (const char *) &syncCodeMode3, 1, HAL_MAX_DELAY);		/* Route B */
					writePx(P4, (const char *) &syncCodeMode3, 1, HAL_MAX_DELAY);		/* Route C */			
				} else if (ledStatus == 4) {
					writePx(P2, (const char *) &syncCodeMode4, 1, HAL_MAX_DELAY);		/* Route A */
					writePx(P3, (const char *) &syncCodeMode4, 1, HAL_MAX_DELAY);		/* Route B */
					writePx(P4, (const char *) &syncCodeMode4, 1, HAL_MAX_DELAY);		/* Route C */		
				}  	
			} else {
				if (ledStatus == 0) {
					writePx(P2, (const char *) &testCodeMode0, 1, HAL_MAX_DELAY);		/* Route A */
					writePx(P3, (const char *) &testCodeMode0, 1, HAL_MAX_DELAY);		/* Route B */
					writePx(P4, (const char *) &testCodeMode0, 1, HAL_MAX_DELAY);		/* Route C */
				} else if (ledStatus == 1) {
					writePx(P2, (const char *) &testCodeMode1, 1, HAL_MAX_DELAY);		/* Route A */
					writePx(P3, (const char *) &testCodeMode1, 1, HAL_MAX_DELAY);		/* Route B */
					writePx(P4, (const char *) &testCodeMode1, 1, HAL_MAX_DELAY);		/* Route C */					
				} else if (ledStatus == 2) {
					writePx(P2, (const char *) &testCodeMode2, 1, HAL_MAX_DELAY);		/* Route A */
					writePx(P3, (const char *) &testCodeMode2, 1, HAL_MAX_DELAY);		/* Route B */
					writePx(P4, (const char *) &testCodeMode2, 1, HAL_MAX_DELAY);		/* Route C */			
				} else if (ledStatus == 3) {
					writePx(P2, (const char *) &testCodeMode3, 1, HAL_MAX_DELAY);		/* Route A */
					writePx(P3, (const char *) &testCodeMode3, 1, HAL_MAX_DELAY);		/* Route B */
					writePx(P4, (const char *) &testCodeMode3, 1, HAL_MAX_DELAY);		/* Route C */		
				} else if (ledStatus == 4) {
					writePx(P2, (const char *) &testCodeMode4, 1, HAL_MAX_DELAY);		/* Route A */
					writePx(P3, (const char *) &testCodeMode4, 1, HAL_MAX_DELAY);		/* Route B */
					writePx(P4, (const char *) &testCodeMode4, 1, HAL_MAX_DELAY);		/* Route C */								
				}
			}
			
			/* Synchronization - Wait some time to compensate for propagation delay */
			Delay_us(6*4.2);					/* Max array depth is 6 hops */
			
			/* Take ADC sample */
			//adc = HAL_ADC_GetValue(&hadc);
			adc = SamplePD();
			
			/* LED status mode 4: Detect beam */
			if (ledStatus == 4) {
				if (adc >= int_thres)		
					LED_on();
				else	
					LED_off();
			}
			
			
			/* LED status mode 1: Measure streaming rate */
			if (ledStatus == 1)		LED_toggle();
			
			/* Write samples into buffer */
			if (!streamTest) {
				dataBuffer[1] = (uint8_t) adc; 				/* Low byte */
				dataBuffer[0] = (uint8_t) (adc>>8);		/* High byte */
			} else {
				dataBuffer[1] = _module;
				dataBuffer[0] = _module+100;
			}
			
			/* Wait some time to download the data from previous module */
			Delay_us(850);
			
			/* LED status mode 3: Measure download delay */
			if (ledStatus == 3)		LED_on();
			/* Transmit the samples out */
			if (!streamLoose){
				writePxMutex(masterOutPort, (char*) dataBuffer, ArraySize*2, cmd50ms, HAL_MAX_DELAY);		/* 272 usec */
			} else {				
				for(char i=0 ; i < ArraySize ; i++)
				{
					writePxMutex(masterOutPort, (char*) &dataBuffer[2*i], 2, cmd50ms, HAL_MAX_DELAY);
					writePxMutex(masterOutPort, " ", 1, cmd50ms, HAL_MAX_DELAY);
				}
				writePxMutex(masterOutPort, "\n\r", 2, cmd50ms, HAL_MAX_DELAY);
			}
			/* LED status mode 3: Measure download delay */
			if (ledStatus == 3)		LED_off();
			
			/* Automatic calculation of ledmode threshold */
			if (ledModeThresCounter < 30)
			{
				backgroundLightAve = 0;
				backgroundLightMax = 0;
				for(char i=0 ; i < ArraySize ; i++)
				{
					moduleLight = (dataBuffer[2*i]<<8) + dataBuffer[2*i+1];
					backgroundLightAve = backgroundLightAve + moduleLight;
					if (backgroundLightMax < moduleLight)
						backgroundLightMax = moduleLight;
				}
				backgroundLightAve = backgroundLightAve / ArraySize;			
				backgroundLightAveTotal += backgroundLightAve;
				backgroundLightMaxTotal += backgroundLightMax;
				++ledModeThresCounter;
			}
			else if (ledModeThresCounter == 30)
			{
				ledModeThresCounter = 40;
				backgroundLightAveTotal = backgroundLightAveTotal / 30;
				backgroundLightMaxTotal = backgroundLightMaxTotal / 30;
				
				int_thres = backgroundLightMaxTotal + 10;
				osDelay(10);	
				
				/* Send set threshold command */
				writePx(P2, (const char *) &setInt_thres, 1, HAL_MAX_DELAY);		/* Route A */
				writePx(P3, (const char *) &setInt_thres, 1, HAL_MAX_DELAY);		/* Route B */
				writePx(P4, (const char *) &setInt_thres, 1, HAL_MAX_DELAY);		/* Route C */	
				osDelay(1);
				/* Send the new threshold */		
				writePx(P2, (const char *) &int_thres, 1, HAL_MAX_DELAY);		/* Route A */
				writePx(P3, (const char *) &int_thres, 1, HAL_MAX_DELAY);		/* Route B */
				writePx(P4, (const char *) &int_thres, 1, HAL_MAX_DELAY);		/* Route C */
				osDelay(1);			
				writePx(P2, (const char *) &(int_thres)+1, 1, HAL_MAX_DELAY);		/* Route A */
				writePx(P3, (const char *) &(int_thres)+1, 1, HAL_MAX_DELAY);		/* Route B */
				writePx(P4, (const char *) &(int_thres)+1, 1, HAL_MAX_DELAY);		/* Route C */			
				osDelay(10);
			}	
			
			
			if (ledModeThresCounter == 40)
				RunDemos();
			
			/* Reset the buffer */
			memset(dataBuffer, 0xFF, ArraySize*2);
		}
	#else 
		
		osDelay(1);

	#endif	

  }	

}

/*-----------------------------------------------------------*/

/* Sample the slaves and forward data to the master */
void SampleAndForward(void)
{	
	/* LED status mode 2: Measure upload delay */
	if (ledStatus == 2)		LED_off();		
	
	/* Synchronization - Wait some time to compensate for propagation delay */
	/* slave sync delay = max depth - # of hops to the master */
#if (_module == 2)					
	Delay_us(5*4.2);				/* Wait for 5 hops */	
#elif (_module == 3)				
	Delay_us(4*4.2);				/* Wait for 4 hops */		
#elif (_module == 4)				
	Delay_us(3*4.2);				/* Wait for 3 hops */		
#elif (_module == 5)				
	Delay_us(2*4.2);				/* Wait for 2 hops */		
#elif (_module == 6)				
	Delay_us(1*4.2);				/* Wait for 1 hop */		
#elif (_module == 7)				
													/* Wait for 0 hops */		
#elif (_module == 8)				
	Delay_us(3*4.2);				/* Wait for 3 hops */	
#elif (_module == 9)				
	Delay_us(2*4.2);				/* Wait for 2 hops */					
#elif (_module == 10)				
	Delay_us(1*4.2);				/* Wait for 1 hop */	
#elif (_module == 11)				
													/* Wait for 0 hops */	
#elif (_module == 12)					
	Delay_us(5*4.2);				/* Wait for 5 hops */	
#elif (_module == 13)				
	Delay_us(4*4.2);				/* Wait for 4 hops */		
#elif (_module == 14)				
	Delay_us(3*4.2);				/* Wait for 3 hops */		
#elif (_module == 15)				
	Delay_us(2*4.2);				/* Wait for 2 hops */		
#elif (_module == 16)				
	Delay_us(1*4.2);				/* Wait for 1 hop */		
#elif (_module == 17)				
													/* Wait for 0 hops */	
#elif (_module == 18)				
	Delay_us(4*4.2);				/* Wait for 4 hops */		
#elif (_module == 19)				
	Delay_us(3*4.2);				/* Wait for 3 hops */		
#elif (_module == 20)				
	Delay_us(2*4.2);				/* Wait for 2 hops */		
#elif (_module == 21)				
	Delay_us(1*4.2);				/* Wait for 1 hop */		
#elif (_module == 22)				
													/* Wait for 0 hops */	
#elif (_module == 23)					
	Delay_us(5*4.2);				/* Wait for 5 hops */	
#elif (_module == 24)				
	Delay_us(4*4.2);				/* Wait for 4 hops */		
#elif (_module == 25)				
	Delay_us(3*4.2);				/* Wait for 3 hops */		
#elif (_module == 26)				
	Delay_us(2*4.2);				/* Wait for 2 hops */		
#elif (_module == 27)				
	Delay_us(1*4.2);				/* Wait for 1 hop */		
#elif (_module == 28)				
													/* Wait for 0 hops */															
#elif (_module == 29)				
	Delay_us(3*4.2);				/* Wait for 3 hops */		
#elif (_module == 30)				
	Delay_us(2*4.2);				/* Wait for 2 hops */		
#elif (_module == 31)				
	Delay_us(1*4.2);				/* Wait for 1 hop */		
#elif (_module == 32)				
													/* Wait for 0 hops */														
#elif (_module == 33)				
	Delay_us(4*4.2);				/* Wait for 4 hops */		
#elif (_module == 34)				
	Delay_us(3*4.2);				/* Wait for 3 hops */		
#elif (_module == 35)				
	Delay_us(2*4.2);				/* Wait for 2 hops */		
#elif (_module == 36)				
	Delay_us(1*4.2);				/* Wait for 1 hop */		
#elif (_module == 37)				
													/* Wait for 0 hops */																										
#endif	


	/* Take ADC sample */
	//adc = HAL_ADC_GetValue(&hadc);
	adc = SamplePD();
	
	/* LED status mode 4: Detect beam */
	if (ledStatus == 4) {
		if (adc >= int_thres)		
			LED_on();
		else	
			LED_off();
	}
	
	/* LED status mode 1: Measure streaming rate */
	if (ledStatus == 1)		LED_toggle();

	
#if (_module == 2)	
	/* Write samples into buffer */
	if (!streamTest) {
		dataBuffer[3] = (uint8_t) adc; 				/* Low byte */
		dataBuffer[2] = (uint8_t) (adc>>8);		/* High byte */	
	} else {
		dataBuffer[3] = _module;
		dataBuffer[2] = _module+100;
	}
	/* Wait some time to download the data from previous module */
	Delay_us(490);
	/* LED status mode 3: Measure download delay */
	if (ledStatus == 3)		LED_on();
	/* Transmit the samples back */
	writePxMutex(inport, (char *) &dataBuffer[2], 20, cmd50ms, HAL_MAX_DELAY);		/* 85 usec */

#elif (_module == 3)
	/* Write samples into buffer */
	if (!streamTest) {
		dataBuffer[5] = (uint8_t) adc; 				/* Low byte */
		dataBuffer[4] = (uint8_t) (adc>>8);		/* High byte */	
	} else {
		dataBuffer[5] = _module;
		dataBuffer[4] = _module+100;
	}
	/* Wait some time to download the data from previous module */
	Delay_us(264);
	/* LED status mode 3: Measure download delay */
	if (ledStatus == 3)		LED_on();
	/* Transmit the samples back */
	writePxMutex(inport, (char*) &dataBuffer[4], 18, cmd50ms, HAL_MAX_DELAY);		/* 78 usec */
	
#elif (_module == 4)
	/* Write samples into buffer */
	if (!streamTest) {
		dataBuffer[7] = (uint8_t) adc; 				/* Low byte */
		dataBuffer[6] = (uint8_t) (adc>>8);		/* High byte */	
	} else {
		dataBuffer[7] = _module;
		dataBuffer[6] = _module+100;
	}
	/* Wait some time to download the data from previous module */
	Delay_us(160);
	/* LED status mode 3: Measure download delay */
	if (ledStatus == 3)		LED_on();
	/* Transmit the samples back */
	writePxMutex(inport, (char*) &dataBuffer[6], 8, cmd50ms, HAL_MAX_DELAY);		/* 45 usec */
	
#elif (_module == 5)
	/* Write samples into buffer */
	if (!streamTest) {
		dataBuffer[9] = (uint8_t) adc; 				/* Low byte */
		dataBuffer[8] = (uint8_t) (adc>>8);		/* High byte */	
	} else {
		dataBuffer[9] = _module;
		dataBuffer[8] = _module+100;
	}
	/* Wait some time to download the data from previous module */
	Delay_us(84);
	/* LED status mode 3: Measure download delay */
	if (ledStatus == 3)		LED_on();
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
#elif (_module == 6)
	DownlinkDMA1_Setup(GetUart(P3), 2, 12);
#elif (_module == 7)
	
#elif (_module == 8)	
	DownlinkDMA1_Setup(GetUart(P3), 6, 16);
#elif (_module == 9)
	DownlinkDMA1_Setup(GetUart(P3), 4, 18);
#elif (_module == 10)
	DownlinkDMA1_Setup(GetUart(P3), 2, 20);
#elif (_module == 11)	

#elif (_module == 12)
	DownlinkDMA1_Setup(GetUart(P2), 10, 24);
	DownlinkDMA2_Setup(GetUart(P3), 10, 34);
#elif (_module == 13)	
	DownlinkDMA1_Setup(GetUart(P3), 8, 26);
#elif (_module == 14)
	DownlinkDMA1_Setup(GetUart(P3), 6, 28);
#elif (_module == 15)
	DownlinkDMA1_Setup(GetUart(P3), 4, 30);
#elif (_module == 16)	
	DownlinkDMA1_Setup(GetUart(P3), 2, 32);
#elif (_module == 17)	

#elif (_module == 18)	
	DownlinkDMA1_Setup(GetUart(P3), 8, 36);
#elif (_module == 19)
	DownlinkDMA1_Setup(GetUart(P3), 6, 38);
#elif (_module == 20)
	DownlinkDMA1_Setup(GetUart(P3), 4, 40);
#elif (_module == 21)	
	DownlinkDMA1_Setup(GetUart(P3), 2, 42);
#elif (_module == 22)	

#elif (_module == 23)
	DownlinkDMA1_Setup(GetUart(P3), 18, 46);
	DownlinkDMA2_Setup(GetUart(P4), 10, 64);
#elif (_module == 24)
	DownlinkDMA1_Setup(GetUart(P3), 8, 48);
	DownlinkDMA2_Setup(GetUart(P4), 8, 56);
#elif (_module == 25)	
	DownlinkDMA1_Setup(GetUart(P3), 6, 50);
#elif (_module == 26)
	DownlinkDMA1_Setup(GetUart(P3), 4, 52);
#elif (_module == 27)
	DownlinkDMA1_Setup(GetUart(P3), 2, 54);
#elif (_module == 28)	
	
#elif (_module == 29)	
	DownlinkDMA1_Setup(GetUart(P3), 6, 58);
#elif (_module == 30)
	DownlinkDMA1_Setup(GetUart(P3), 4, 60);
#elif (_module == 31)
	DownlinkDMA1_Setup(GetUart(P3), 2, 62);
#elif (_module == 32)	

#elif (_module == 33)	
	DownlinkDMA1_Setup(GetUart(P4), 8, 66);
#elif (_module == 34)	
	DownlinkDMA1_Setup(GetUart(P3), 6, 68);
#elif (_module == 35)
	DownlinkDMA1_Setup(GetUart(P3), 4, 70);
#elif (_module == 36)
	DownlinkDMA1_Setup(GetUart(P3), 2, 72);
#elif (_module == 37)		
	
#endif

	/* Start the stream */
#if (_module == _master)	
	if (streamingRate) {
		startPerEvent( floor((48*1000000)/streamingRate) );
	}
	/* Activate the FrontEnd task */
	xTaskNotifyGive(FrontEndTaskHandle);
#endif
}


/*-----------------------------------------------------------*/

/* Run RX demonstrations */
void RunDemos(void)
{
	uint16_t intval[ArraySize] = {0}; static uint8_t counter = 0;
	long intsum = 0; float x_int = 0, y_int = 0, x_err = 0, y_err = 0;
	//uint8_t temp = 0;
	const float arm = 60;		/* mm */
	
	switch (demoMode)
	{
		
		case 4 :	/* Demo4 */
			
			++counter;
		
			if (counter > 5)
			{
				counter = 0;
				
				/* Measured intensity values */
				for(char i=0 ; i < ArraySize ; i++)
				{
					intval[i] = (dataBuffer[2*i]<<8) + dataBuffer[2*i+1];
				}
				
				/* Calculate center of mass (intensity) */
				for(char i=0 ; i < ArraySize ; i++)
				{
					x_int = x_int + intval[i] * x_module[i];
					y_int = y_int + intval[i] * y_module[i];
					intsum = intsum + intval[i];
				}
				x_int = x_int / intsum;
				y_int = y_int / intsum;
				
				/* Distance error from module 19 */
				x_err = x_int - x_module[18];
				y_err = y_int - y_module[18];
				
				/* Calculate yaw and pitch angles */
				yaw = atan2(x_err,arm) * 180 / PI;
				pitch = atan2(y_err,arm) * 180 / PI;
				if (abs(yaw) < 3)	yaw = 0;
				if (abs(pitch) < 3)	pitch = 0;
				
				/* Command gimbal */
				if (yaw != 0 || pitch != 0)
				{
//					temp = 6; writePx(P5, (const char *) &temp, 1, HAL_MAX_DELAY); osDelay(10);
//					temp = 25+90; writePx(P5, (const char *) &temp, 1, HAL_MAX_DELAY); osDelay(10);
//					temp = 25+90; writePx(P5, (const char *) &temp, 1, HAL_MAX_DELAY);
					
//					GetUart(P5)->Instance->TDR = 6;	osDelay(10);;	/* Move at a specific angle */
//					GetUart(P5)->Instance->TDR = 25+90; osDelay(10);	/* yaw */
//					GetUart(P5)->Instance->TDR = 25+90; 		/* pitch */
					
					/* Activate the MoveGimbal task */
					xTaskNotifyGive(MoveGimbalTaskHandle);
					
					
//						/* 1 : Command gimbal to go straight */
//						GetUart(P5)->Instance->TDR = 7;
				}
				
			}
			
			break;
		
		default:
			break;
	}	
	
}

/* MoveGimbalTask function */
void MoveGimbalTask(void * argument)
{

	/* Infinite loop */
  for(;;)
  {
		/* Wait indefinitly until the task is needed */
		ulTaskNotifyTake(pdTRUE, portMAX_DELAY);
	
		GetUart(P5)->Instance->TDR = 6;	osDelay(10);;											/* Move at a specific angle */
		GetUart(P5)->Instance->TDR = 2*yaw + 90; osDelay(10);							/* yaw */
		GetUart(P5)->Instance->TDR = -2*pitch + 90; osDelay(5);						/* pitch */
			
	}
	
}

/************************ (C) COPYRIGHT OU *****END OF FILE****/
