Asaadkaadan/MOWE/(commit log)

2015-08-03 Sample Fully-Connected Netowrks
2016-04-27 Sphere Mechanical folder
    [HO01R1.SLDPRT, Makerbolt_mod.SLDPRT, PO02R0.SLDPRT, Sphere Frame.SLDASM, Truncated icosahedron shell.SLDPRT, Truncated icosahedron.SLDPRT, sphere_30mm.SLDASM]
2016-04-29 Tube Array2
2016-05-18 Servo project
